edgarvela-soc/vsensor_v4_temp/images/pp1_vsensor_v4_back_NoSD.jpg

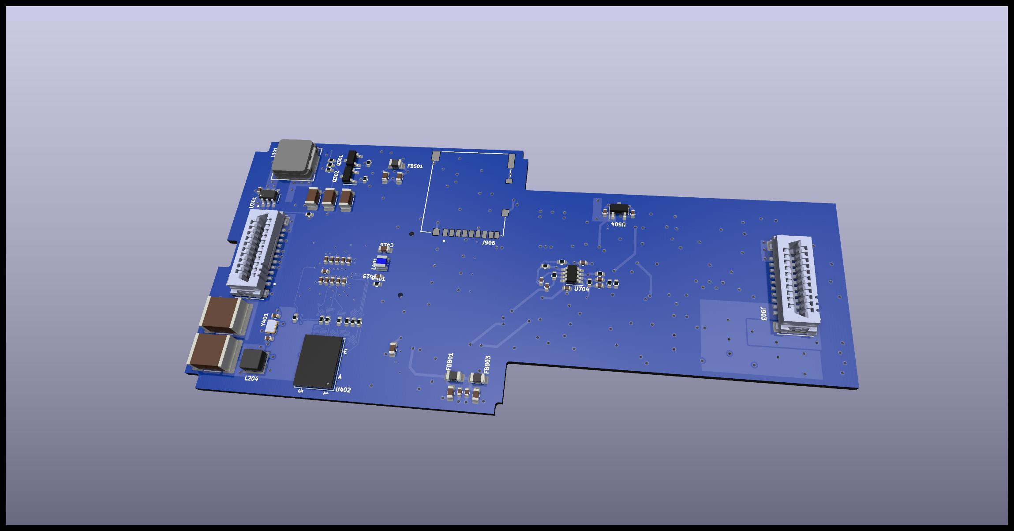
images/pp1_vsensor_v4_back_NoSD.jpg
