edgarvela-soc/vsensor_v4_temp/docs/issues.md

# Issue List

- Polarity inverted of OpAmp (U701, U702 & U704)
