edgarvela-soc/vsensor_v4_temp/docs/filter/link.txt

https://tools.analog.com/en/filterwizard/
