edgarvela-soc/vsensor_v4_temp/docs/Iftest_Report/SWOX1.0320 Erstmusterprüfbericht P1.pdf

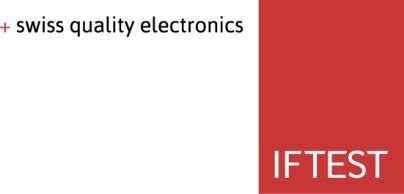
[picture p3: figure]

# QHB │ Erstmusterprüfbericht

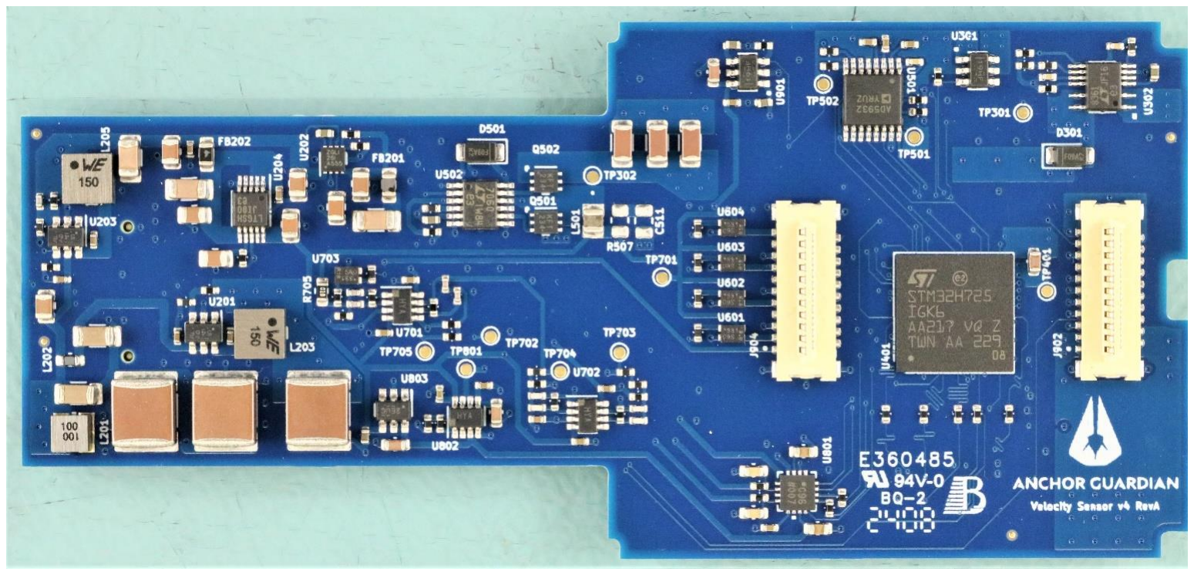
[picture p4: figure]

Hinweis bei Kopien: Gültig ist jeweils nur eine aktuelle
Kopie des im elektronischen QHB abgelegten Original! | K4│FORM 05.11│FBLAV│08.01.19│Ersatz für: NEU│1/2
Autor | Fernando Rauch
| Tel +41 56 437 32 42
| fernando.rauch@iftest.ch
Datum | 01.03.24
Kundendaten | | Iftest
Firma | Swiss Ocean Tech Ltd. | Artikel-Nr. | SP090526
Name | Stephan Nigg | Produktionsauftrag-Nr. | 1000031604
Bezeichnung | pp1 V Sensor v4
Art-Nr. | /
Bestell-Nr. | /

Foto Top-Seite

# QHB │ Erstmusterprüfbericht

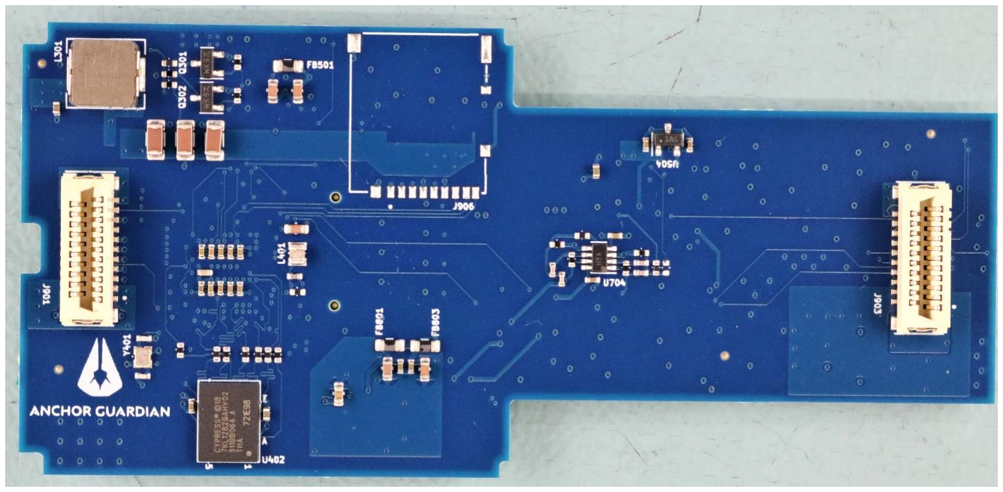
[picture p5: figure]

Hinweis bei Kopien: Gültig ist jeweils nur eine aktuelle
Kopie des im elektronischen QHB abgelegten Original! | K4│FORM 05.11│FBLAV│08.01.19│Ersatz für: NEU│2/2

Foto Bottom-Seite

Bericht

Im Produktionsprozess sind uns folgende Punkte aufgefallen. Mit der Umsetzung der empfohlenen Massnahmen helfen Sie uns die Produktionsqualität zu verbessern oder ggf. die Kosten zu senken.

Nr Befund | Empfohlene Massnahme/ Vorschlag
1) | U501 fehlt auf Bestückungszeichnung | Verbesserung der Bestückungszeichnung.
2) | diverse Bauteile Polarität unklar | Verbesserung der Bestückungszeichnung.
3) Positionen nicht immer gut erkennbar.
| Grösse der Zeichnung. | Verbesserung der Bestückungszeichnung. Vergrössern.

Wir behalten uns vor, Mehraufwände infolge nicht umgesetzter Massnahmen/ Vorschläge, bei einem Folgeauftrag zu verrechnen.
