edgarvela-soc/vsensor_v4_temp/docs/Timer_Overview.xlsx

 |  |  |  |  |  |  |  |  |  | TIMx internal trigger connection
Usage | Timer Type | Timer | Width | Counter Type | DMA Req Gen | Rep Cnt | Chan | Comp Out | Slave | ITR0 | ITR1 | ITR2 | ITR3 | ITR4 | ITR5 | ITR6 | ITR7 | ITR8 | ITR9 | ITR10 | ITR11 | ITR12 | ITR13
 | Adv. Control | TIM1 | 16 | Up, Down, Up/Down | yes | y (16b) | 4 | yes | y | TIM15 | TIM2 | TIM3 | TIM4 | - |  |  |  |  |  |  |  | TIM23 | TIM24
 | General Purp | TIM2 | 32 | Up, Down, Up/Down | yes | n | 4 | no | y | TIM1 | TIM8 | TIM3 | TIM4 | ETH PPS | USB1 OTG_ HS_ SOF | - | - | - | - | - | - | TIM23 | TIM24
 | General Purp | TIM3 | 16 | Up | yes | n | 4 | No | y | TIM1 | TIM2 | TIM15 | TIM4 | ETH PPS | - | - | - | - | - | - | - | TIM23 | TIM24
 | General Purp | TIM4 | 16 | Up | yes | n | 4 | No | y | TIM1 | TIM2 | TIM3 | TIM8 | - | - | - | - | - | - | - | - | TIM23 | TIM24
 | General Purp | TIM5 | 32 | Up, Down, Up/Down | yes | n | 4 | no | y | TIM1 | TIM8 | TIM3 | TIM4 | - | - | fdcan1 _soc | USB1 OTG_ HS_ SOF | - | - | - | - | TIM23 | TIM24
 | Basic | TIM6 | 16 | Up | yes | n | 0 | No | n
 | Basic | TIM7 | 16 | Up | yes | n | 0 | No | n
 | Adv. Control | TIM8 | 16 | Up, Down, Up/Down | yes | y (16b) | 4 | yes | y | TIM1 | TIM2 | TIM4 | TIM5 | - |  |  |  |  |  |  |  | TIM23 | TIM24
ADC SPI | General Purp | TIM12 | 16 | Up | No | n | 2 | No | y | TIM4 | TIM5 | TIM13 OC1 | TIM14 OC1
 | General Purp | TIM13 | 16 | Up | No | n | 1 | No | n
 | General Purp | TIM14 | 16 | Up | No | n | 1 | No | n
 | General Purp | TIM15 | 16 | Up | Yes | y (8b) | 2 | 1 | y | TIM1 | TIM3 | TIM16 OS1 | TIM17 OC1
 | General Purp | TIM16 | 16 | Up | Yes | y (8b) | 1 | 1 | n
 | General Purp | TIM17 | 16 | Up | Yes | y (8b) | 1 | 1 | n
 | General Purp | TIM23 | 32 | Up, Down, Up/Down | yes | n | 4 | no | y | TIM1 | TIM2 | TIM3 | TIM4 | TIM5 | TIM8 | TIM12 | TIM13 _OC1 | TIM14 _OC1 | TIM15 | TIM16 _OC1 | TIM17 _OC1 | - | TIM24
 | General Purp | TIM24 | 32 | Up, Down, Up/Down | yes | n | 4 | no | y | TIM1 | TIM2 | TIM3 | TIM4 | TIM5 | TIM8 | TIM12 | TIM13 _OC1 | TIM14 _OC1 | TIM15 | TIM16 _OC1 | TIM17 _OC1 | TIM23 | -
