edgarvela-soc/vsensor_v4_temp/pp1_vsensor_v4.png

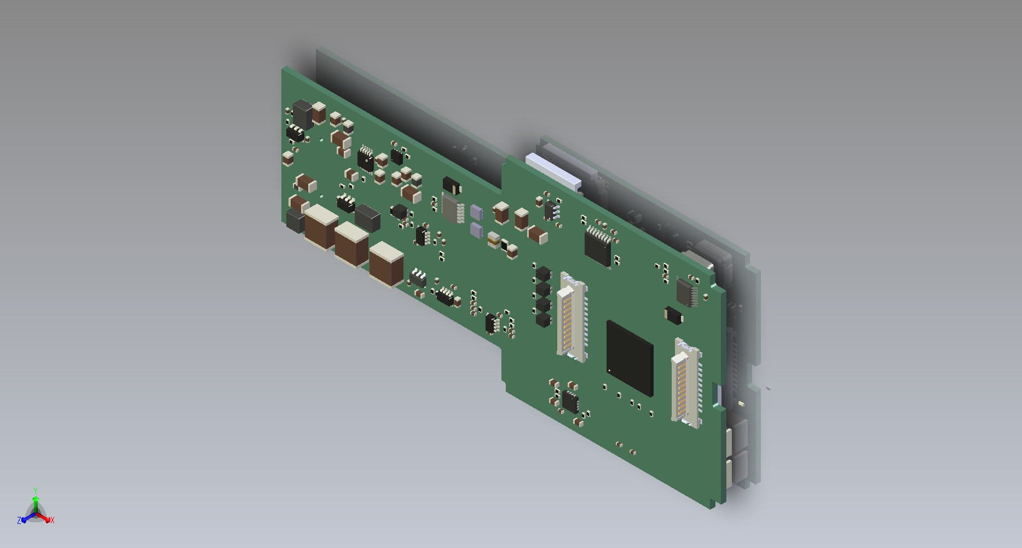
pp1_vsensor_v4.png
