edgarvela-soc/vsensor_v4_temp/BOM/pp1_vsensor_v4_RevA.xlsx

Source: | pp1_vsensor_v4
Date: | 2024-02-19
Tool: | Eeschema 7.0.10
Component Count: | 221
Component Groups: | 76
Ref | Qnty | Value | FP Lib | Footprint | MPN | Digikey_PN | Mouser_PN | Note | DNP | Description
C201, C206, C213, C214, C215, C218, C403, C404, C405, C406, C407, C408, C409, C410, C411, C412, C419, C501, C504, C506, C513, C515, C707, C714, C715, C716, C717, C718, C719, C801, C805, C812, C813, C814, C904 | 35 | 100n | Capacitor_SMD | C_0402_1005Metric | CC0402KRX7R9BB104 | 311-3566-1-ND |  |  |  | Unpolarized capacitor, small symbol
C202, C203, C207 | 3 | 22u | Capacitor_SMD | C_2220_5650Metric | C5750X7R1H226M250KB | 445-C5750X7R1H226M250KBCT-ND |  |  |  | 22u, 2220, 50V, 20%, X7R
C204, C205 | 2 | 4u7 | Capacitor_SMD | C_1206_3216Metric | GRM31CR71H475KA12K | 490-GRM31CR71H475KA12KCT-ND |  |  |  | Unpolarized capacitor, small symbol
C208, C209, C211, C220, C223, C225, C226 | 7 | 4u7 | Capacitor_SMD | C_0805_2012Metric | CGA4J3X5R1H475K125AB | 445-7882-1-ND | 810-CGA4J3X5R1H475K |  |  | Unpolarized capacitor, small symbol
C210, C304, C305, C420, C507, C512, C809, C901, C902 | 9 | 1u | Capacitor_SMD | C_0402_1005Metric | UMK105CBJ105MV-F | 587-6278-1-ND |  |  |  | Unpolarized capacitor, small symbol
C212, C219, C222 | 3 | 47u | Capacitor_SMD | C_1206_3216Metric | C3216X5R1C476M160AB | 445-6003-1-ND |  |  |  | 47uF, 1206, 16V, 20%, X5R
C216 | 1 | 39p | Capacitor_SMD | C_0402_1005Metric | CC0402FRNPO9BN390 | 311-3733-1-ND |  | NP0 |  | Unpolarized capacitor, small symbol
C217 | 1 | 2u2 | Capacitor_SMD | C_0805_2012Metric | CGA4J1X7R1V225K125AC | 445-6963-1-ND |  |  |  | Unpolarized capacitor, small symbol
C301, C302, C303, C508, C509, C510 | 6 | 1.5u | Capacitor_SMD | C_1206_3216Metric | C3216X7S2A155K160AB | 445-14816-1-ND | 810-C3216X7S2A155K1B |  |  | Unpolarized capacitor, small symbol
C306 | 1 | 2.2n | Capacitor_SMD | C_0402_1005Metric | C0402C222J5RAC7867 | 399-C0402C222J5RAC7867CT-ND |  |  |  | Unpolarized capacitor, small symbol
C307, C502 | 2 | 10n | Capacitor_SMD | C_0402_1005Metric | GCM155R71H103KA55D | 399-C0402C222J5RAC7867CT-ND |  |  |  | Unpolarized capacitor, small symbol
C401, C402 | 2 | 9p | Capacitor_SMD | C_0402_1005Metric | GRM1555C1H9R0BA01D | 490-6257-1-ND |  |  |  | Unpolarized capacitor, small symbol
C413 | 1 | 4u7 | Capacitor_SMD | C_0402_1005Metric | 04023D475MAT2A | 478-04023D475MAT2ACT-ND |  |  |  | Unpolarized capacitor, small symbol
C415 | 1 | 220p | Capacitor_SMD | C_0402_1005Metric | 0402N221J500CT | 1292-1286-1-ND |  |  |  | Unpolarized capacitor, small symbol
C416, C421, C503, C505, C802, C810, C811, C815, C903 | 9 | 10u | Capacitor_SMD | C_0603_1608Metric | GRM188R61E106MA73D | 490-7202-1-ND | 81-GRM188R61E106MA3D |  |  | Unpolarized capacitor, small symbol
C511 | 1 | tbd | Capacitor_SMD | C_0805_2012Metric |  |  |  |  | DNP | Unpolarized capacitor, small symbol
C701, C704, C708, C711 | 4 | 15p | Capacitor_SMD | C_0402_1005Metric | CC0402JRNPO9BN150 | 311-1017-1-ND |  |  |  | Unpolarized capacitor, small symbol
C702, C705, C709, C712 | 4 | 20p | Capacitor_SMD | C_0402_1005Metric | CC0402JRNPO9BN200 | 311-1417-1-ND |  |  |  | Unpolarized capacitor, small symbol
C703, C706, C710, C713 | 4 | 24p | Capacitor_SMD | C_0402_1005Metric | CC0402JRNPO9BN240 | 311-1348-1-ND |  |  |  | Unpolarized capacitor, small symbol
C803, C804, C806 | 3 | 1u | Capacitor_SMD | C_0603_1608Metric | 06035C105KAT2A | 478-10073-1-ND |  |  |  | Unpolarized capacitor, small symbol
C807, C808 | 2 | 2n7 | Capacitor_SMD | C_0603_1608Metric | CC0603KRX7R9BB272 | 311-1809-1-ND |  |  |  | Unpolarized capacitor, small symbol
D301, D501 | 2 | DFLS2100-7 | Diode_SMD | D_PowerDI-123 | DFLS2100-7 | DFLS2100-7DICT-ND |  |  |  | DIODE SCHOTTKY 100V 2A PWRDI123
FB201, FB202, FB501, FB801, FB803 | 5 | 2.2k/200mA | Inductor_SMD | L_0805_2012Metric | 742792093 | 732-1609-1-ND |  |  |  | 2.2 kOhms @ 100 MHz 0805 (2012 metrisch) 200mA 600mOhm WE-CBF
J901, J903 | 2 | 10162581-3134121LF | SOC_Connector_SMD | AMPHENOL_10162581-3134121LF | 10162581-3134121LF | 609-10162581-3134121LFCT-ND |  |  |  | Conan® Lite 1.00mm 21pin F
J902, J904 | 2 | 10162582-1134121LF | SOC_Connector_SMD | AMPHENOL_10162582-1134121LF | 10162582-1134121LF | 609-10162582-1134121LFCT-ND |  |  |  | Conan® Lite 1.00mm 21pin M
J906 | 1 | uSD_DM3AT | SOC_SMD | HRS_DM3AT-SF-PEJM5 | DM3AT-SF-PEJM5 | HR1964CT-ND |  |  | DNP
L201 | 1 | 10u | Inductor_SMD | L_Wuerth_MAPI-3020 | 74438336100 | 732-5700-1-ND |  |  |  | 10 µH shielded Inductor 1.2 A 322mOhm Max 1212 (3030 metric)
L202 | 1 | 470nH | Inductor_SMD | L_0603_1608Metric | LQM18PNR47NC0L | 490-LQM18PNR47NC0LCT-ND |  |  |  | 470 nH Geschirmt Mehrschichtig Induktor 850 mA 187,5mOhm Max 0603 (1608 metrisch)
L203, L205 | 2 | 15u 1.9A | Inductor_SMD | L_Wuerth_MAPI-4020 | 74438356150 | 732-11663-1-ND |  |  |  | FIXED IND 15UH 1.9A 230MOHM SMD
L301 | 1 | 8u2 | SOC_SMD | IND25X25CZ | IHLP2525CZER8R2M01 | 541-1012-1-ND |  |  |  | 8.2 µH Shielded Molded Inductor 4 A 68mOhm Max Nonstandard
L401 | 1 | 2.2u | SOC_SMD | Inductor_0806 | DFE201612PD-2R2M=P2 | 490-18072-1-ND | 81-DFE201612PD2R2P2 |  |  | FIXED IND 12UH 1.3A 135 MOHM SMD
L501 | 1 | 1u/4.2A | SOC_SMD | RES_CIGT201610 | CIGT201610EH1R0MNE | 1276-6900-1-ND |  |  |  | FIXED IND 12UH 1.3A 135 MOHM SMD
Q301, Q302 | 2 | PMV45EN2 | Package_TO_SOT_SMD | SOT-23 | PMV45EN2R | 1727-2307-1-ND | 771-PMV45EN2R |  |  | N-Channel 30 V 4.1A (Ta) 510mW (Ta), 5W (Tc) Surface Mount TO-236AB
Q501, Q502 | 2 | SSM6K361NU | SOC_SMD | UDFN6B_TOS | SSM6K361NU,LF | SSM6K361NULFCT-ND |  |  |  | MOSFET N-CH 100V 3.5A 6UDFNB
R201 | 1 | 69k8 | Resistor_SMD | R_0402_1005Metric | RC0402FR-0769K8L | YAG3216CT-ND |  |  |  | Resistor, small symbol
R202 | 1 | 91k | Resistor_SMD | R_0402_1005Metric | RC0402FR-0791KL | 311-91.0KLRCT-ND |  |  |  | Resistor, small symbol
R203, R209, R305 | 3 | 22k1 | Resistor_SMD | R_0402_1005Metric | RC0402FR-0722K1L | 311-22.1KLRCT-ND |  |  |  | Resistor, small symbol
R204, R210, R702, R713 | 4 | 40k2 | Resistor_SMD | R_0402_1005Metric | RC0402FR-0740K2L | 311-40.2KLRCT-ND |  |  |  | Resistor, small symbol
R207 | 1 | 102k | Resistor_SMD | R_0402_1005Metric | RC0402FR-07102KL | YAG2944CT-ND |  |  |  | Resistor, small symbol
R208, R309, R310, R311, R501, R502, R505, R703, R712, R720, R912 | 11 | 68k1 | Resistor_SMD | R_0402_1005Metric | RC0402FR-0768K1L | YAG3213CT-ND |  |  |  | Resistor, small symbol
R301 | 1 | 1M | Resistor_SMD | R_0402_1005Metric | CRGCQ0402F1M0 | A129663CT-ND |  |  |  | Resistor, small symbol
R302 | 1 | 34k8 | Resistor_SMD | R_0402_1005Metric | RMCF0402FT34K8 | RMCF0402FT34K8CT-ND |  |  |  | Resistor, small symbol
R303, R701 | 2 | 71k5 | Resistor_SMD | R_0402_1005Metric | RC0402FR-0771K5L | YAG3222CT-ND |  |  |  | Resistor, small symbol
R304 | 1 | 130k | Resistor_SMD | R_0402_1005Metric | RC0402FR-07130KL | YAG2969CT-ND |  |  |  | Resistor, small symbol
R306 | 1 | 0R | Resistor_SMD | R_0402_1005Metric | RC0402JR-070RL | 311-0.0JRCT-ND |  |  |  | Resistor, small symbol
R307, R308, R401, R714, R715, R721, R722, R806, R807 | 9 | 10k | Resistor_SMD | R_0402_1005Metric | RC1005F103CS | 1276-3431-1-ND |  |  |  | Resistor, small symbol
R402, R403, R404, R405, R406, R407, R408, R409, R410, R411, R412, R413, R503, R504 | 14 | 33R | Resistor_SMD | R_0402_1005Metric | RC0402JR-0733RL | 311-33JRCT-ND |  |  |  | Resistor, small symbol
R506 | 1 | 36k5 | Resistor_SMD | R_0402_1005Metric | ERJ-2RKF3652X | P36.5KLCT-ND |  |  |  | Resistor, small symbol
R507 | 1 | 2R | Resistor_SMD | R_0805_1608Metric | RMCF0603FT2R00 | RMCF0603FT2R00CT-ND |  |  | DNP | Resistor, small symbol
R601, R602, R603, R604, R710 | 5 | 270R | Resistor_SMD | R_0402_1005Metric | RMCF0402FT270R | RMCF0402FT270RCT-ND |  |  |  | Resistor, small symbol
R704 | 1 | 20k5 | Resistor_SMD | R_0402_1005Metric | RC0402FR-0720K5L | YAG3052CT-ND |  |  |  | Resistor, small symbol
R705 | 1 | 100k | Resistor_SMD | R_0603_1608Metric | RC0402FR-07100KL | 311-100KLRCT-ND |  |  |  | Resistor, small symbol
R706 | 1 | 19k6 | Resistor_SMD | R_0402_1005Metric | RC0402FR-0719K6L | YAG3026CT-ND |  |  |  | Resistor, small symbol
R707, R709, R717, R718 | 4 | 2k55 | Resistor_SMD | R_0402_1005Metric | RC0402FR-072K55L | YAG3102CT-ND |  |  |  | Resistor, small symbol
R708 | 1 | 1k58 | Resistor_SMD | R_0402_1005Metric | RC0402FR-071K58L | YAG3041CT-ND |  |  |  | Resistor, small symbol
R711, R719 | 2 | 1k47 | Resistor_SMD | R_0402_1005Metric | RC0402FR-071K47L | YAG3038CT-ND |  |  |  | Resistor, small symbol
R716 | 1 | 0R | Resistor_SMD | R_0402_1005Metric | RC0402JR-070RL | 311-0.0JRCT-ND |  |  | DNP | Resistor, small symbol
R801, R802 | 2 | 20R | Resistor_SMD | R_0402_1005Metric | RC0402FR-0720RL | 311-20LRCT-ND |  |  |  | Resistor, small symbol
R803, R804 | 2 | 100R | Resistor_SMD | R_0402_1005Metric | RC0402FR-07100RL | 311-100LRCT-ND |  |  |  | Resistor, small symbol
U201, U203 | 2 | LMR54406 | Package_TO_SOT_SMD | SOT-23-6 | LMR54406FDBVR | 296-LMR54406FDBVRCT-ND | 595-LMR54406FDBVR |  |  | Schaltspannungsregler SIMPLE SWITCHER power converter 4.5-V to 36-V, 0.6-A, synchronous buck with 80-uA IQ
U202 | 1 | LM27761 | Package_SON | WSON-8-1EP_2x2mm_P0.5mm_EP0.9x1.6mm | LM27761DSGR | 296-44379-1-ND |  |  |  | low-noise regulated switched-capacitor voltage inverter with 2.7V-5.5V input to -1.5 to -5V Output Voltage, WSON-8
U204 | 1 | LT3042EMSE | Package_SO | MSOP-10-1EP_3x3mm_P0.5mm_EP1.68x1.88mm | LT3042EMSE#TRPBF | LT3042EMSE#TRPBFCT-ND | 584-LT3042EMSE#TRPBF |  |  | 200mA, Adjustable, Ultralow Noise, Ultrahigh PSRR RF Linear Regulator, MSOP-10
U301, U901 | 2 | TPS22810DBV | SOC_SMD | SOT95P280X145-6N | TPS22810TDBVRQ1 | 296-50496-1-ND |  |  |  | 2.7-18V, 79mohms On-Resistance Load Switch With Thermal Protection, SOT23-6
U302 | 1 | LT8361 | SOC_SMD | SOP50P490X110-17N | LT8361HMSE#PBF | 505-LT8361HMSE#PBF-ND |  |  |  | IC REG Boost SEPIC 2A 16MSOP
U401 | 1 | STM32H725IGK6 | Package_BGA | UFBGA-201_10x10mm_Layout15x15_P0.65mm | STM32H725IGK6 | 497-STM32H725IGK6-ND |  |  |  | STMicroelectronics Arm Cortex-M7 MCU, 1024KB flash, 564KB RAM, 550 MHz, 1.62-3.6V, 132 GPIO, UFBGA176
U402 | 1 | S70KL1282 | SOC_BGA | S27KS0642GABHV020_1 | S70KL1282GABHV020 | 448-S70KL1282GABHV020-ND |  |  |  | PSRAM (Pseudo-SRAM) Speicher IC 64Mbit HyperBus 200 MHz 35 ns 24-FBGA (6x8)
U501 | 1 | AD5932YRUZ | SOC_SMD | AD5932YRUZ | AD5932YRUZ | 505-AD5932YRUZ-ND | 584-AD5932YRUZ
U502 | 1 | LTC7060IMSE-PBF | SOC_SMD | LTC7060 | LTC7060IMSE#WTRPBF | 505-LTC7060EMSE#WPBF-ND | 584-7060IMSE#WTRPBF
U504 | 1 | TLV760_12 | Package_TO_SOT_SMD | SOT-23 | TLV76012DBZR | 296-48331-1-ND
U601, U602, U603, U604, U703 | 5 | TLP3409STP_E | SOC_SMD | TLP3409STP_E | TLP3409S(TP,E | TLP3409S(TPECT-ND | 757-TLP3409STPE |  |  | SSR RELAY SPST-NO 650MA 0-100V
U701, U702, U704, U802 | 4 | AD8039 | Package_TO_SOT_SMD | SOT-23-8 | AD8039ARTZ-REEL7 | 505-AD8039ARTZ-REEL7CT-ND |  |  |  | IC OPAMP VFB 2 CIRCUIT SOT23-8
U801 | 1 | AD7383 | SOC_SMD | AD7383 | AD7383BCPZ-RL7 | 505-AD7383BCPZ-RL7CT-ND |  |  |  | 16 Bit Analog to Digital Converter 2 Input 2 SAR 16-LFCSP (3x3)
U803 | 1 | REF3430 | SOC_SMD | REF3430 | REF3430TIDBVR | 296-REF3430TIDBVRCT-ND
Y401 | 1 | ECX-1637_25MHz | SOC_SMD | XTAL_ECS-160-9-37-CKM-TR | ECS-250-8-37-RWN-TR | XC2484CT-ND |  |  |  | 25 MHz ±10ppm Crystal 8pF 80 Ohms 4-SMD, No Lead
