edgarvela-soc/vsensor_v4_temp/docs/Inital_operation_measurement.docx

Setting: VSEL0_Pin = 0, VSEL1_Pin = 1

36.4V on Driver

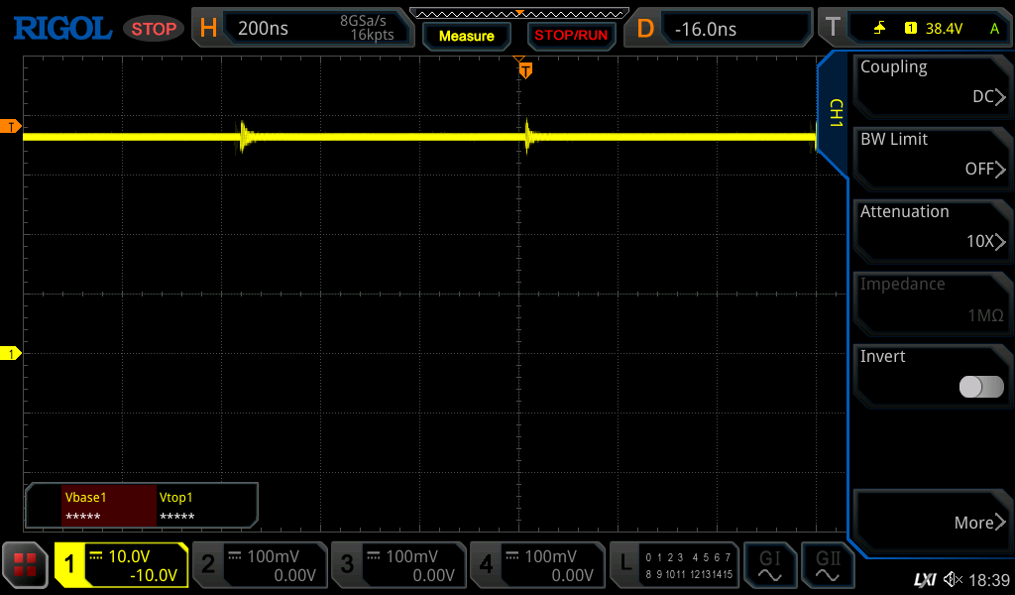
[picture p7: figure]

TP701

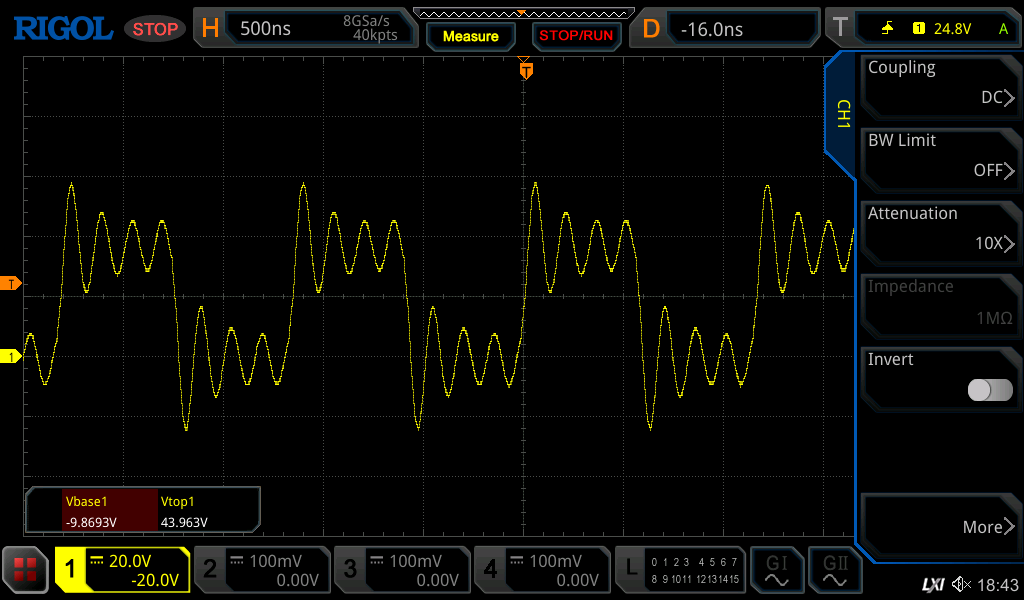
[picture p8: figure]

TP705

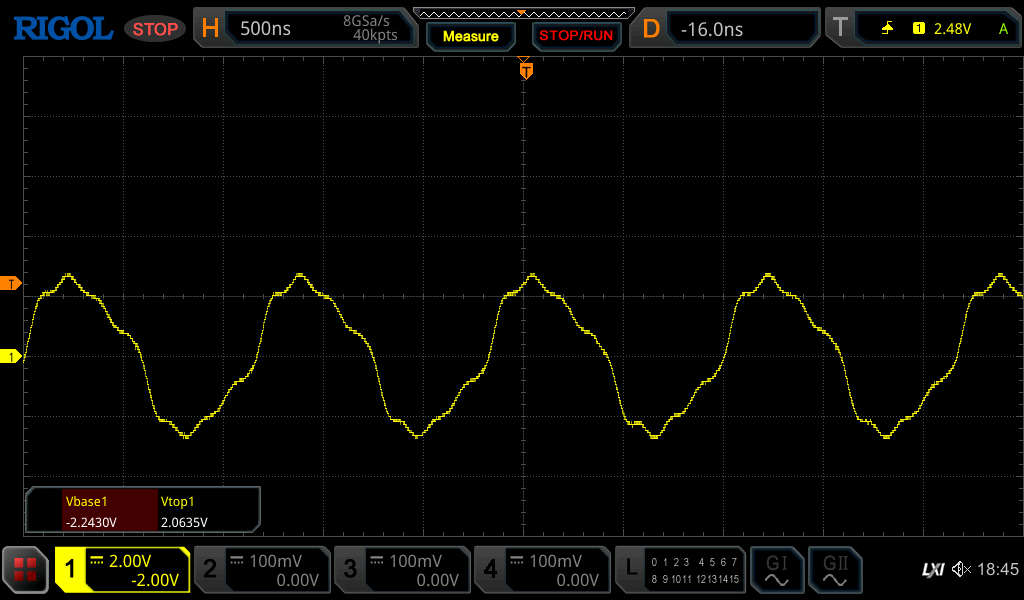
[picture p9: figure]

TP704

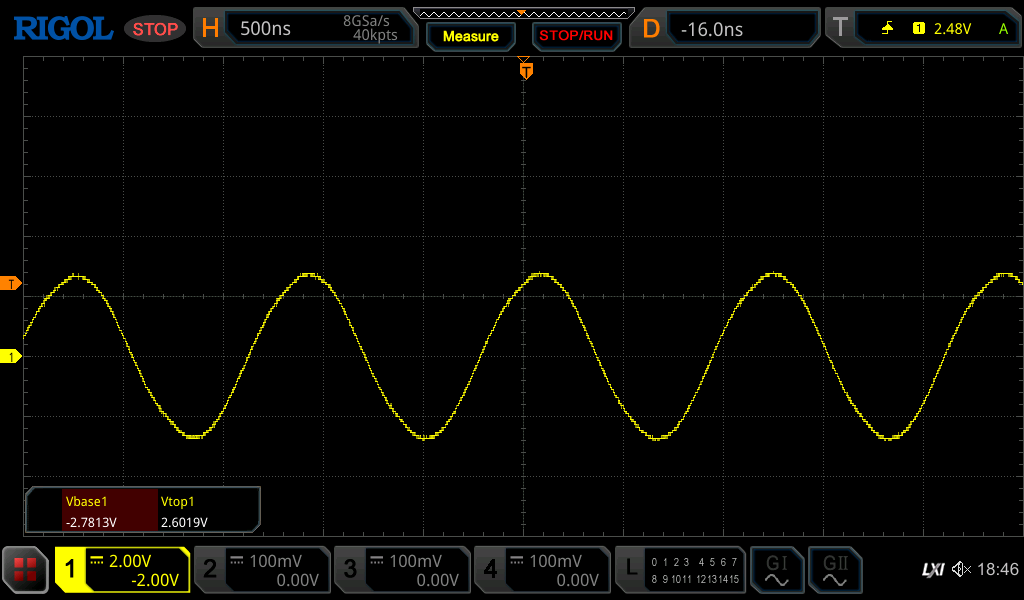
[picture p10: figure]

ADC1_IN

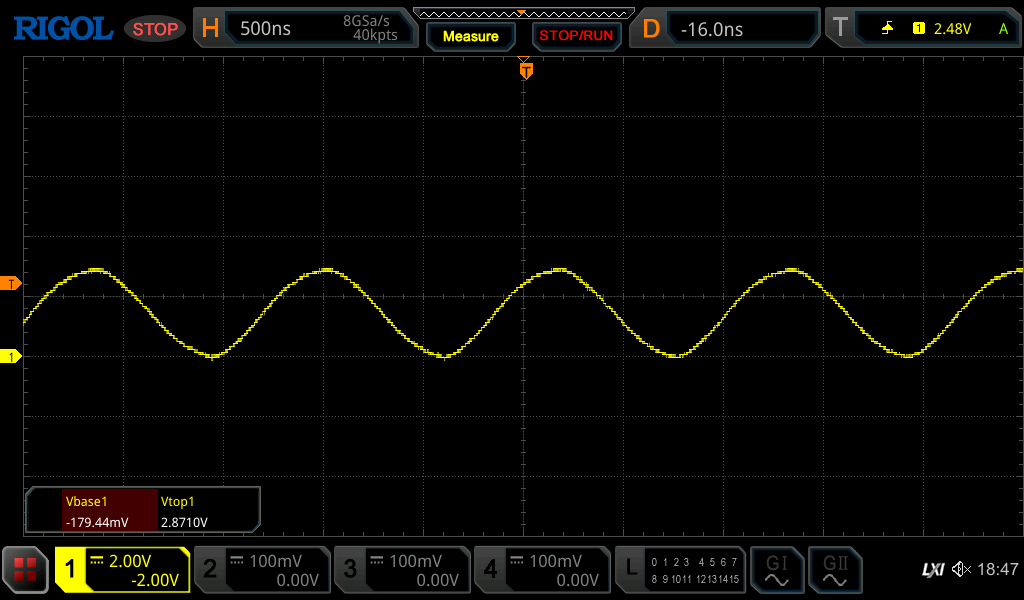
[picture p11: figure]

Input attenuation enabled (AFE_GAIN2_Pin = 1)

TP705

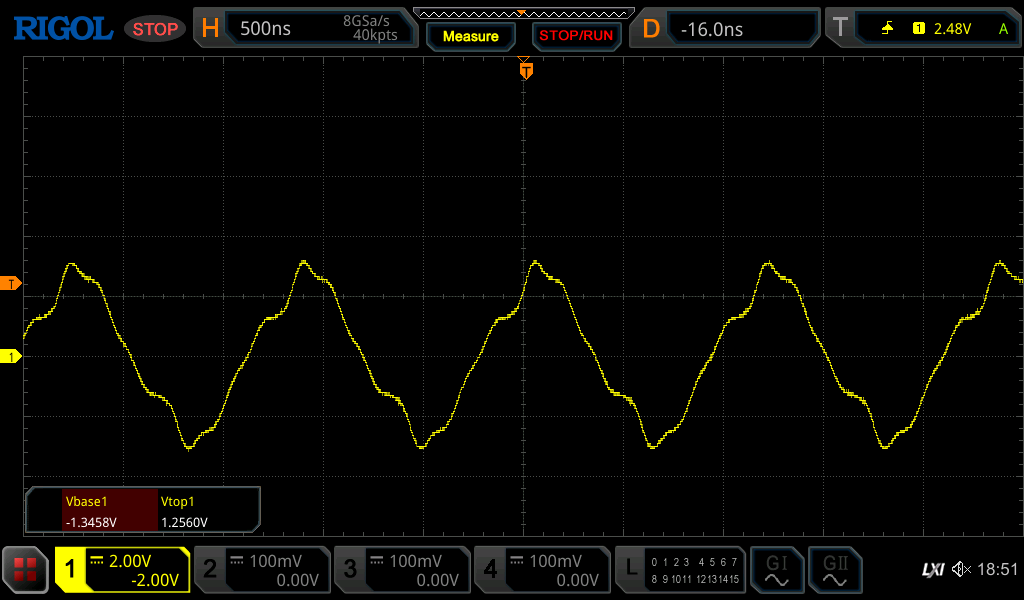
[picture p12: figure]

TP704

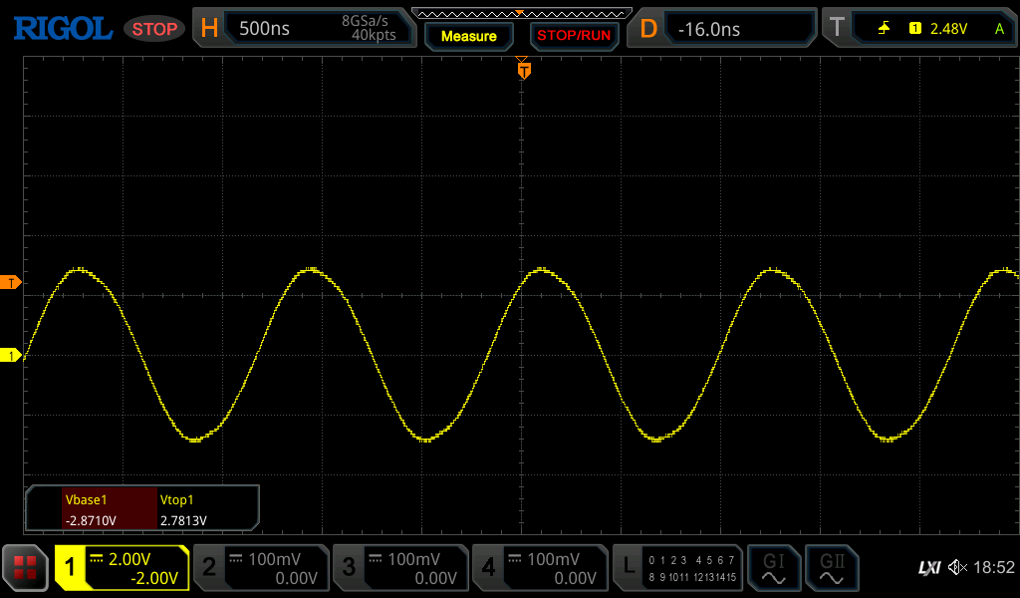
[picture p13: figure]

ADC1_IN

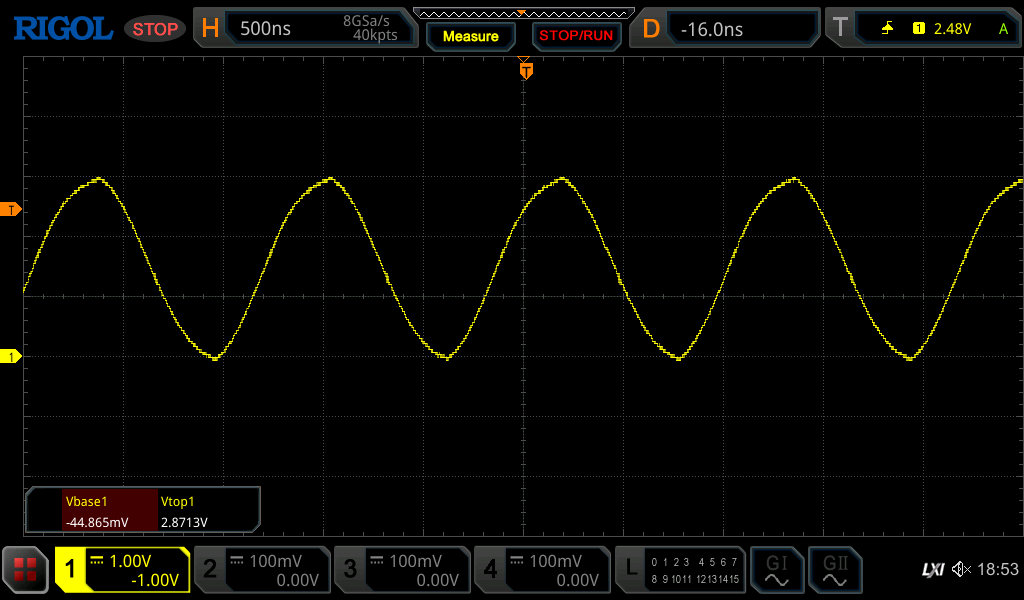
[picture p14: figure]

60V (59.8V)

Transducer (questioable probe attenuation 20x or 10x ???)

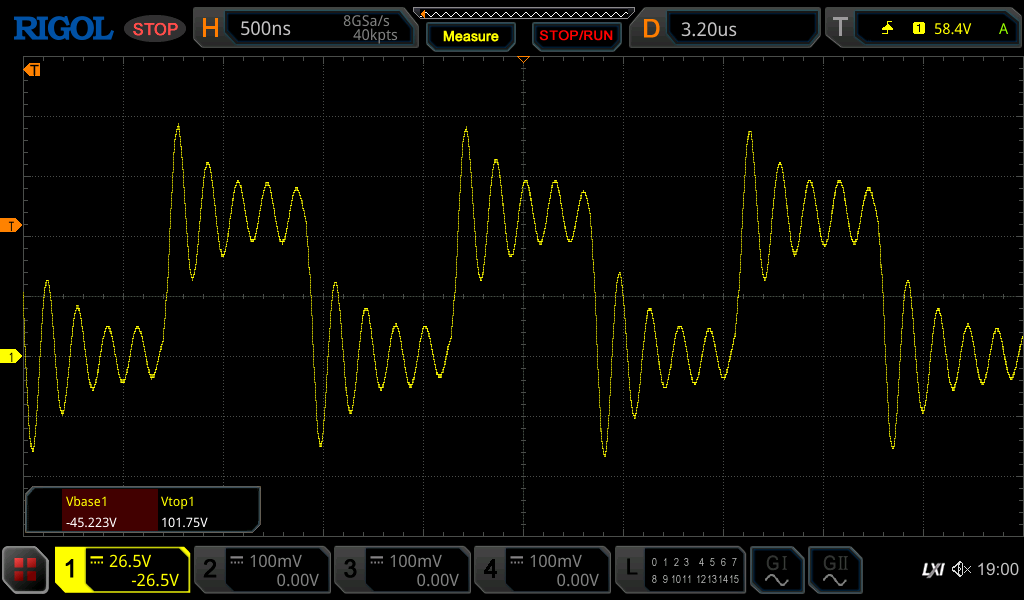
[picture p15: figure]

TP701

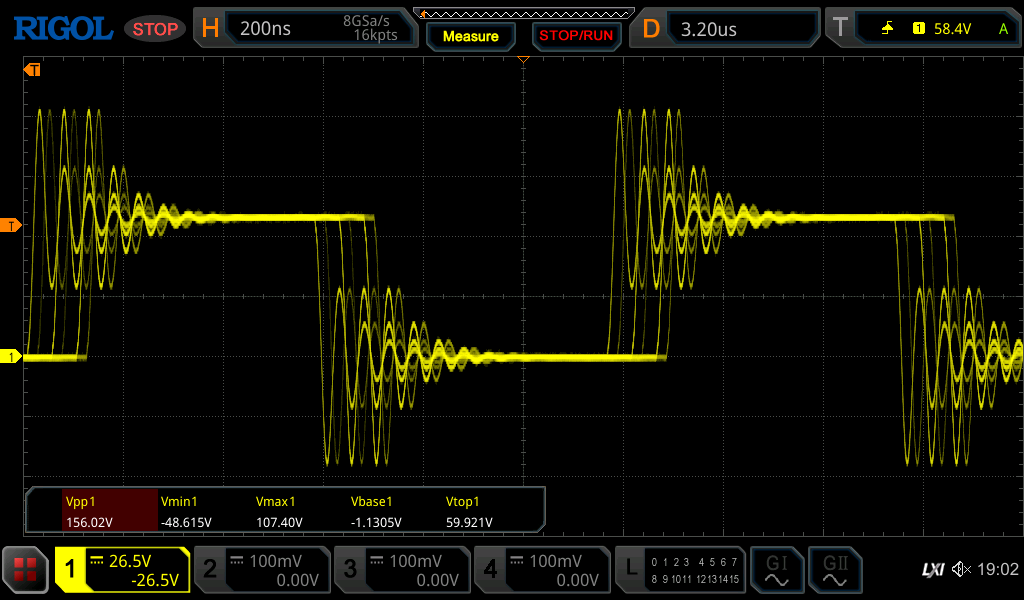
[picture p16: figure]

TP705

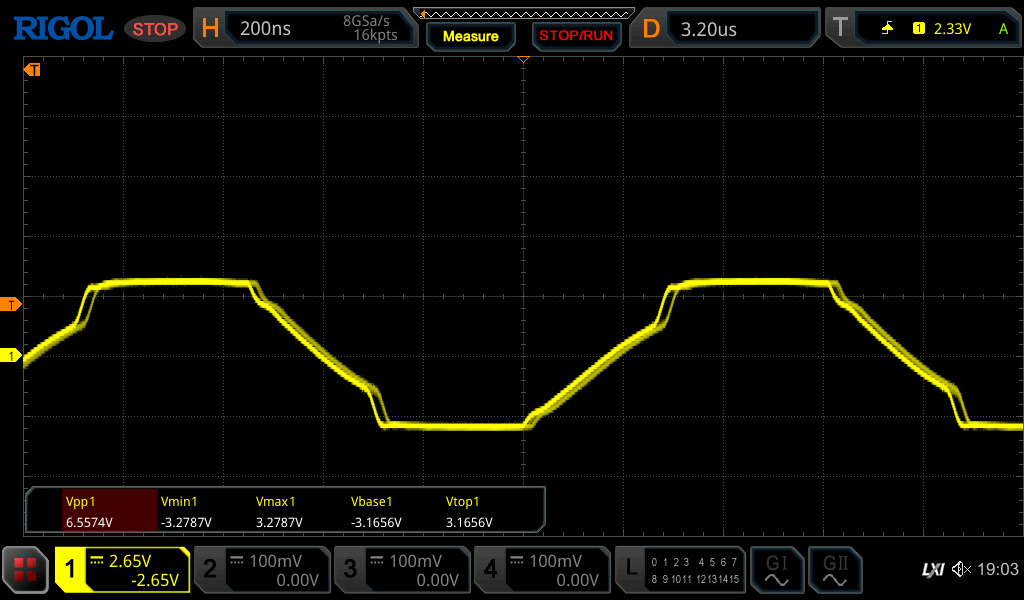
[picture p17: figure]

TP704

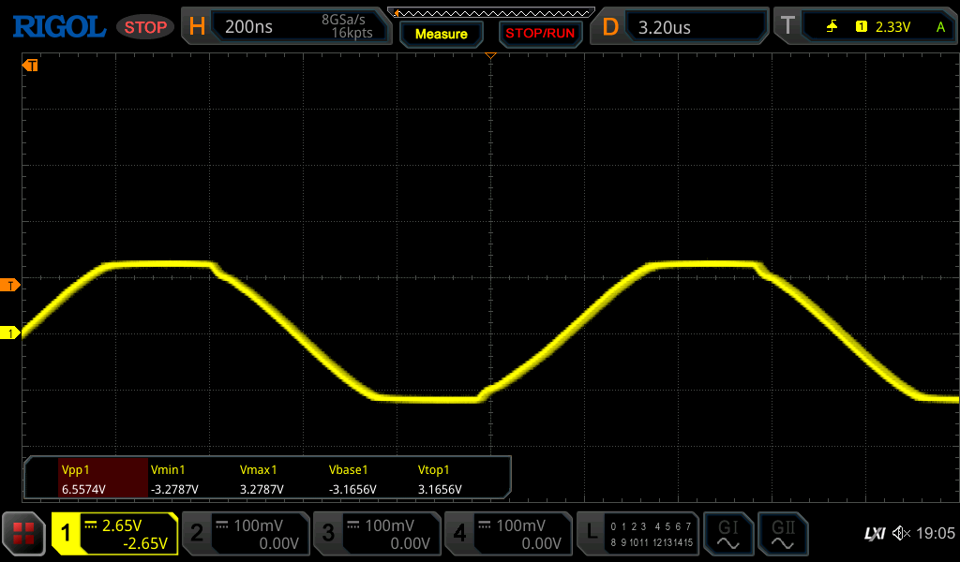
[picture p18: figure]

ADC1_IN

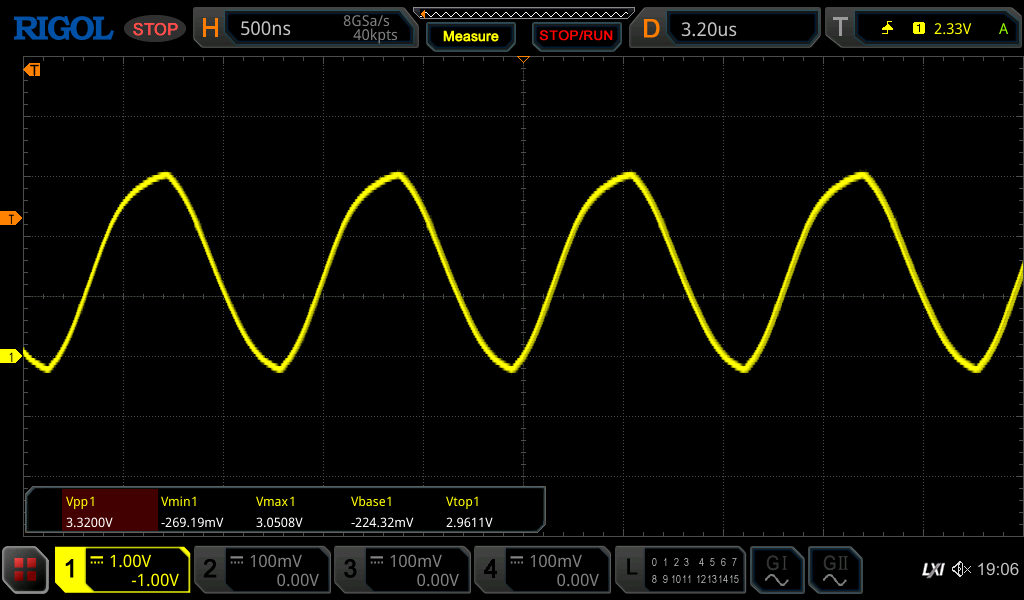
[picture p19: figure]

DC Supply: 15V, Ipeak (visible) ~176mA
