edgarvela-soc/vsensor_v4_temp/docs/HyperRAM_TrackTune.xlsx

 | uC | RAM | uC | RAM
DQ0 | 12.23 | 13.6 | 12.2 | 10
DQ1 | 10.67 | 13.23 | 12.2 | 10
DQ2 | 12.23 | 13.6 | 12.2 | 10
DQ3 | 12.23 | 13.6 | 12.2 | 10
DQ4 | 12.6 | 13.2 | 12.2 | 10
DQ5 | 12.19 | 13.7 | 12.19 | 9.98
DQ6 | 11.44 | 13.2 | 12.2 | 10
DQ7 | 12.6 | 13.23 | 12.2 | 10
RWDS | 12.6 | 13.3 | 12.2 | 10
Ck | 12.6 | 13.6 | 12.2 | 9.995
CS | 12.66 | 13.2 | 12.3 | 13.04
