edgarvela-soc/vsensor_v4_temp/schematics/pp1_vsensor_v4.pdf

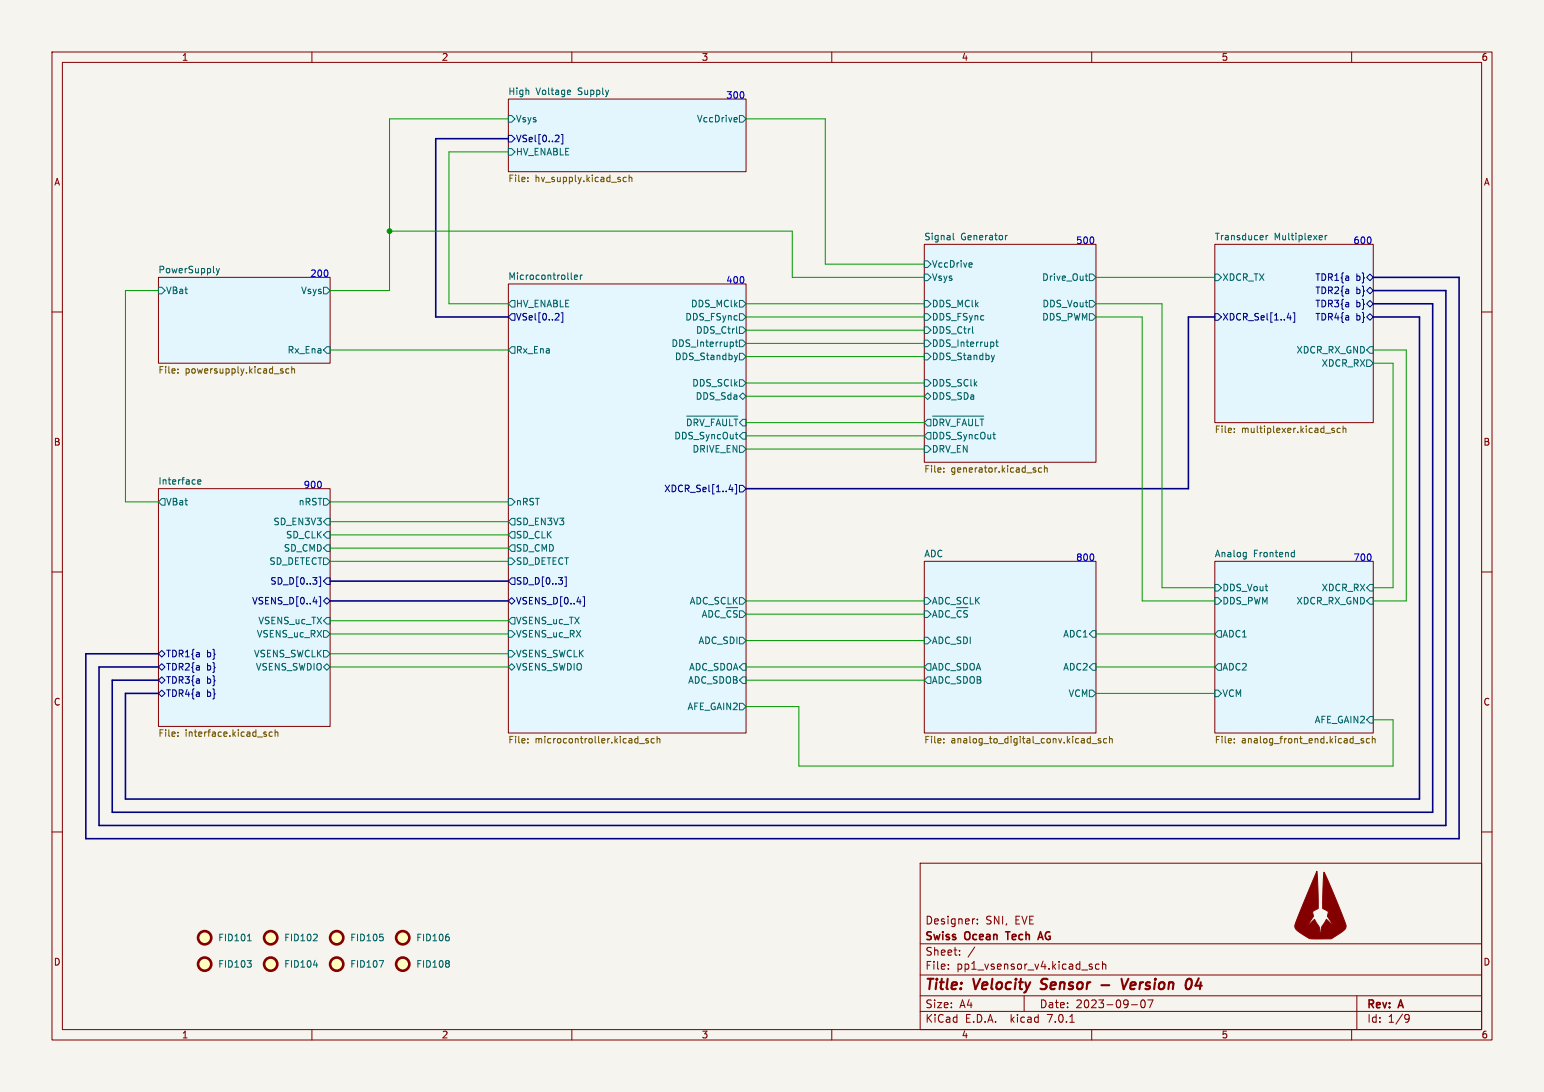
[picture p24: page 1]

Id: 1/9 Title: Velocity Sensor - Version 04

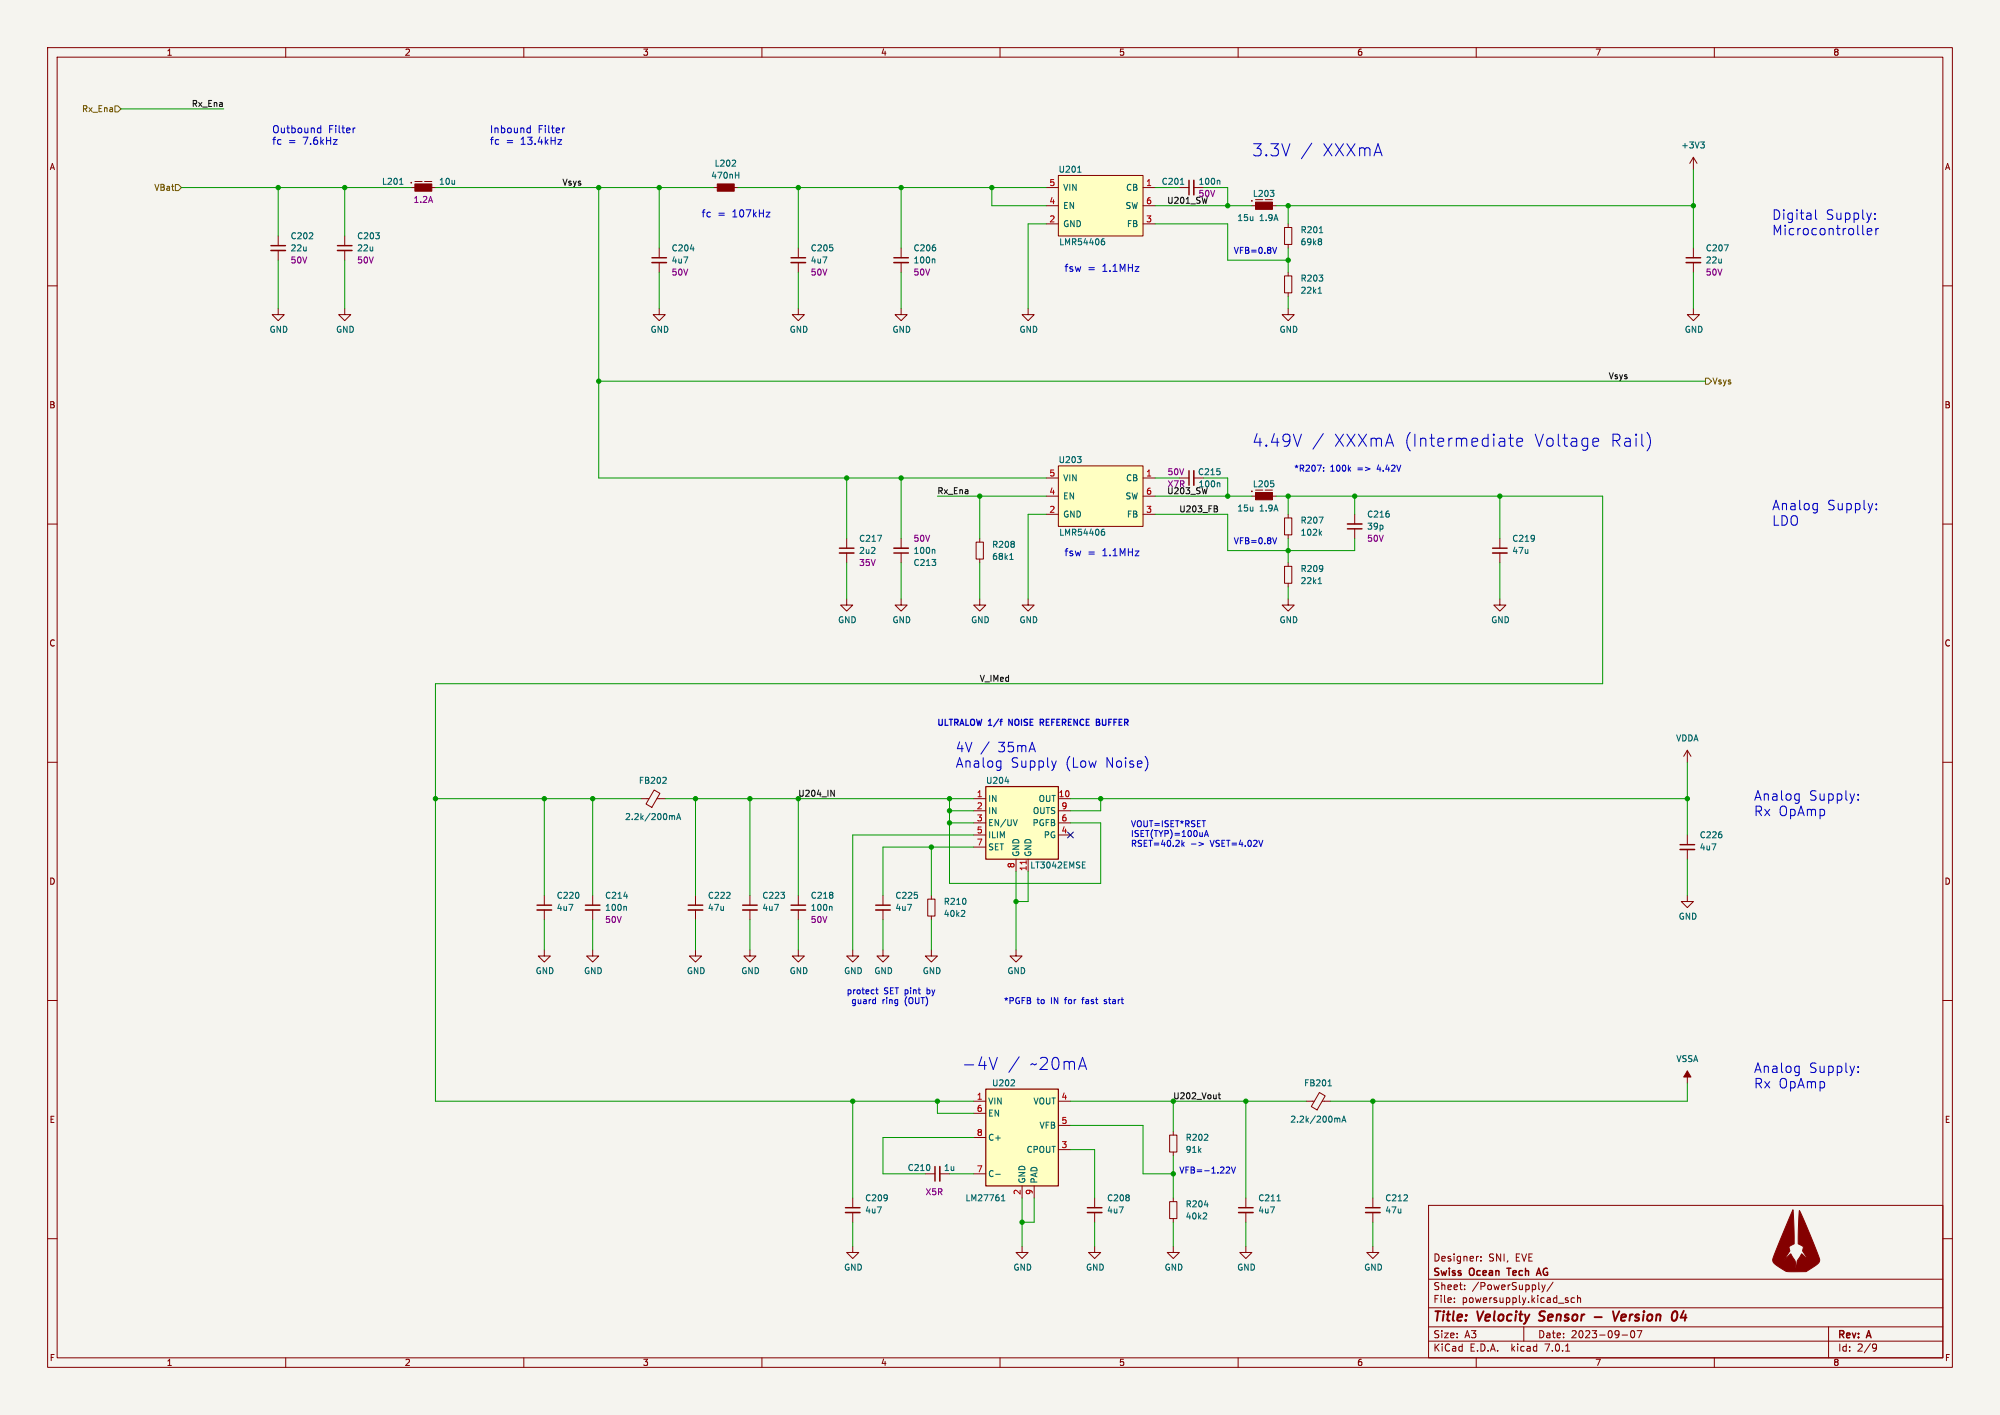
[picture p25: page 2]

Analog Supply (Low Noise)

protect SET pint by
guard ring (OUT)

2 CPOUT 3 VOUT 4 VFB 5 EN 6 C- 7 C+ 8 PAD

Id: 2/9 Title: Velocity Sensor - Version 04

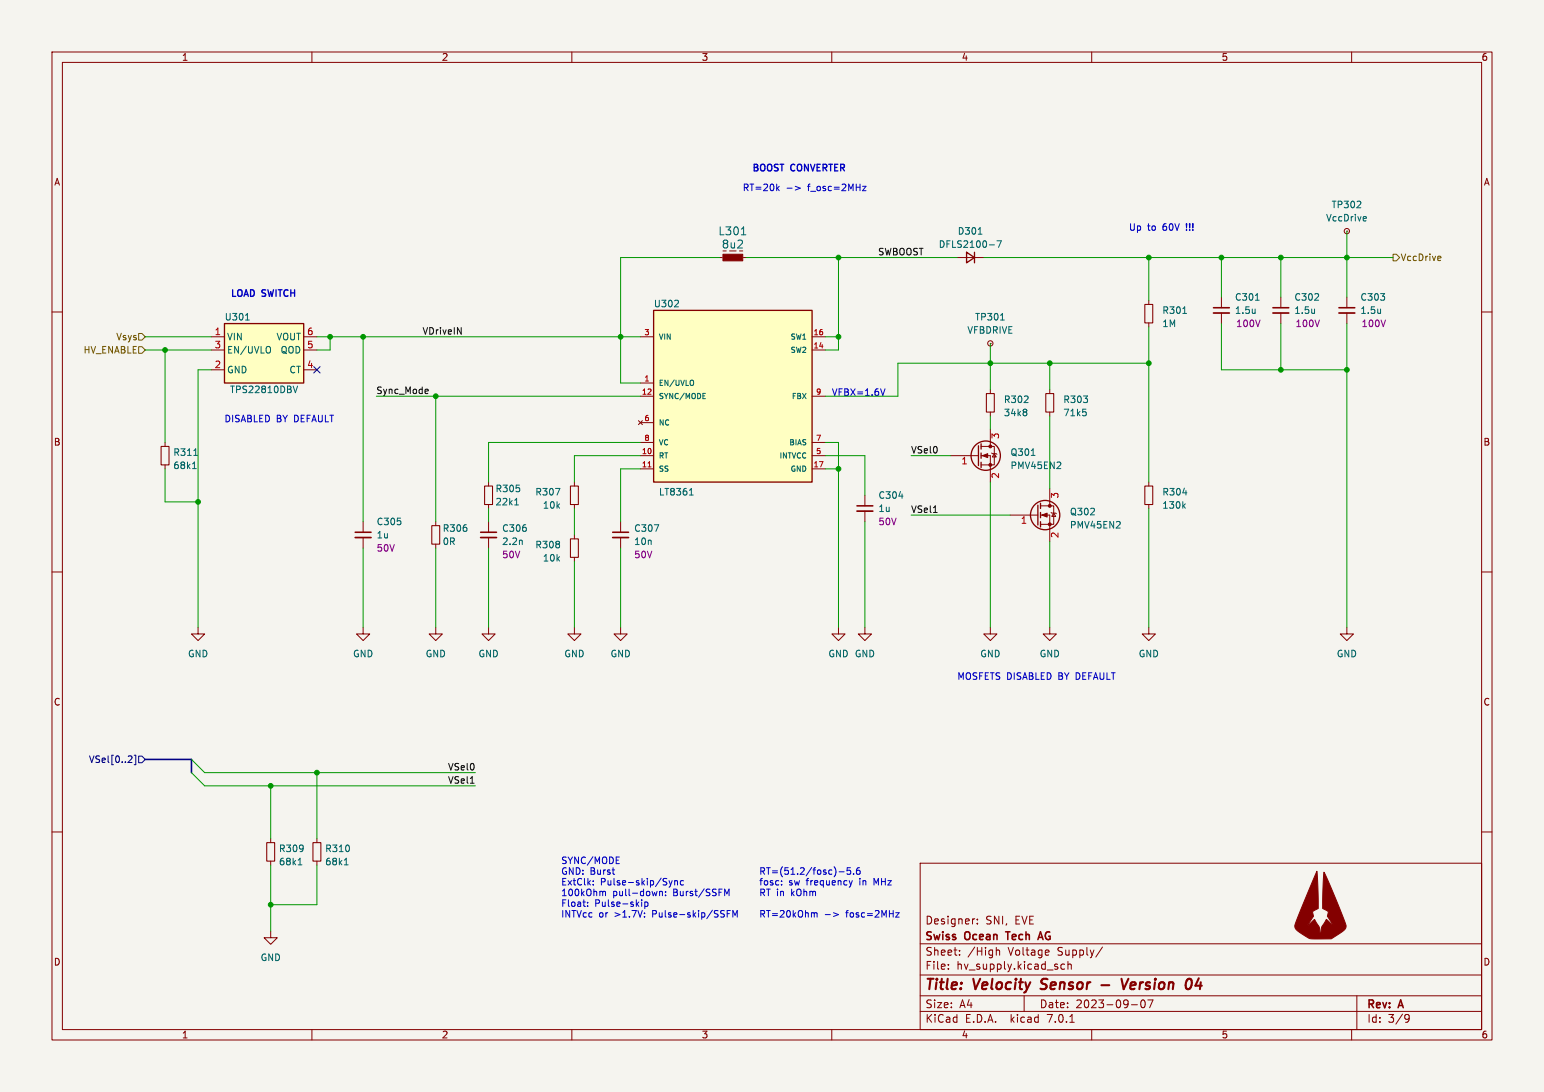
[picture p26: page 3]

MOSFETS DISABLED BY DEFAULT

Float: Pulse-skip
INTVcc or >1.7V: Pulse-skip/SSFM

Id: 3/9 Title: Velocity Sensor - Version 04

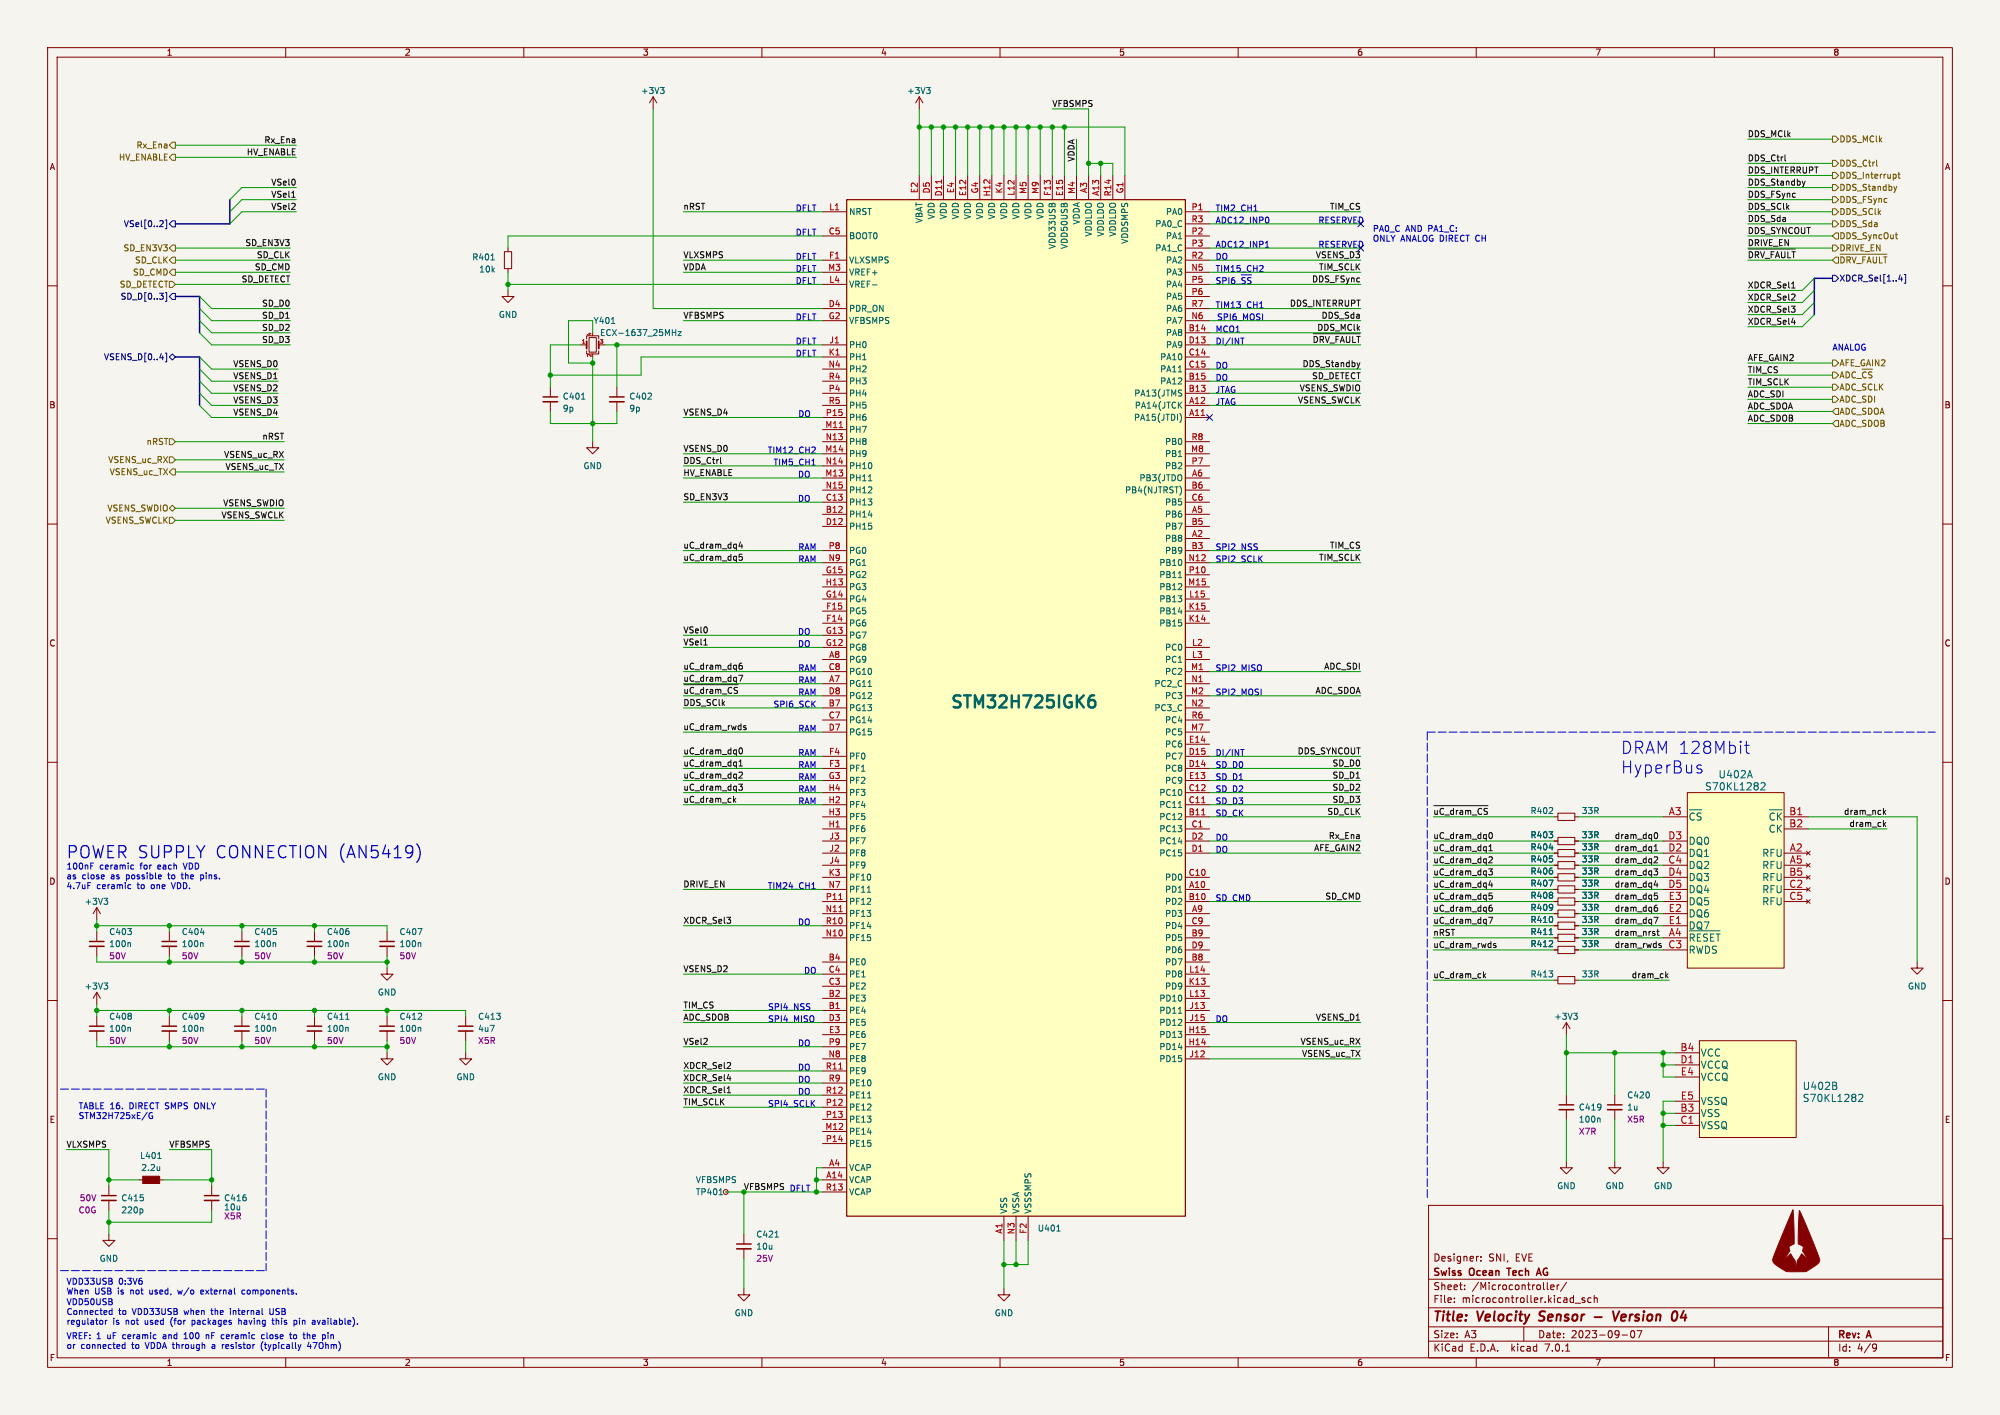
[picture p27: page 4]

DFLT DFLT POWER SUPPLY CONNECTION (AN5419)

PA0_C AND PA1_C: ONLY ANALOG DIRECT CH

100nF ceramic for each VDD
as close as possible to the pins. 4.7uF ceramic to one VDD.

Id: 4/9 Title: Velocity Sensor - Version 04

VREF: 1 uF ceramic and 100 nF ceramic close to the pin

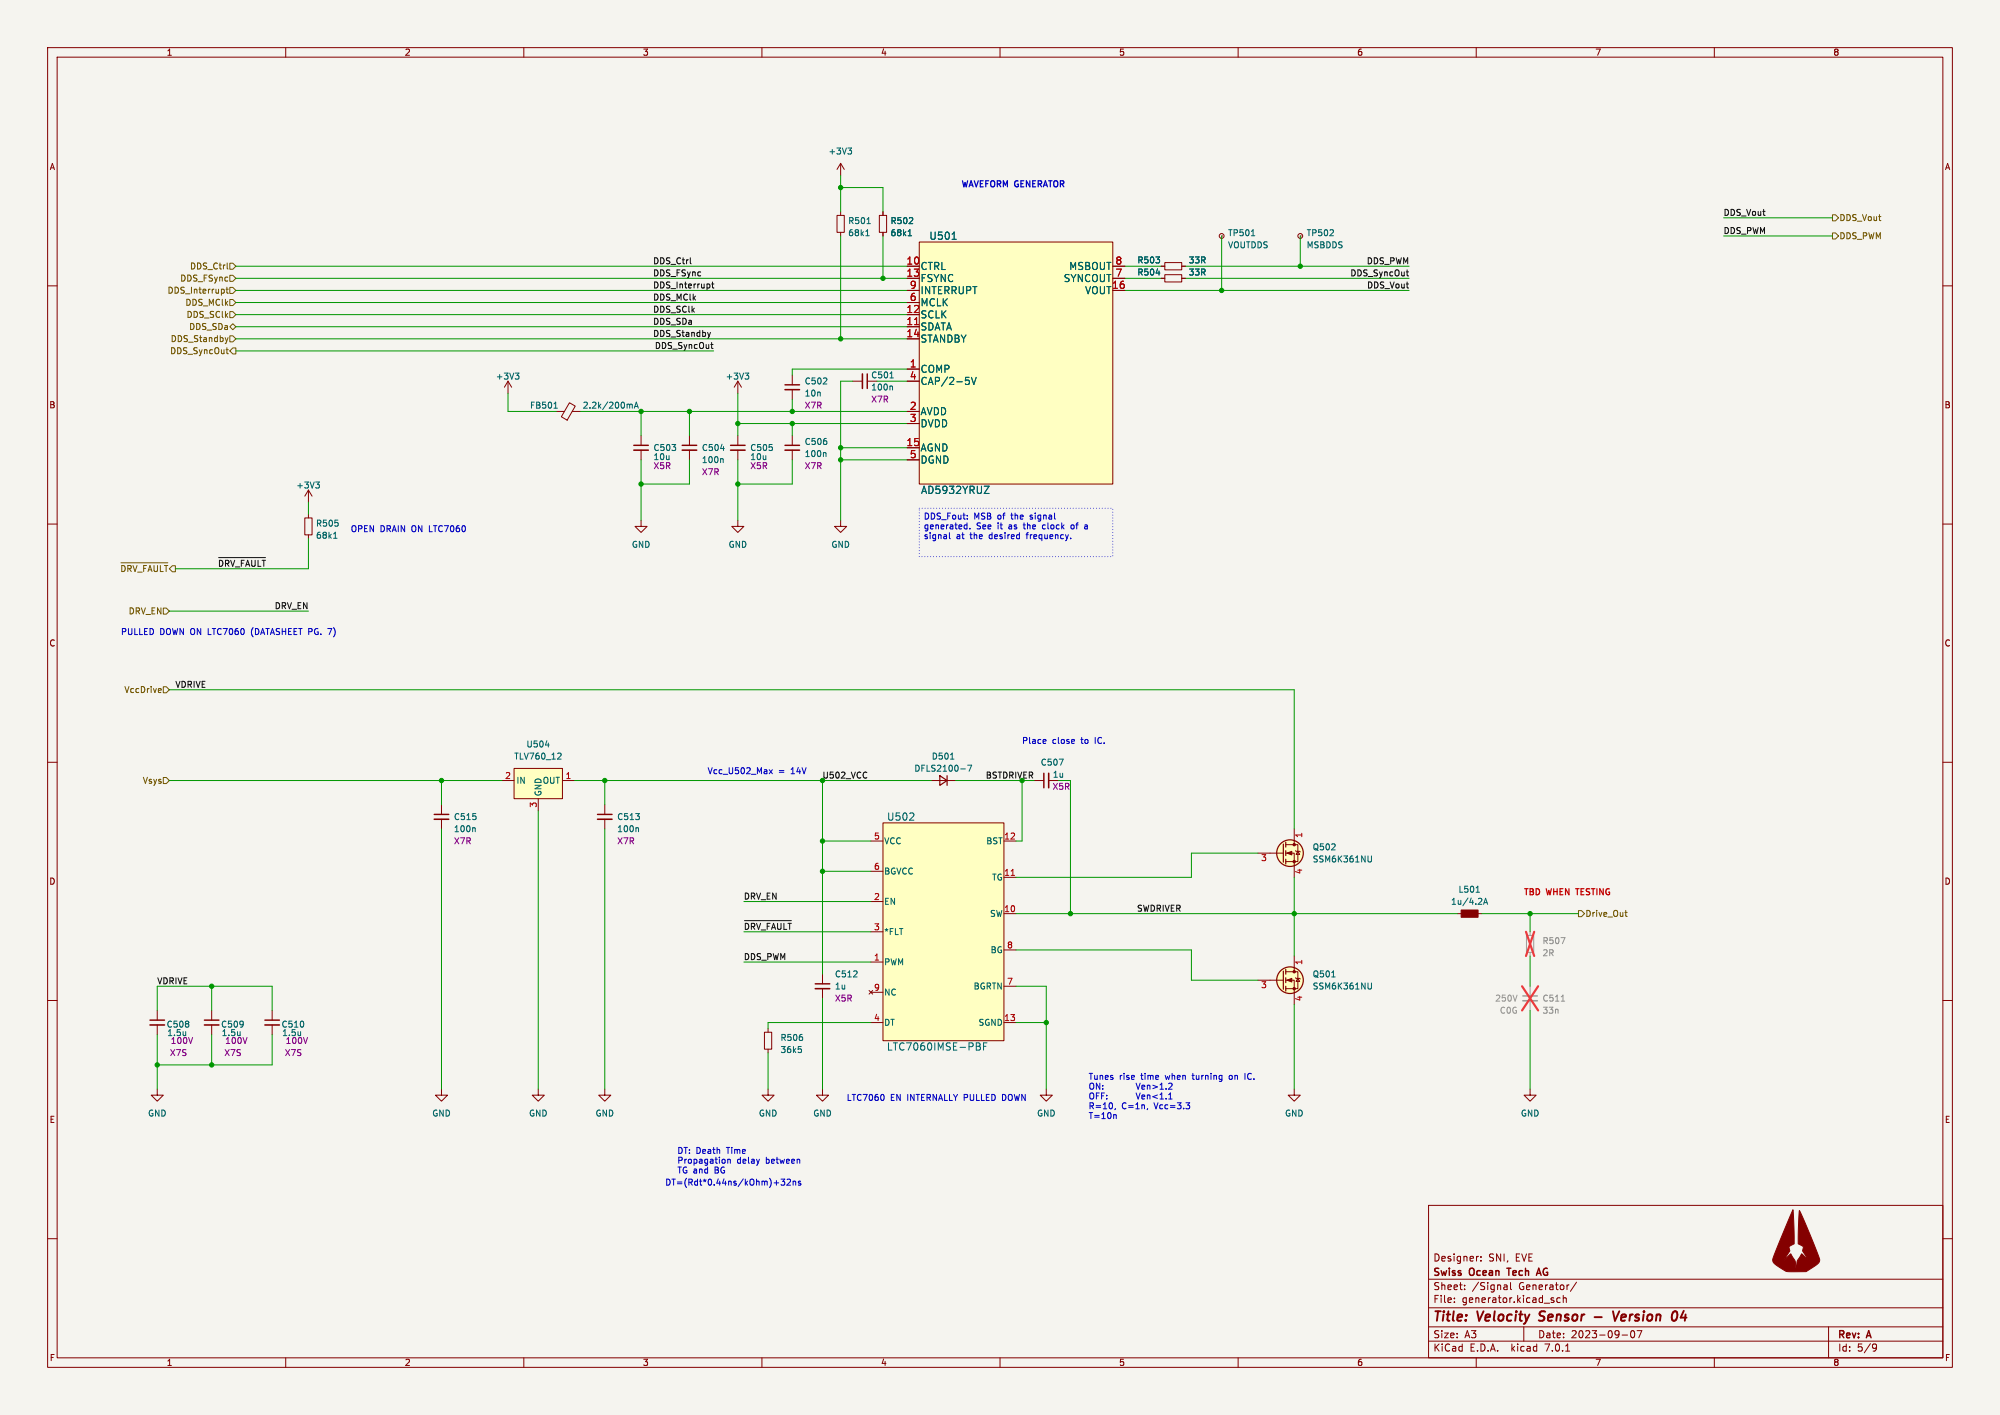
[picture p28: page 5]

signal at the desired frequency. R502

DDS_Fout: MSB of the signal

Place close to IC. Tunes rise time when turning on IC. ON: Ven>1.2 OFF: Ven<1.1 R=10, C=1n, Vcc=3.3 T=10n

LTC7060 EN INTERNALLY PULLED DOWN

Id: 5/9 Title: Velocity Sensor - Version 04

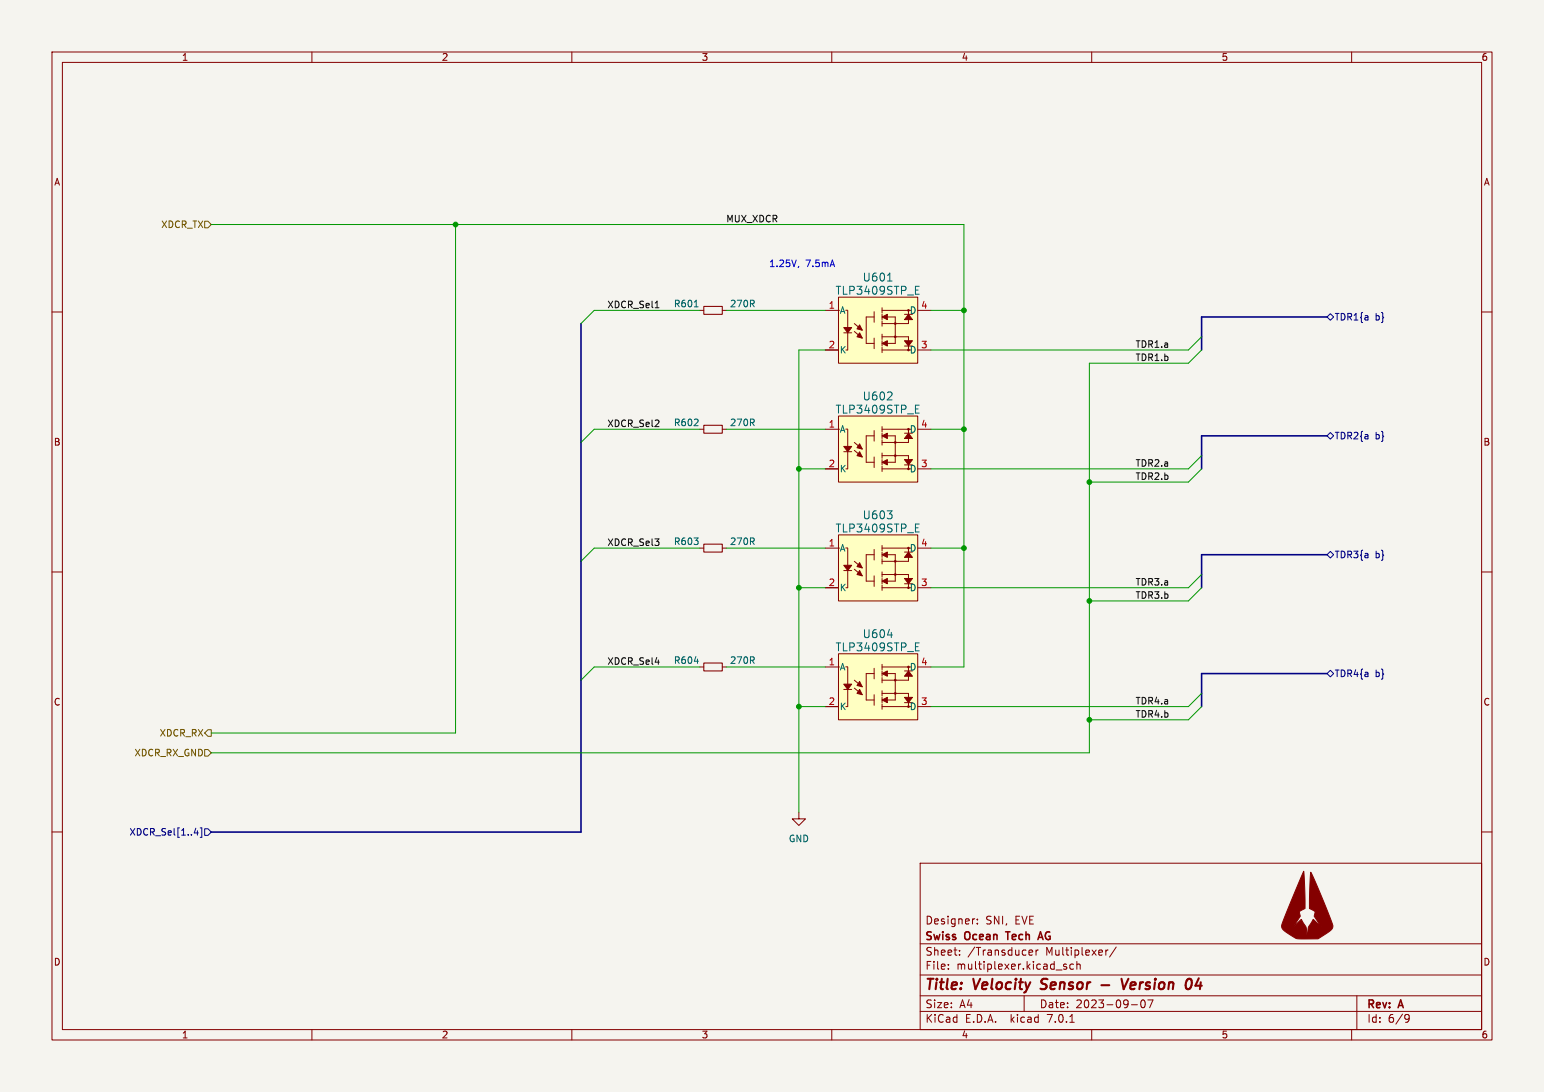
[picture p29: page 6]

Id: 6/9 Title: Velocity Sensor - Version 04

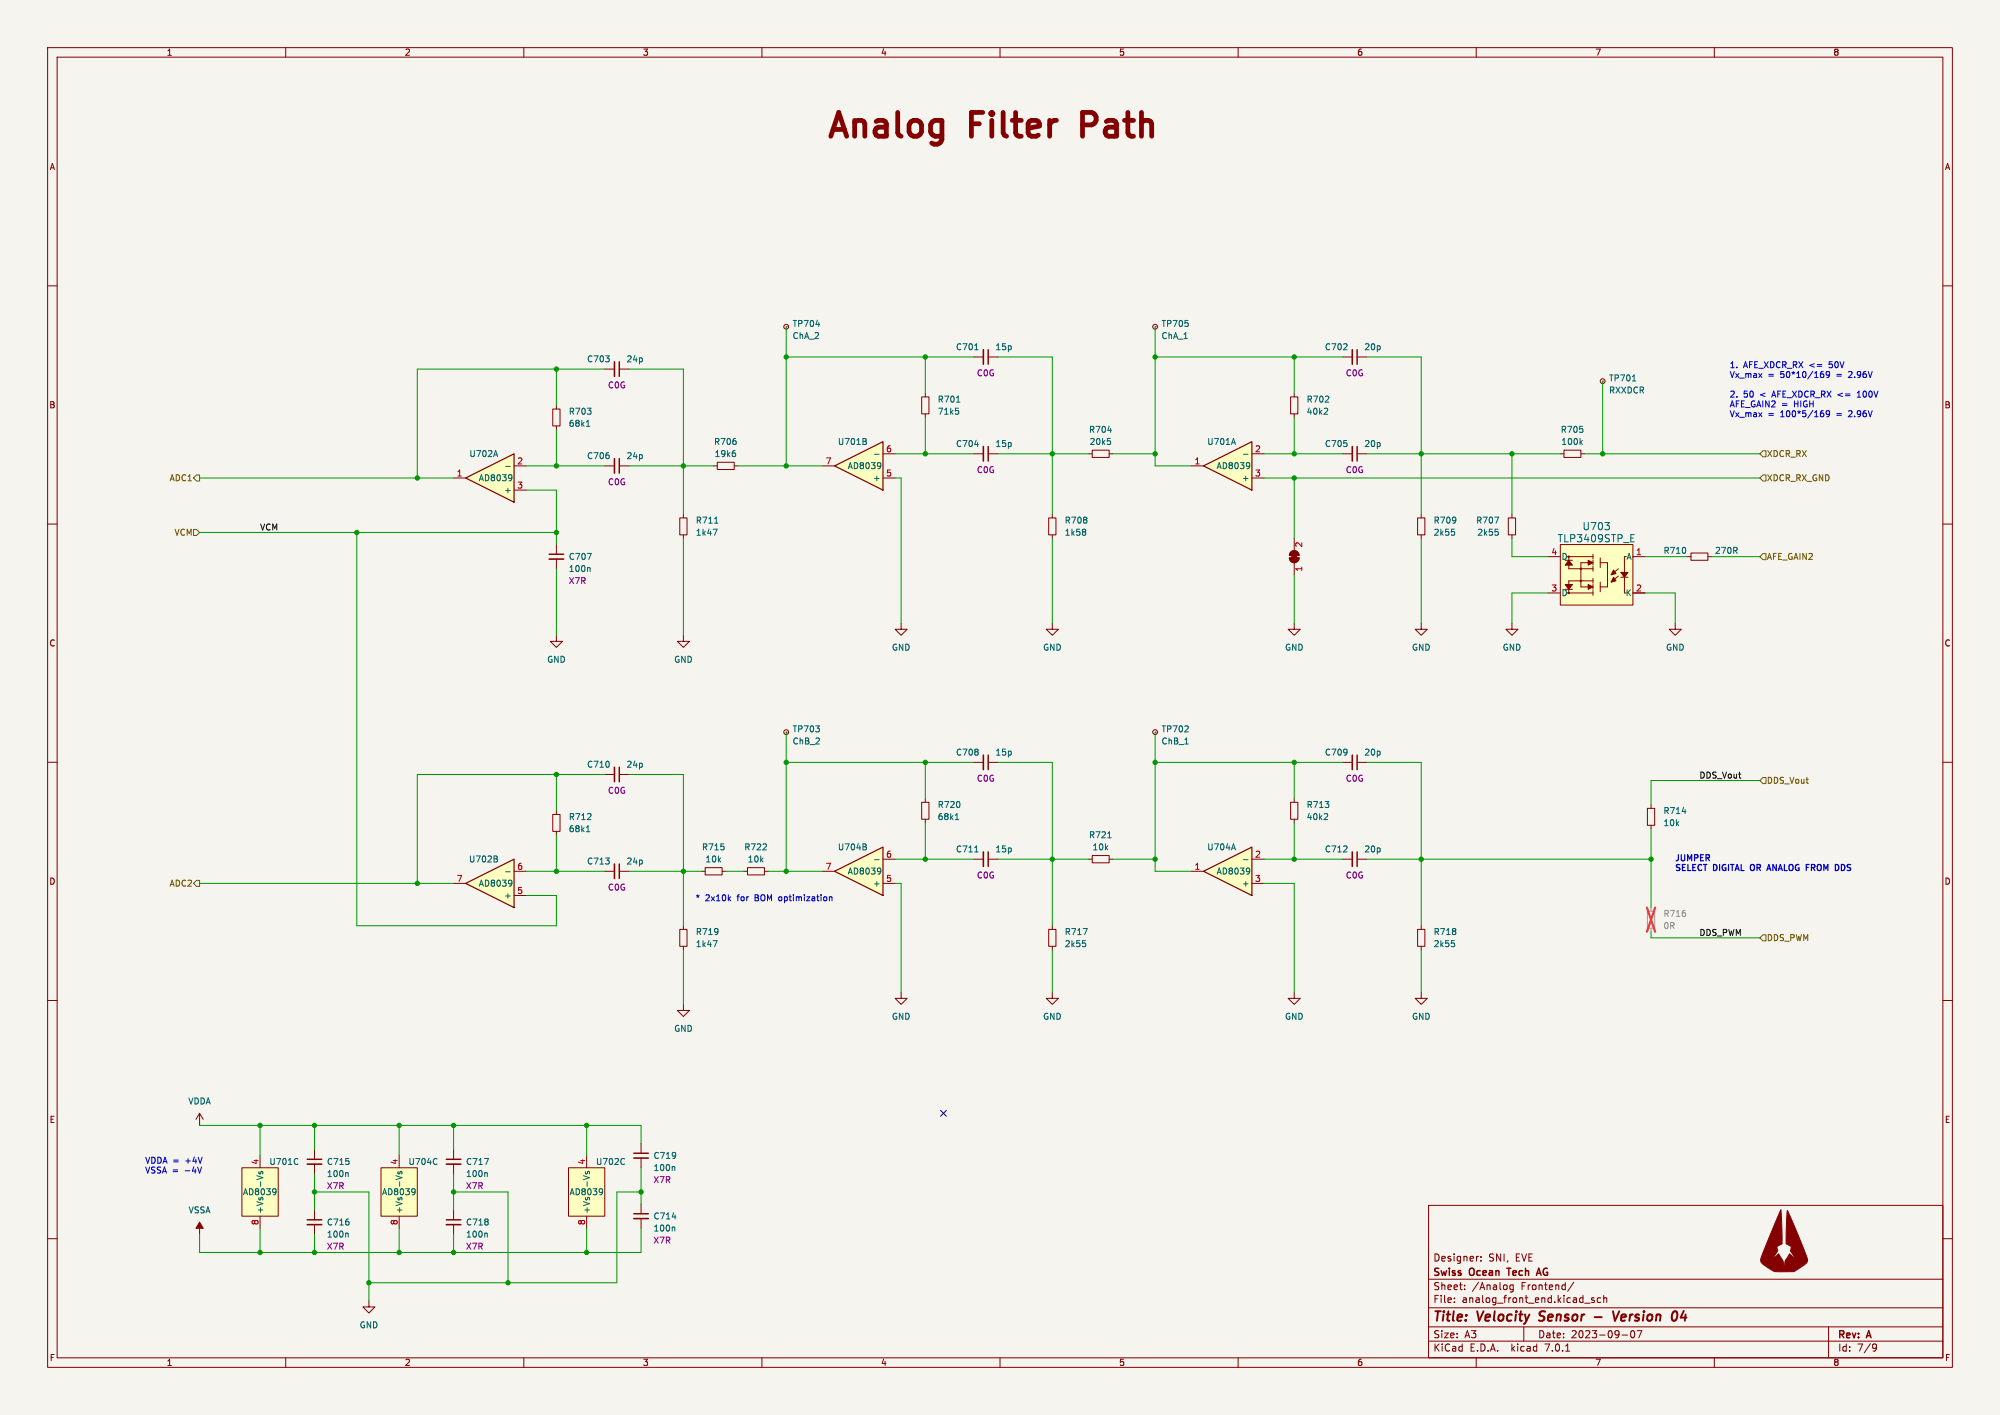
[picture p30: page 7]

JUMPER
SELECT DIGITAL OR ANALOG FROM DDS

Id: 7/9 Title: Velocity Sensor - Version 04

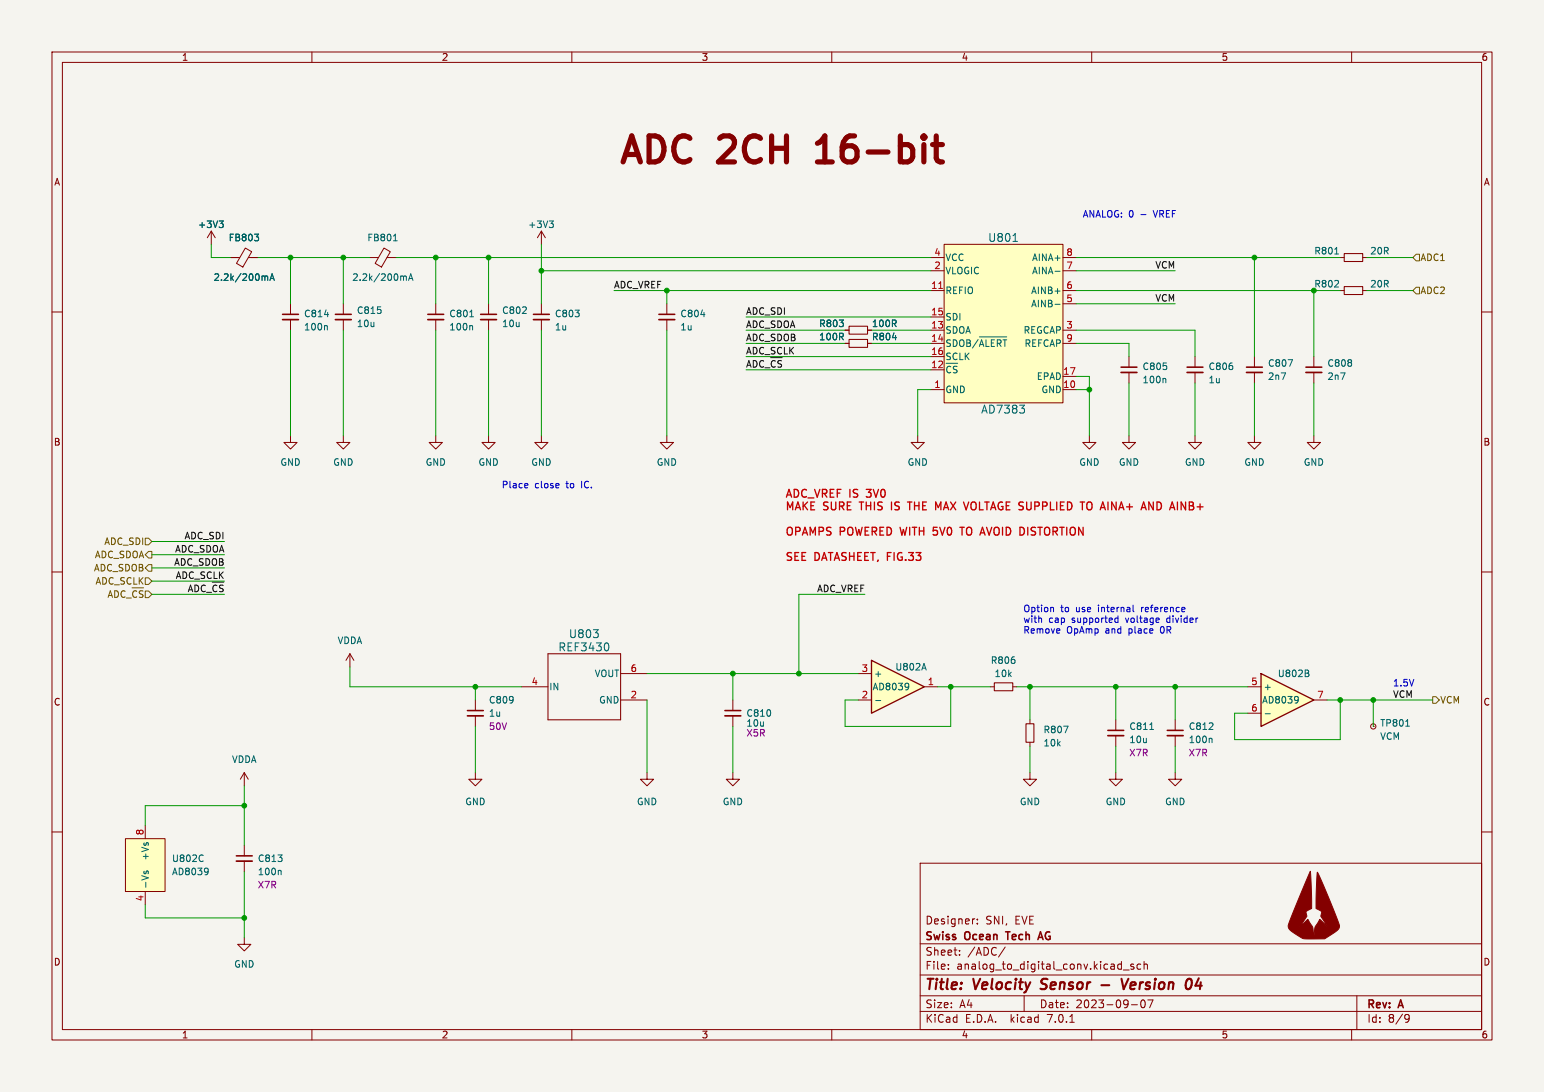
[picture p31: page 8]

Id: 8/9 Title: Velocity Sensor - Version 04

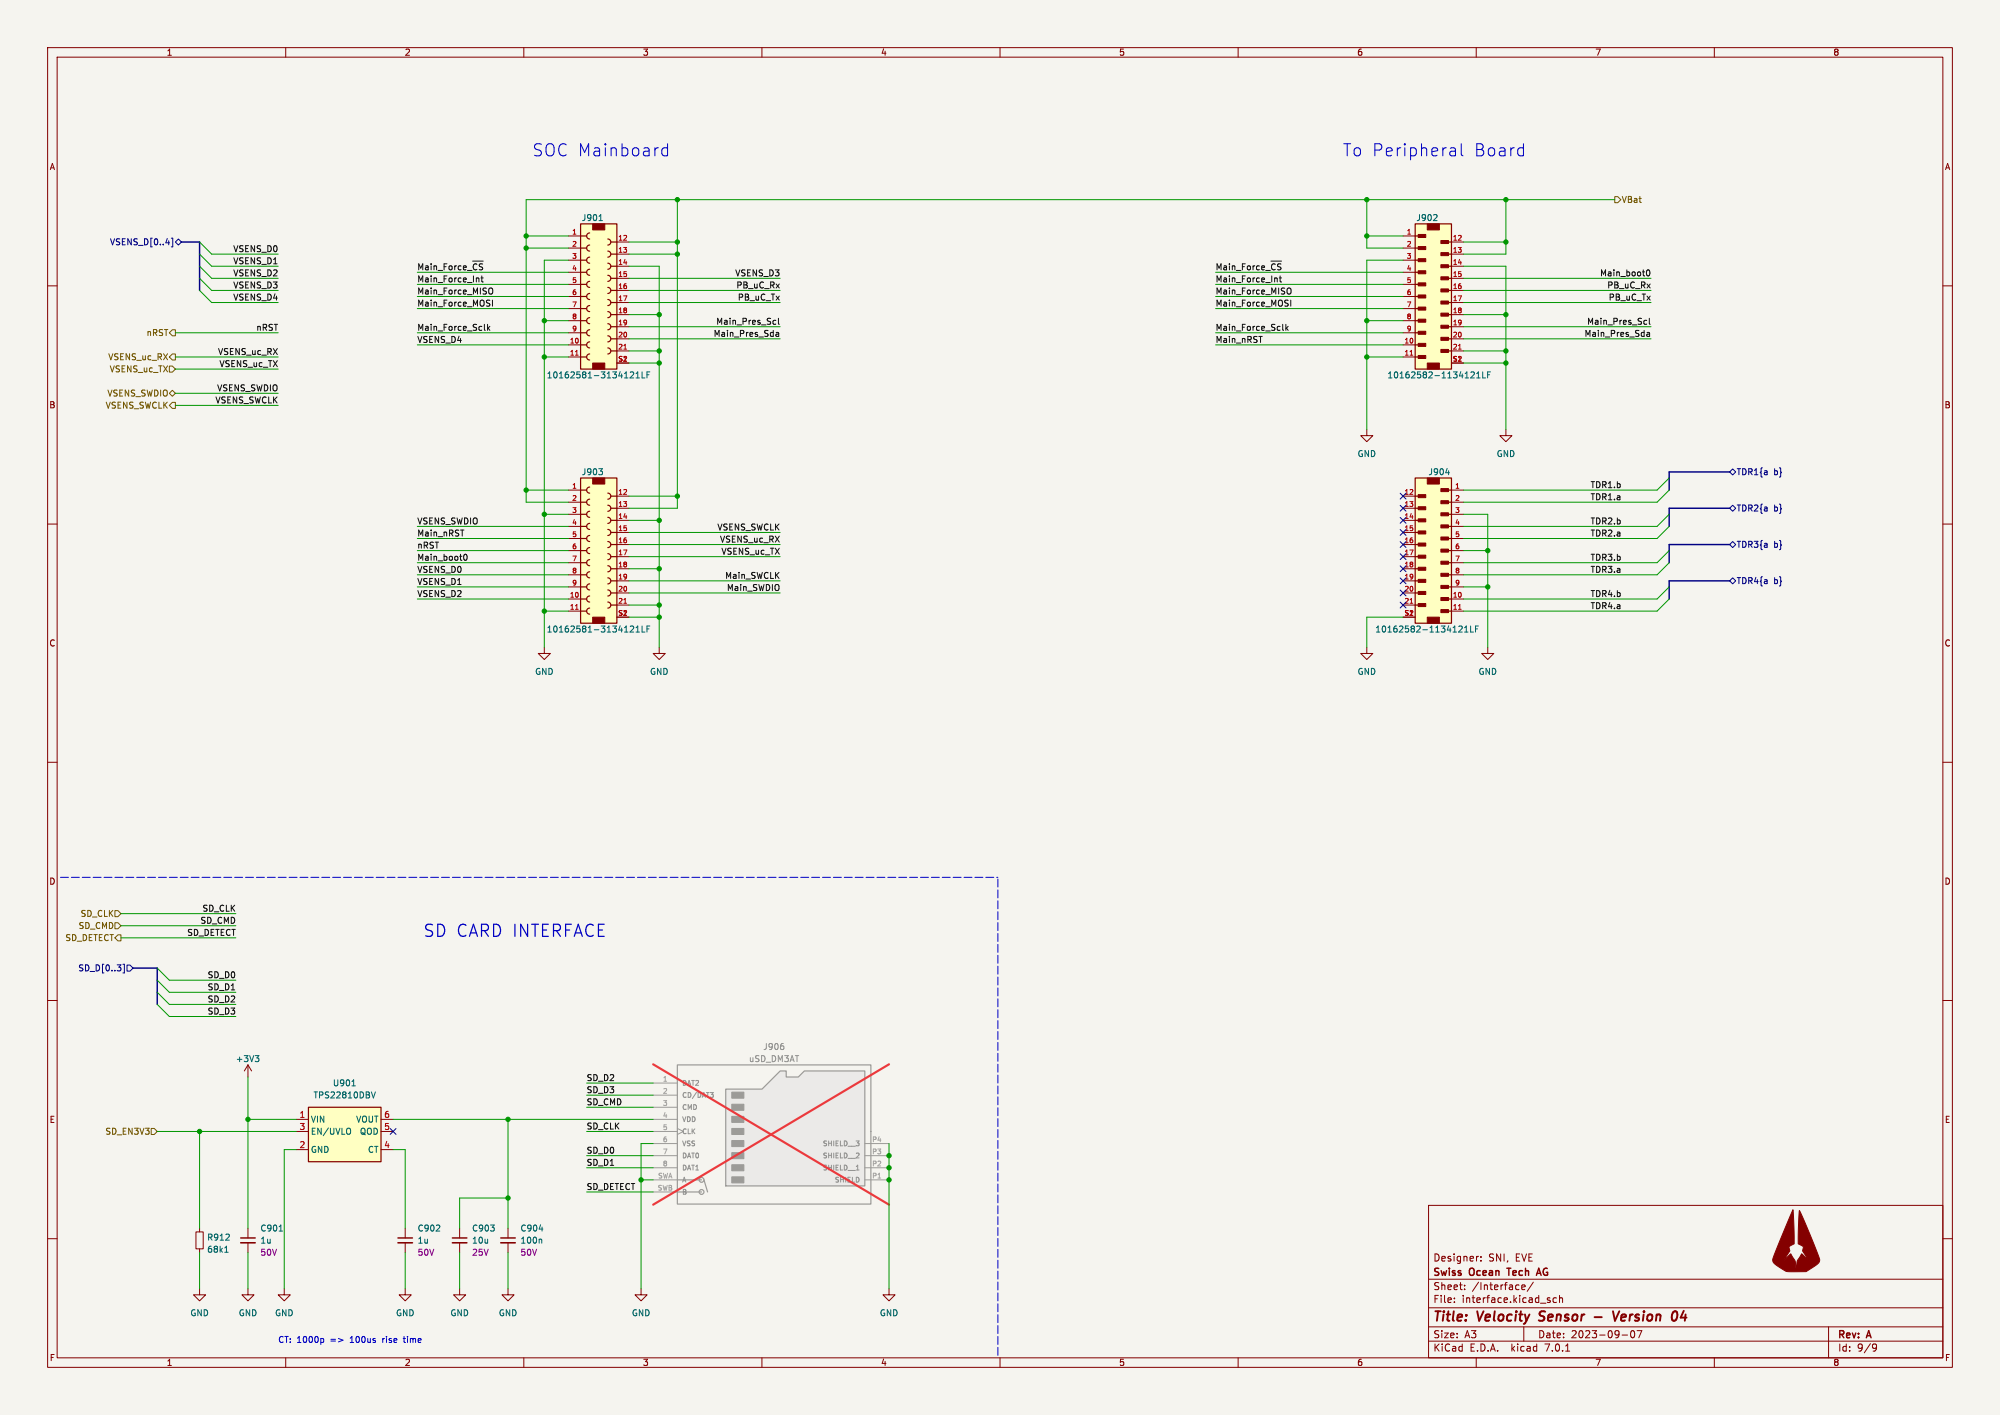
[picture p32: page 9]

Id: 9/9 Title: Velocity Sensor - Version 04
