edgarvela-soc/vsensor_v4_temp/docs/pp1_vsensor_v4_layers.pdf

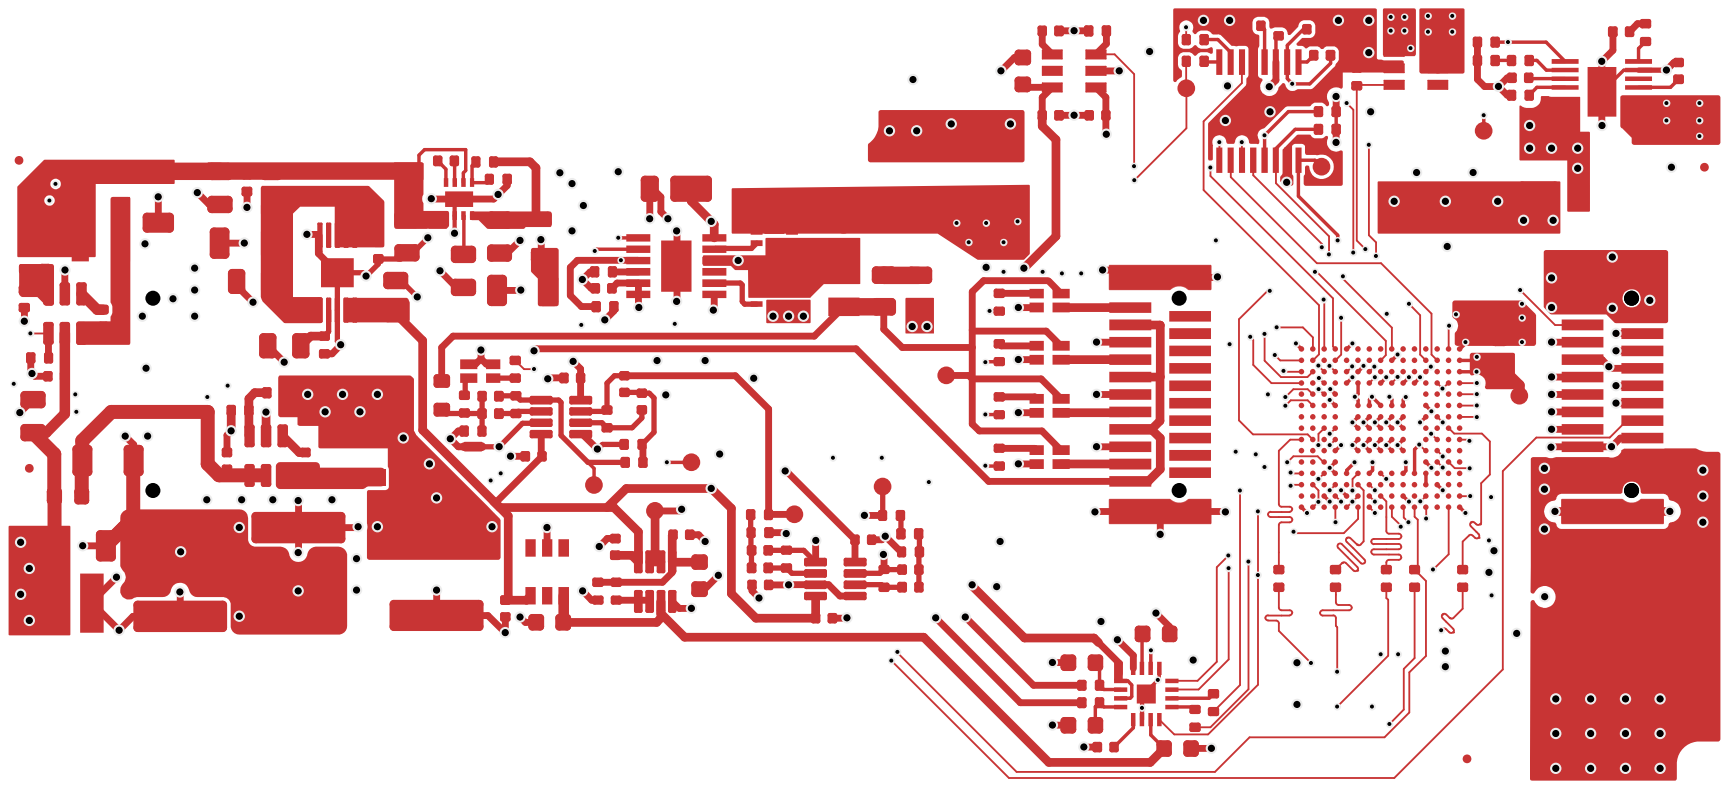
[picture p33: page 1]

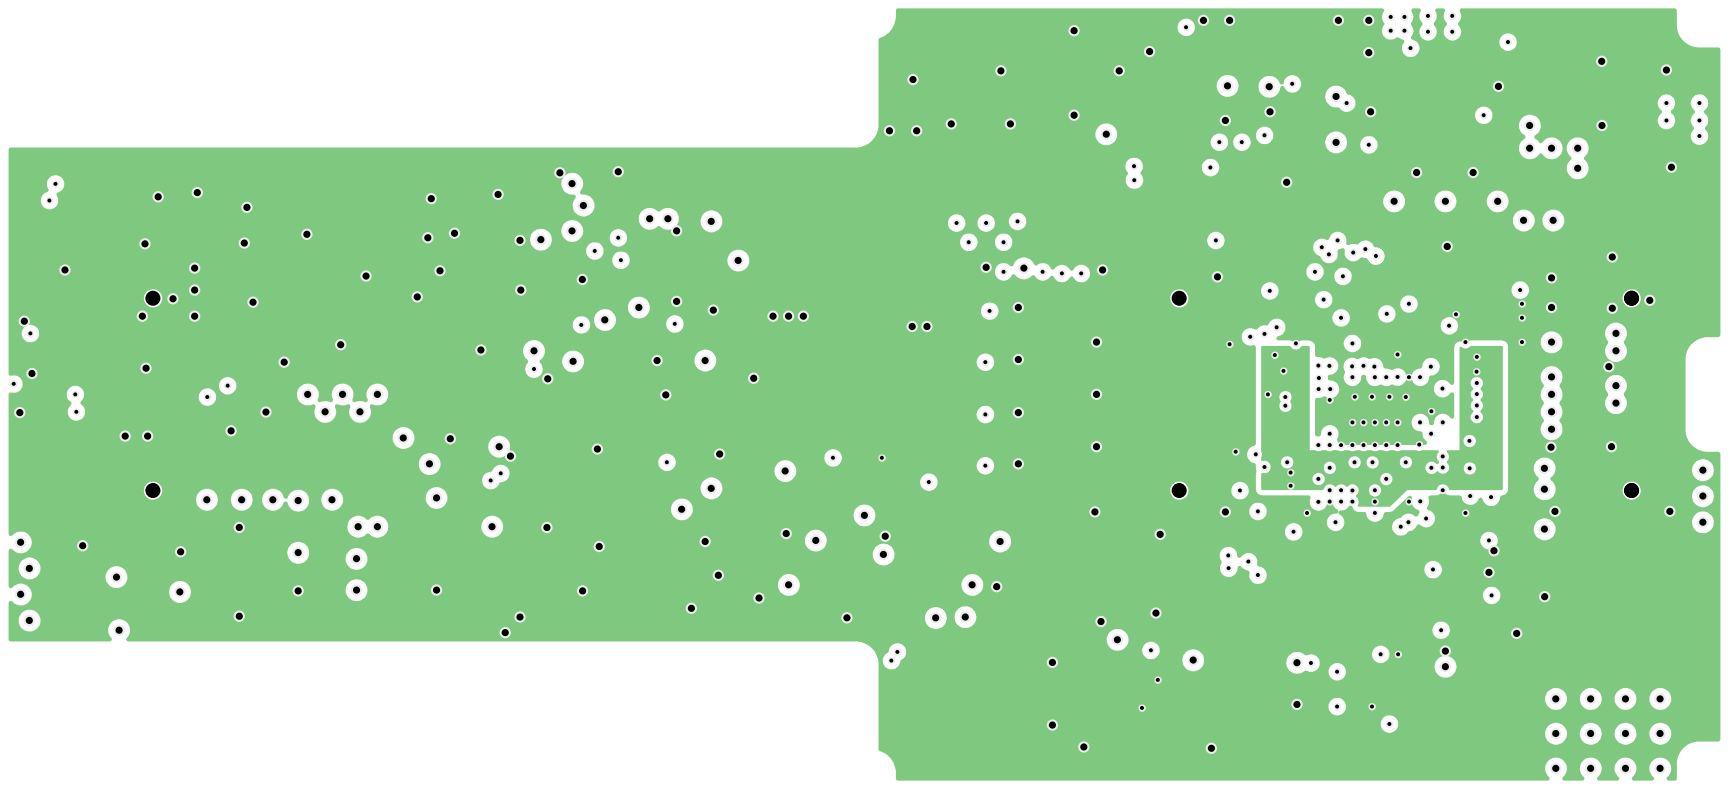
[picture p34: page 2]

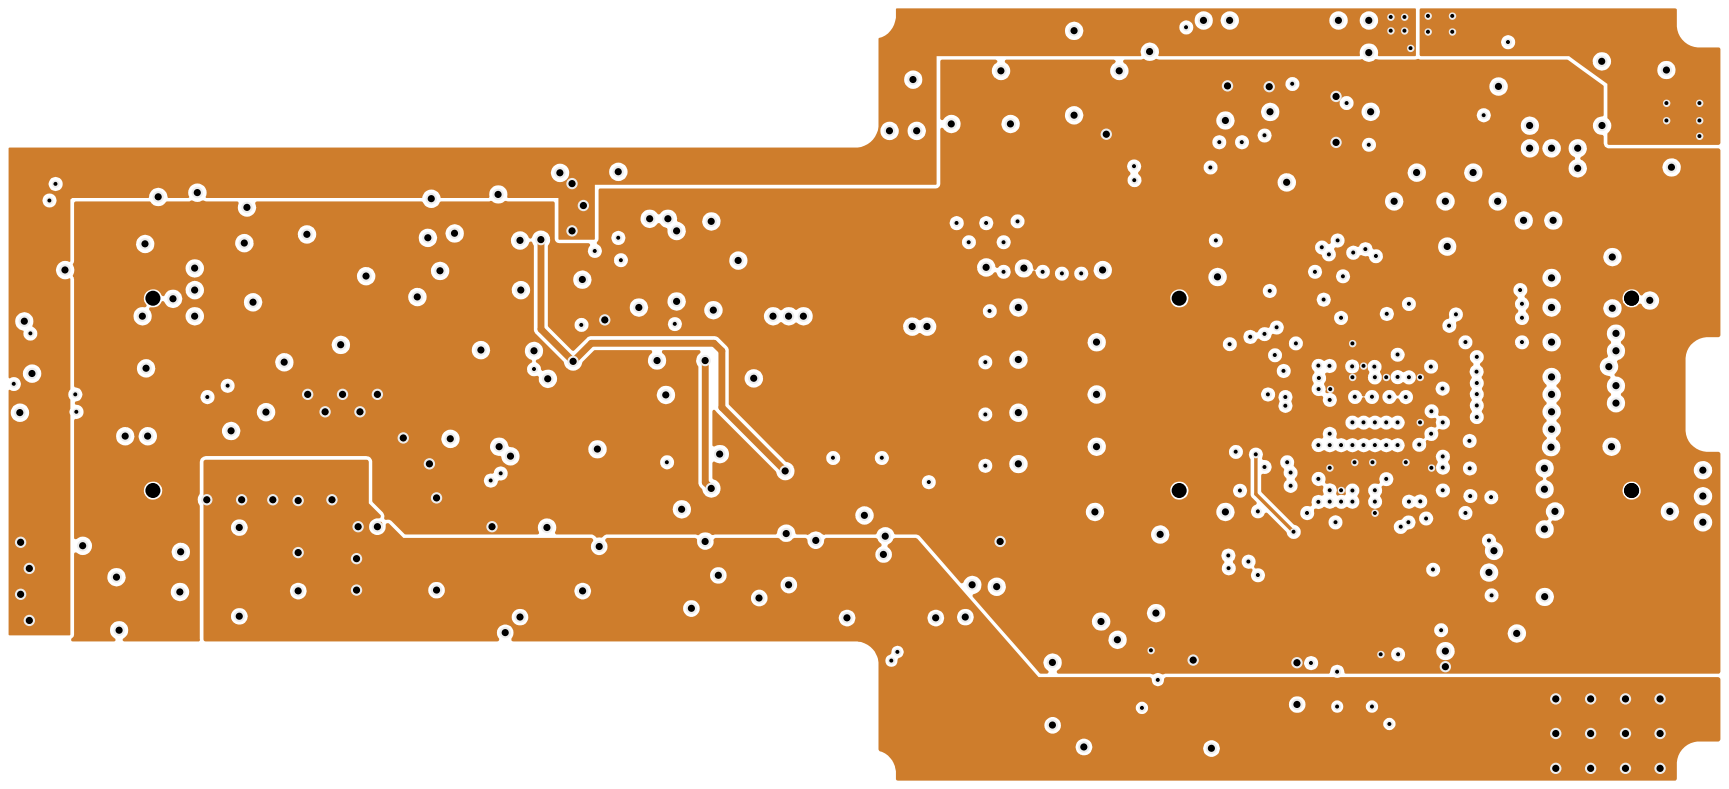
[picture p35: page 3]

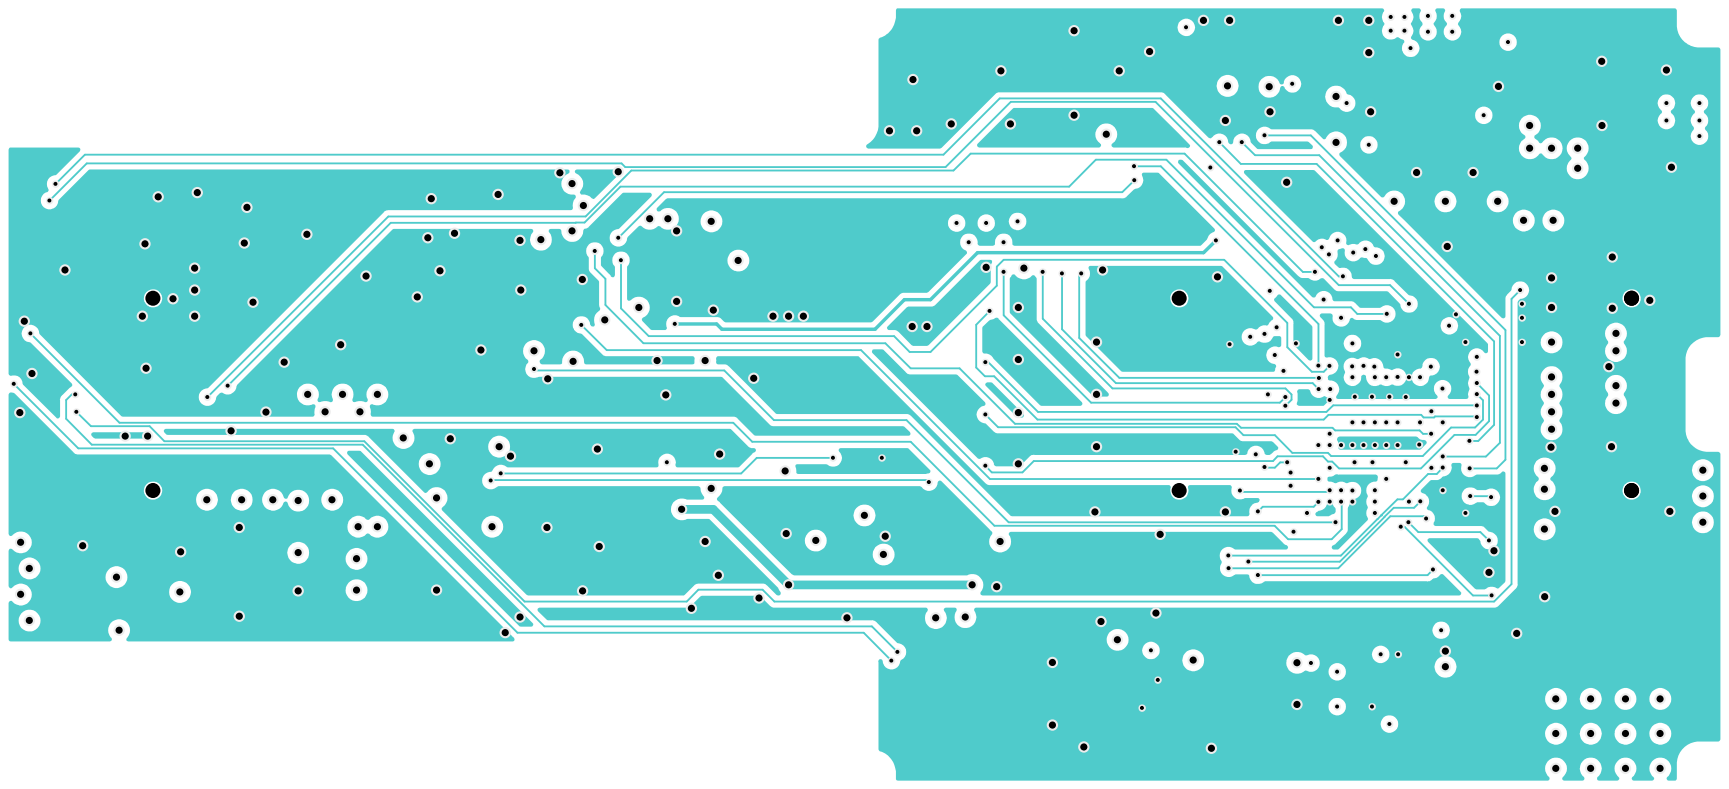
[picture p36: page 4]

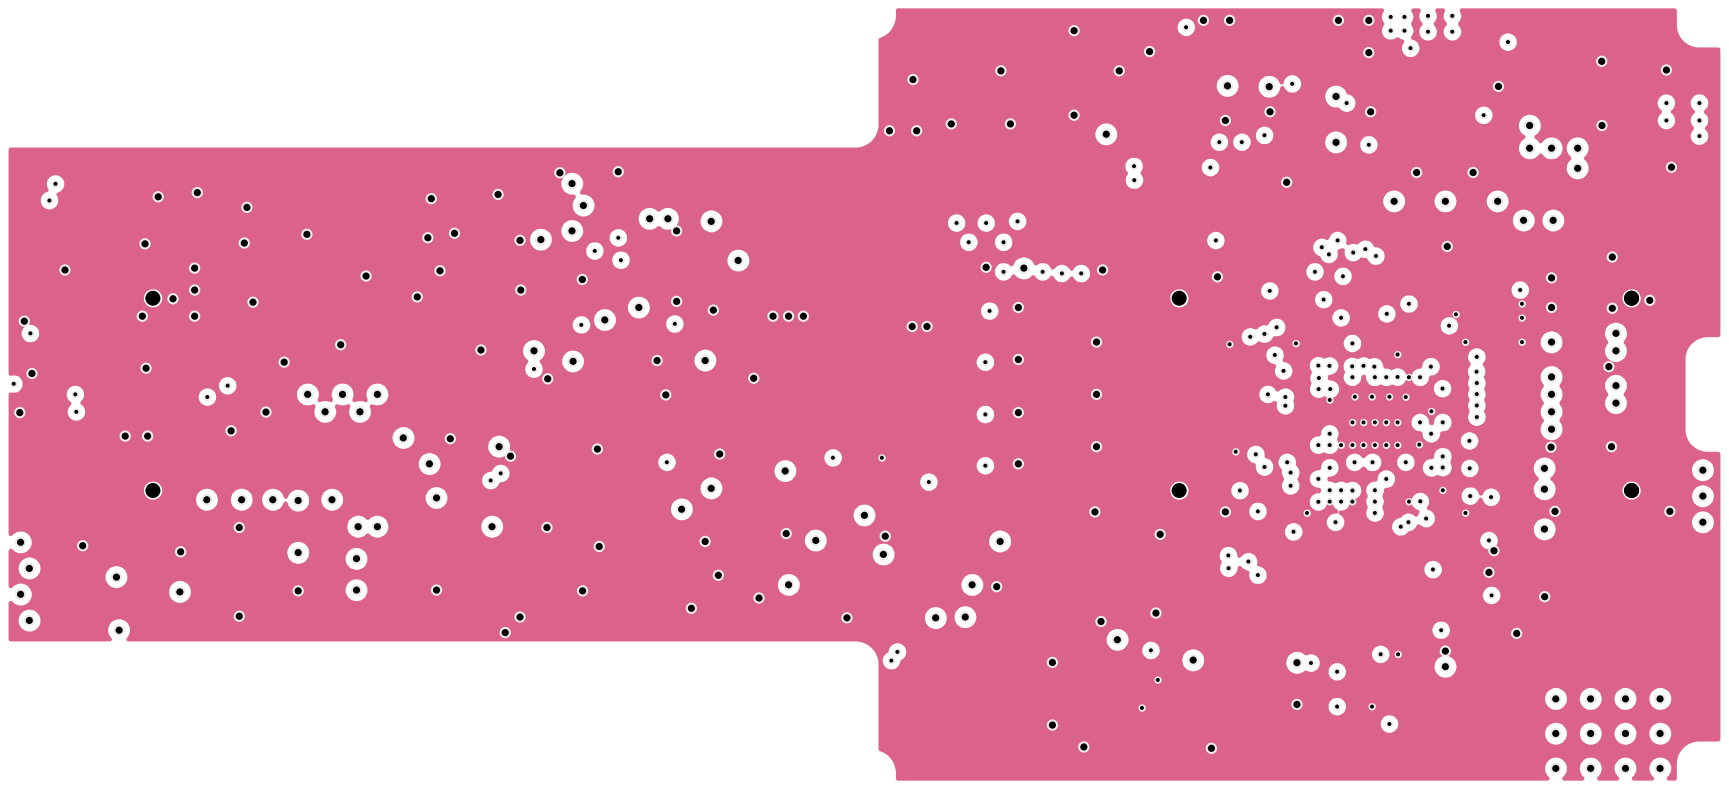
[picture p37: page 5]

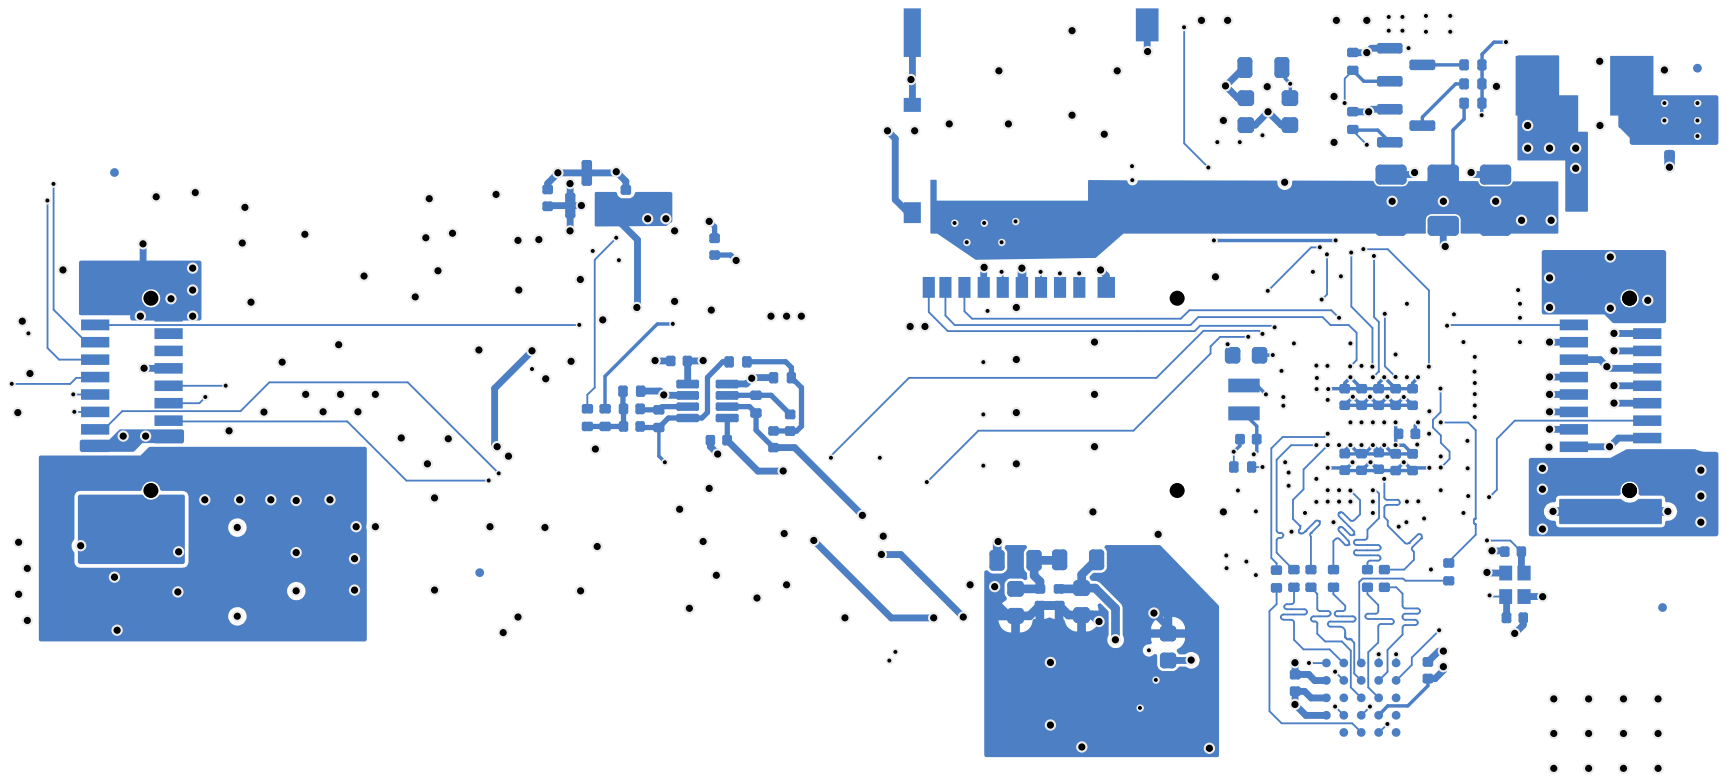
[picture p38: page 6]
