edgarvela-soc/vsensor_v4_temp/production/pp1_vsensor_v4-B_Fab.pdf

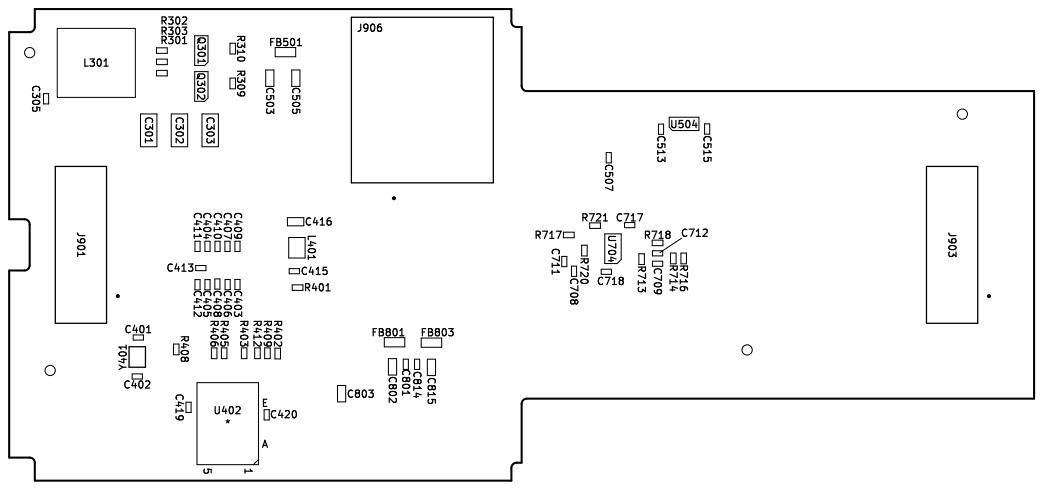
[picture p39: page 1]
