edgarvela-soc/vsensor_v4_temp/production/pp1_vsensor_v4-F_Fab.pdf

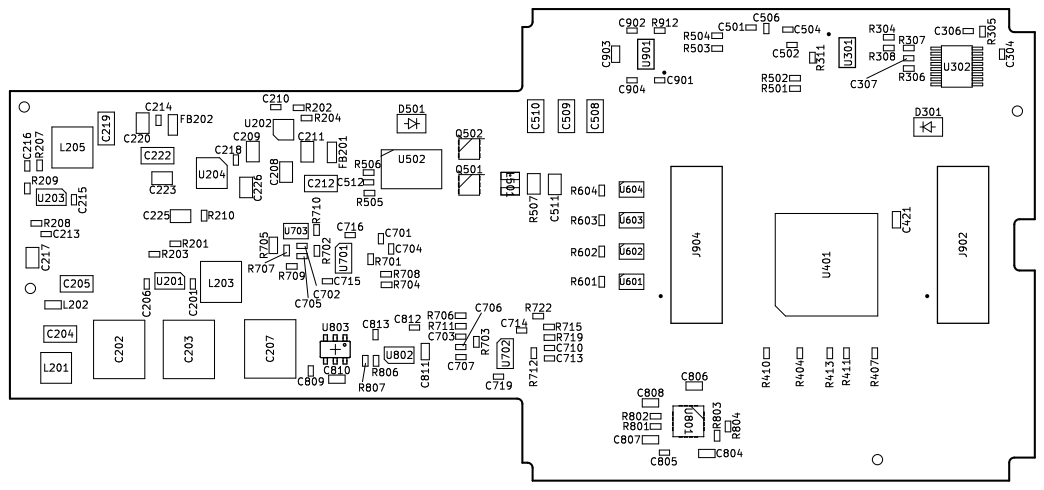
[picture p40: page 1]
