edgarvela-soc/vsensor_v4_temp/docs/filter/DesignFiles_AD8038_mod/ACAnalysis.asc

STAGE1: StageA_BandPassDeliyannisFriendNoPosFB_AD8038
STAGE2: StageB_BandPassDeliyannisFriendNoPosFB_AD8038
STAGE3: StageC_BandPassDeliyannisFriendNoPosFB_AD8038
V1: voltage; 0
V2: voltage; 4.5
V3: voltage; -4.5
VIN: voltage; SINE(0.376 0.29 700k); AC 1
Named nets: 0, Vp, Vn, OUT1, Vref, IN, OUT2, OUT
.AC DEC 1001 10 100Meg
If you're having trouble with simulation try the following:
 
- Ensure that LTspice circuit folder is unzipped.  LTspice won't 
be able to locate subcircuits if the folders are still zipped.
 
- Update LTspice - devices that have been recently added to LTspice
won't be available unless you update by clicking Tools -> Sync Release.
.tran 0 1m 900u 1n
