edgarvela-soc/vsensor_v4_temp/docs/filter/DesignFiles_AD8038_mod/StageA_BandPassDeliyannisFriendNoPosFB_AD8038.asc

C1: cap; 20p
C2: cap; 20p
R1: res; 10k
R2: res; 2.55k
R5: res; 40.2k
U1: AD8038
Named nets: V+, V-, OUT, IN, REF
This subcircuit is not simulatable.  
Please open one of the 
"Filter Design*.asc" schematics to 
simulate your Filter Wizard design.
