edgarvela-soc/vsensor_v4_temp/docs/filter/DesignFiles_AD8038_mod/StageC_BandPassDeliyannisFriendNoPosFB_AD8038.asc

C1: cap; 24p
C2: cap; 24p
R1: res; 20k
R2: res; 1.47k
R5: res; 68.1k
U1: AD8038
V1: voltage; 1.5
Named nets: V+, V-, OUT, IN, REF, 0
This subcircuit is not simulatable.  
Please open one of the 
"Filter Design*.asc" schematics to 
simulate your Filter Wizard design.
