edgarvela-soc/vsensor_v4_temp/docs/filter/DesignFiles_AD8038_mod/TransientAnalysis.asc

STAGE1: StageA_BandPassDeliyannisFriendNoPosFB_AD8038
STAGE2: StageB_BandPassDeliyannisFriendNoPosFB_AD8038
STAGE3: StageC_BandPassDeliyannisFriendNoPosFB_AD8038
V1: voltage; 0
V2: voltage; 3.3
V3: voltage; -2.5
VIN: voltage; PULSE(0 1.07 0 1n 1n 1 2); AC 1
Named nets: 0, Vp, Vn, OUT1, Vref, IN, OUT2, OUT
.TRAN 34.9u 
.save V(*?*) I(*?*)
If you're having trouble with simulation try the following:
 
- Ensure that LTspice circuit folder is unzipped.  LTspice won't 
be able to locate subcircuits if the folders are still zipped.
 
- Update LTspice - devices that have been recently added to LTspice
won't be available unless you update by clicking Tools -> Sync Release.
