edgarvela-soc/vsensor_v4_temp/docs/filter/DesignFiles_AD8038_simple/ACAnalysis.asc

C1: cap; 220n
D1: schottky; MBRS1100
R1: res; 51k
R2: res; 25
STAGE1: StageA_BandPassDeliyannisFriendNoPosFB_AD8038
STAGE2: StageB_BandPassDeliyannisFriendNoPosFB_AD8038
STAGE3: StageC_BandPassDeliyannisFriendNoPosFB_AD8038
U1: NMOS_SSM6K361NU
U2: NMOS_SSM6K361NU
U3: LTC7060
V1: voltage; 0
V2: voltage; 4
V3: voltage; -4
V4: voltage; PULSE(0 3.3 0 1n 1n 714n 1429n 1000)
V5: voltage; 10
V6: voltage; 40
VIN: voltage; SINE(0 2.5 304k); AC 1
Named nets: 0, Vp, Vn, OUT1, Vref, IN, OUT2, OUT
.AC DEC 1001 10 20Meg
If you're having trouble with simulation try the following:
 
- Ensure that LTspice circuit folder is unzipped.  LTspice won't 
be able to locate subcircuits if the folders are still zipped.
 
- Update LTspice - devices that have been recently added to LTspice
won't be available unless you update by clicking Tools -> Sync Release.
.lib NMOS_SSM6K361NU.lib
