edgarvela-soc/vsensor_v4_temp/docs/filter/DesignFiles_AD8038_simple/OutputGen.asc

C1: cap; 47n; Rser=76.6m Lser=0 mfg="   ---" pn="   ---" type="   ---"
E1: e; 1
L1: ind; 1µ; Ipk=1.8 Rser=80m Rpar=1.62K Cpar=886f mfg="Bourns, Inc." pn="SRN2010TA-1R0Y"
R2: res; 50
R3: res; 1k
R4: res; 1
U1: LT1720
V1: voltage; SINE(2.5 2.4 750k 0 0 0 50)
V2: voltage; 2.4
V3: voltage; 5
V4: voltage; 0; AC 1 0
Named nets: 0
.AC DEC 1001 300k 3Meg
.lib NMOS_SSM6K361NU.lib
.tran 0 2m 0 1n
.inc opamp.sub
