edgarvela-soc/vsensor_v4_temp/docs/filter/DesignFiles_AD8038_simple/pwm_filter.asc

C1: cap; 33n
C3: cap; 2.16n
L1: ind; 1µ
R1: res; 3
R3: res; 159
V1: voltage; 1; AC 1 0
Named nets: 0
.ac dec 1001 500k 3Meg
