edgarvela-soc/vsensor_v4_temp/docs/filter/DesignFiles_AD8038_simple/StageA_BandPassDeliyannisFriendNoPosFB_AD8038.asc

C1: cap; 20p
C2: cap; 20p
R1: res; 20k
R2: res; 2.7k
R5: res; 39k
U1: AD8038
Named nets: V+, V-, OUT, IN, REF
This subcircuit is not simulatable.  
Please open one of the 
"Filter Design*.asc" schematics to 
simulate your Filter Wizard design.
