edgarvela-soc/vsensor_v4_temp/docs/filter/DesignFiles_AD8038_simple/StageB_BandPassDeliyannisFriendNoPosFB_AD8038.asc

C1: cap; 16p
C2: cap; 16p
R1: res; 20k
R2: res; 1.5k
R5: res; 68k
U1: AD8038
Named nets: V+, V-, OUT, IN, REF
This subcircuit is not simulatable.  
Please open one of the 
"Filter Design*.asc" schematics to 
simulate your Filter Wizard design.
