edgarvela-soc/vsensor_v4_temp/docs/filter/DesignFiles_AD8038_simple/TransientAnalysis.asc

C1: cap; 1n
R1: res; 100
STAGE1: StageA_BandPassDeliyannisFriendNoPosFB_AD8038
STAGE2: StageB_BandPassDeliyannisFriendNoPosFB_AD8038
STAGE3: StageC_BandPassDeliyannisFriendNoPosFB_AD8038
V1: voltage; 0
V2: voltage; 4
V3: voltage; -4
V4: voltage; 1.5
V5: voltage; -4
VIN: voltage; PULSE(0 2.5 0 1n 1n 714n 1429n 100); AC 1
Named nets: 0, Vp, Vn, OUT1, Vref, IN, OUT2, OUT, ADC_IN
.TRAN 34.9u
If you're having trouble with simulation try the following:
 
- Ensure that LTspice circuit folder is unzipped.  LTspice won't 
be able to locate subcircuits if the folders are still zipped.
 
- Update LTspice - devices that have been recently added to LTspice
won't be available unless you update by clicking Tools -> Sync Release.
.ac dec 1001 500k 2Meg
