edgarvela-soc/vsensor_v4_temp/pp1_vsensor_v4.kicad_pcb

## KiCad design pp1_vsensor_v4.kicad_pcb (2024-06-10)

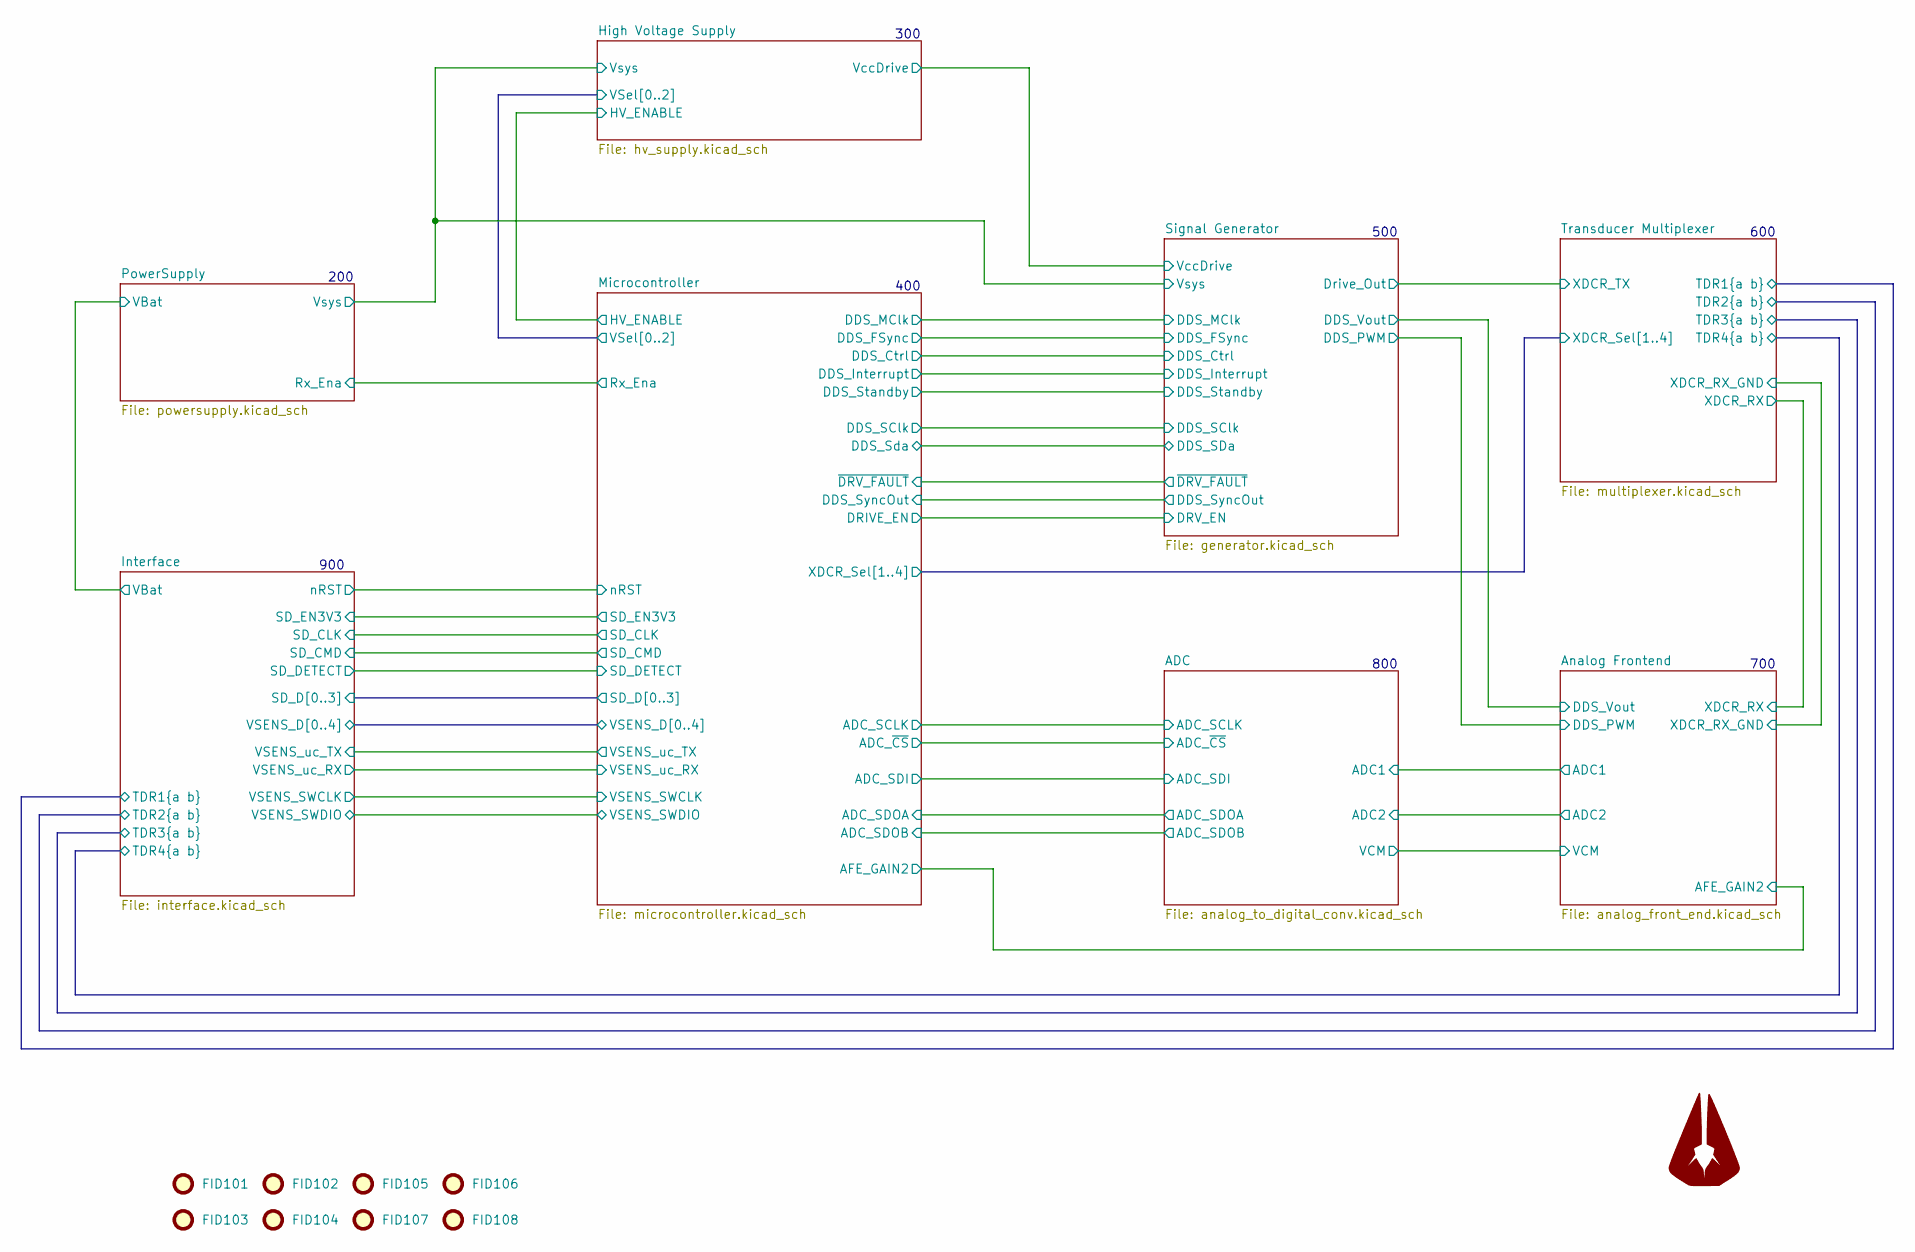
[picture p41: schematic pp1_vsensor_v4.kicad_sch, Velocity Sensor - Version 04]

Parts:
FID101, FID102, FID103, FID104, FID105, FID106, FID107, FID108: Fiducial; Fiducial_0.5mm_Mask1mm
Logo101: LOGO_AGU; AGU_15mm

Notes on the sheet:
700
400
800
500
300
600
900
200

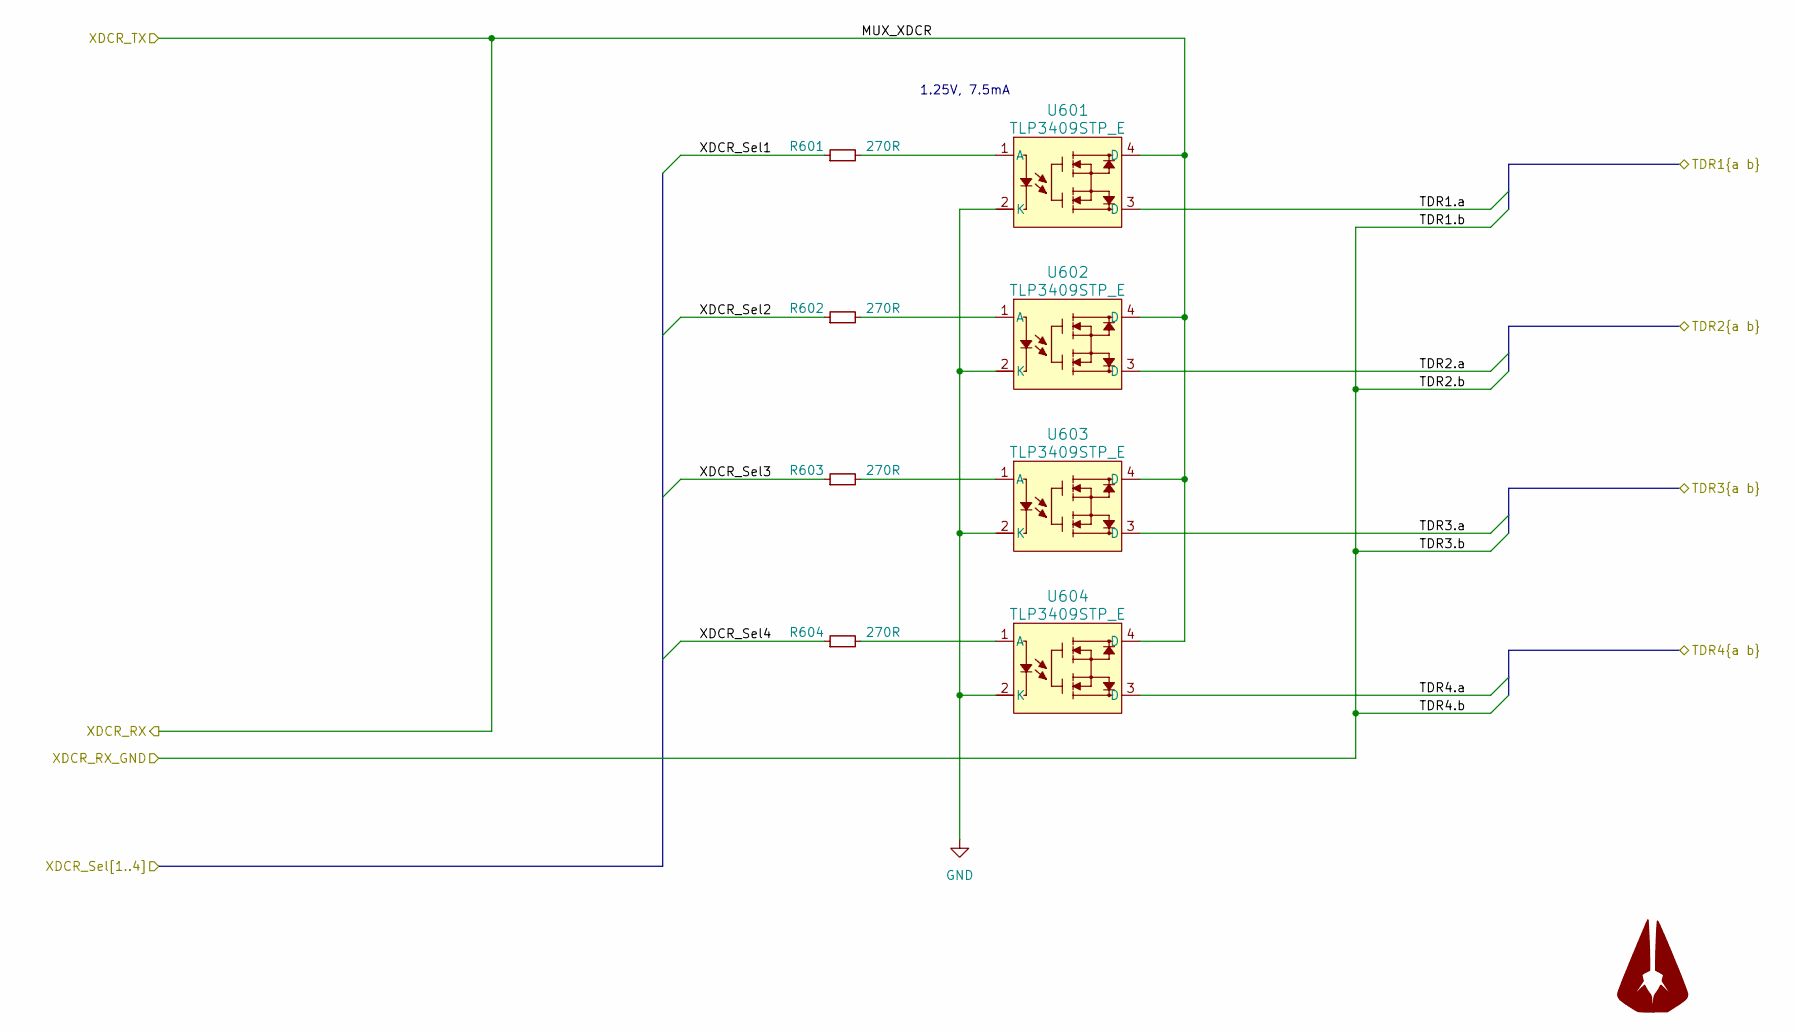
[picture p42: schematic multiplexer.kicad_sch, Velocity Sensor - Version 04]

Parts:
Logo601: LOGO_AGU; AGU_15mm
R601, R602, R603, R604: 270R; R_0402_1005Metric; MPN RMCF0402FT270R; Digikey_PN RMCF0402FT270RCT-ND
U601, U602, U603, U604: TLP3409STP_E; MPN TLP3409S(TP,E; Mouser_PN 757-TLP3409STPE

Connections:
/Interface/TDR1.a: U601.3 (D); also elsewhere on the board
/Interface/TDR2.a: U602.3 (D); also elsewhere on the board
/Interface/TDR3.a: U603.3 (D); also elsewhere on the board
/Interface/TDR4.a: U604.3 (D); also elsewhere on the board
/Microcontroller/XDCR_Sel1: R601.1; also elsewhere on the board
/Microcontroller/XDCR_Sel2: R602.1; also elsewhere on the board
/Microcontroller/XDCR_Sel3: R603.1; also elsewhere on the board
/Microcontroller/XDCR_Sel4: R604.1; also elsewhere on the board
/Transducer Multiplexer/MUX_XDCR: U601.4 (D), U602.4 (D), U603.4 (D), U604.4 (D); also elsewhere on the board
unnamed: R601.2, U601.1 (A)
unnamed: R602.2, U602.1 (A)
unnamed: R603.2, U603.1 (A)
unnamed: R604.2, U604.1 (A)

Notes on the sheet:
1.25V, 7.5mA

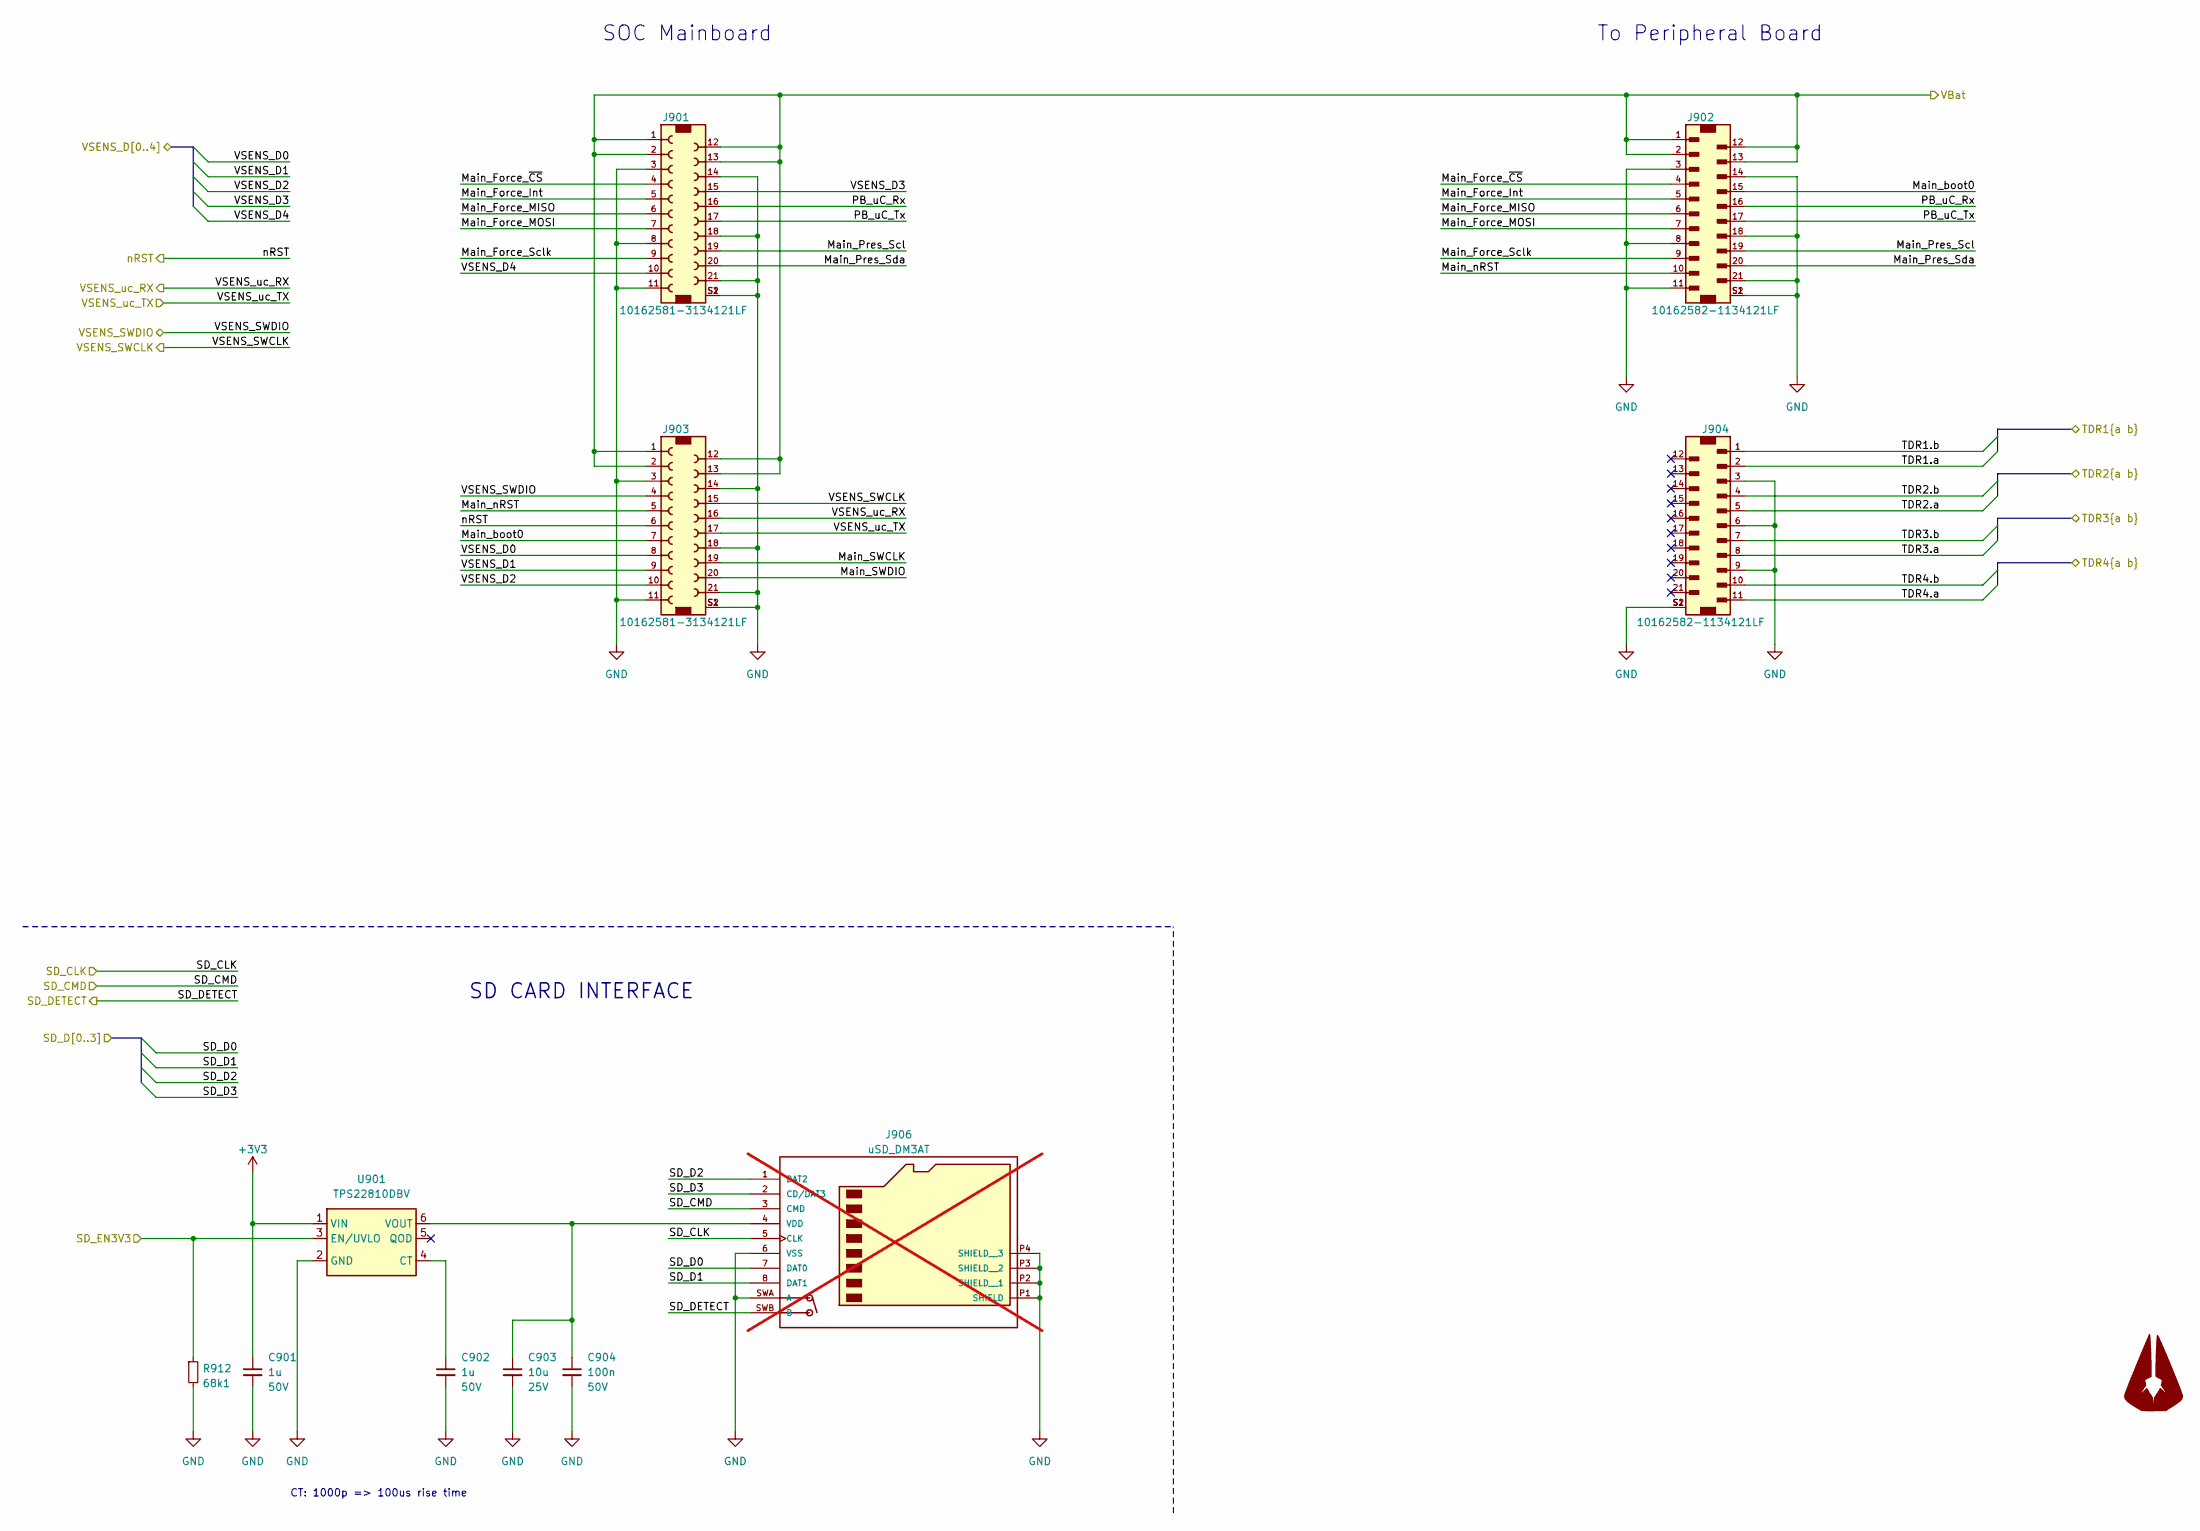
[picture p43: schematic interface.kicad_sch, Velocity Sensor - Version 04]

Parts:
C901, C902: 1u; C_0402_1005Metric; Voltage 50V; MPN UMK105CBJ105MV-F; Digikey_PN 587-6278-1-ND
C903: 10u; C_0603_1608Metric; Voltage 25V; MPN GRM188R61E106MA73D; Mouser_PN 81-GRM188R61E106MA3D
C904: 100n; C_0402_1005Metric; Voltage 50V; MPN CC0402KRX7R9BB104; Digikey_PN 311-3566-1-ND
J901, J903: 10162581-3134121LF; AMPHENOL_10162581-3134121LF; MPN 10162581-3134121LF; Digikey_PN 609-10162581-3134121LFCT-ND
J902, J904: 10162582-1134121LF; AMPHENOL_10162582-1134121LF; MPN 10162582-1134121LF; Digikey_PN 609-10162582-1134121LFCT-ND
J906: uSD_DM3AT; HRS_DM3AT-SF-PEJM5; PARTREV 20200913; Digikey_PN HR1964CT-ND; not fitted
Logo901: LOGO_AGU; AGU_15mm
R912: 68k1; R_0402_1005Metric; MPN RC0402FR-0768K1L; Digikey_PN YAG3213CT-ND
U901: TPS22810DBV; SOT95P280X145-6N; MPN TPS22810TDBVRQ1; Digikey_PN 296-50496-1-ND

Connections:
+3V3: C901.1, U901.1 (VIN); also elsewhere on the board
/Interface/Main_Force_Int: J901.5, J902.5
/Interface/Main_Force_MISO: J901.6, J902.6
/Interface/Main_Force_MOSI: J901.7, J902.7
/Interface/Main_Force_Sclk: J901.9, J902.9
/Interface/Main_Force_~CS: J901.4, J902.4
/Interface/Main_Pres_Scl: J901.19, J902.19
/Interface/Main_Pres_Sda: J901.20, J902.20
/Interface/Main_SWCLK: J903.19
/Interface/Main_SWDIO: J903.20
/Interface/Main_boot0: J902.15, J903.7
/Interface/Main_nRST: J902.10, J903.5
/Interface/PB_uC_Rx: J901.16, J902.16
/Interface/PB_uC_Tx: J901.17, J902.17
/Interface/SD_CLK: J906.5 (CLK); also elsewhere on the board
/Interface/SD_CMD: J906.3 (CMD); also elsewhere on the board
/Interface/SD_D0: J906.7 (DAT0); also elsewhere on the board
/Interface/SD_D1: J906.8 (DAT1); also elsewhere on the board
/Interface/SD_D2: J906.1 (DAT2); also elsewhere on the board
/Interface/SD_D3: J906.2 (CD/DAT3); also elsewhere on the board
/Interface/SD_DETECT: J906.SWB (B); also elsewhere on the board
/Interface/TDR1.a: J904.2; also elsewhere on the board
/Interface/TDR2.a: J904.5; also elsewhere on the board
/Interface/TDR3.a: J904.8; also elsewhere on the board
/Interface/TDR4.a: J904.11; also elsewhere on the board
/Interface/VBat: J901.1, J901.2, J901.12, J901.13, J902.1, J902.2, J902.12, J902.13, J903.1, J903.2, J903.12, J903.13; also elsewhere on the board
/Interface/VSENS_D0: J903.8; also elsewhere on the board
/Interface/VSENS_D1: J903.9; also elsewhere on the board
/Interface/VSENS_D2: J903.10; also elsewhere on the board
/Interface/VSENS_D3: J901.15; also elsewhere on the board
/Interface/VSENS_D4: J901.10; also elsewhere on the board
/Interface/VSENS_SWCLK: J903.15; also elsewhere on the board
/Interface/VSENS_SWDIO: J903.4; also elsewhere on the board
/Interface/VSENS_uc_RX: J903.16; also elsewhere on the board
/Interface/VSENS_uc_TX: J903.17; also elsewhere on the board
/Interface/nRST: J903.6; also elsewhere on the board
/Microcontroller/SD_EN3V3: R912.1, U901.3 (EN/UVLO); also elsewhere on the board
unnamed: C903.1, C904.1, J906.4 (VDD), U901.6 (VOUT)
unnamed: C902.1, U901.4 (CT)

Notes on the sheet:
To Peripheral Board
SOC Mainboard
CT: 1000p => 100us rise time
SD CARD INTERFACE

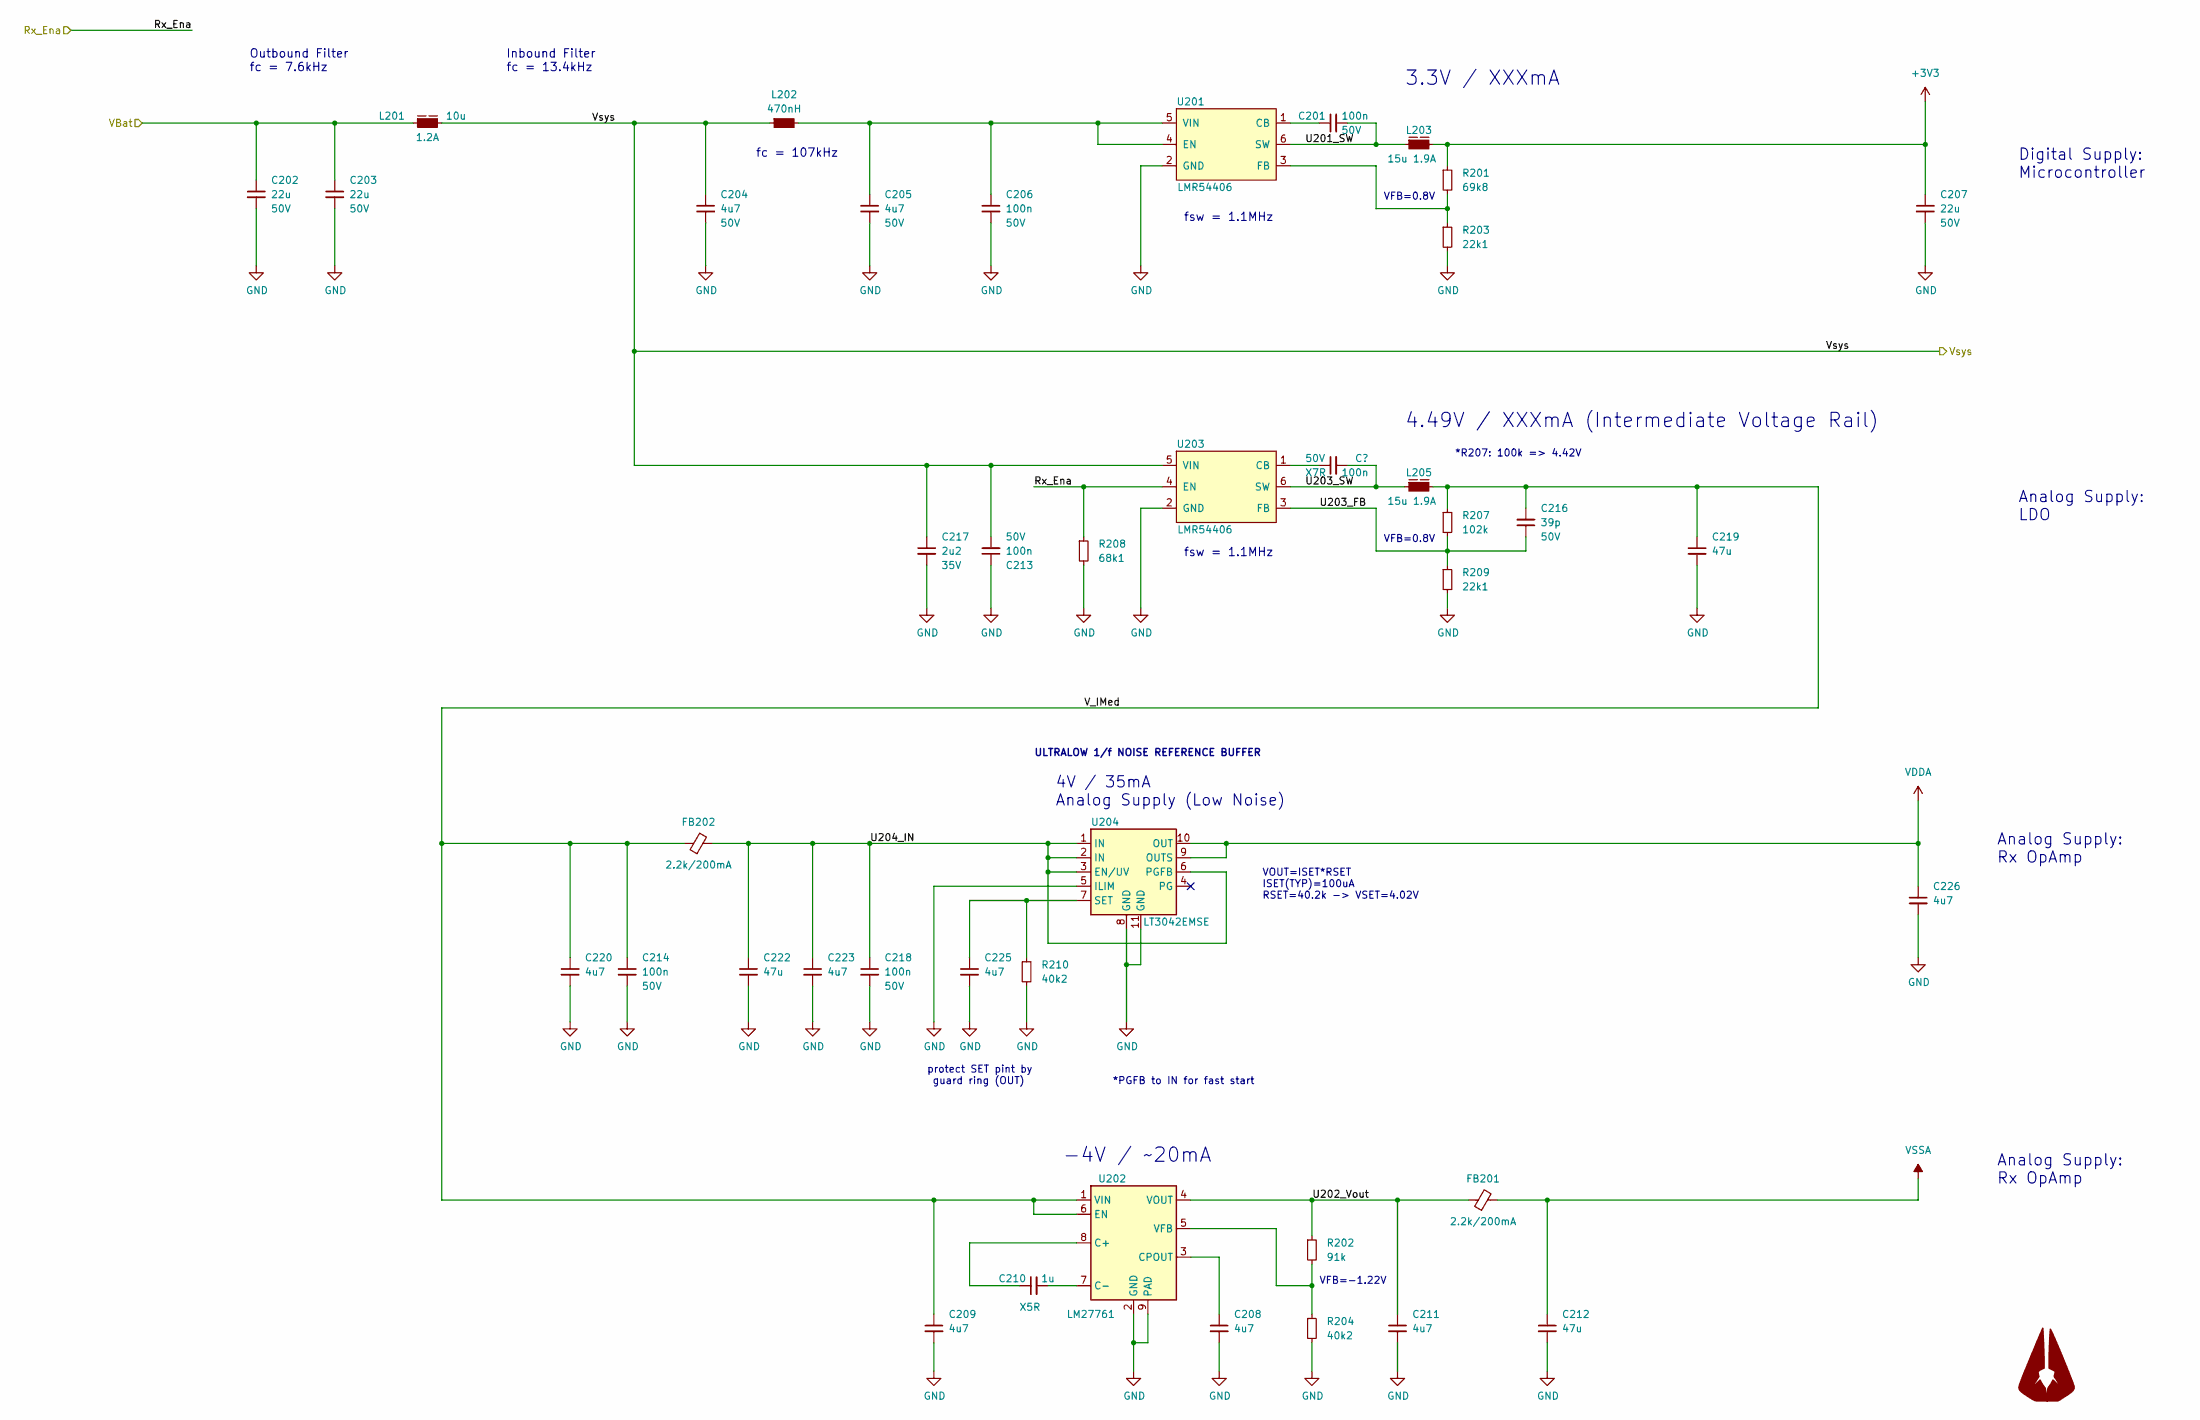
[picture p44: schematic powersupply.kicad_sch, Velocity Sensor - Version 04]

Parts:
C201, C206, C213, C214, C218: 100n; C_0402_1005Metric; Voltage 50V; MPN CC0402KRX7R9BB104; Digikey_PN 311-3566-1-ND
C202, C203, C207: 22u; C_2220_5650Metric; Voltage 50V; MPN C5750X7R1H226M250KB; Digikey_PN 445-C5750X7R1H226M250KBCT-ND
C204, C205: 4u7; C_1206_3216Metric; Voltage 50V; MPN GRM31CR71H475KA12K; Digikey_PN 490-GRM31CR71H475KA12KCT-ND
C208, C209, C211, C220, C223, C225, C226: 4u7; C_0805_2012Metric; Voltage 50V; MPN CGA4J3X5R1H475K125AB; Mouser_PN 810-CGA4J3X5R1H475K
C210: 1u; C_0402_1005Metric; Voltage 50V; MPN UMK105CBJ105MV-F; Digikey_PN 587-6278-1-ND
C212, C219, C222: 47u; C_1206_3216Metric; Voltage 16V; MPN C3216X5R1C476M160AB; Digikey_PN 445-6003-1-ND
C216: 39p; C_0402_1005Metric; VOLTAGE 50V; Voltage 50V; MPN CC0402FRNPO9BN390; Digikey_PN 311-3733-1-ND
C217: 2u2; C_0805_2012Metric; Voltage 35V; MPN CGA4J1X7R1V225K125AC; Digikey_PN 445-6963-1-ND
FB201, FB202: 2.2k/200mA; L_0805_2012Metric; MPN 742792093; Digikey_PN 732-1609-1-ND
L201: 10u; L_Wuerth_MAPI-3020; MPN 74438336100; Digikey_PN 732-5700-1-ND
L202: 470nH; L_0603_1608Metric; MPN LQM18PNR47NC0L; Digikey_PN 490-LQM18PNR47NC0LCT-ND
L203, L205: 15u 1.9A; L_Wuerth_MAPI-4020; MPN 74438356150; Digikey_PN 732-11663-1-ND
Logo201: LOGO_AGU; AGU_15mm
R201: 69k8; R_0402_1005Metric; MPN RC0402FR-0769K8L; Digikey_PN YAG3216CT-ND
R202: 91k; R_0402_1005Metric; MPN RC0402FR-0791KL; Digikey_PN 311-91.0KLRCT-ND
R203, R209: 22k1; R_0402_1005Metric; MPN RC0402FR-0722K1L; Digikey_PN 311-22.1KLRCT-ND
R204, R210: 40k2; R_0402_1005Metric; MPN RC0402FR-0740K2L; Digikey_PN 311-40.2KLRCT-ND
R207: 102k; R_0402_1005Metric; MPN RC0402FR-07102KL; Digikey_PN YAG2944CT-ND
R208: 68k1; R_0402_1005Metric; MPN RC0402FR-0768K1L; Digikey_PN YAG3213CT-ND
U201, U203: LMR54406; SOT-23-6; MPN LMR54406FDBVR; Digikey_PN 296-LMR54406FDBVRCT-ND
U202: LM27761; WSON-8-1EP_2x2mm_P0.5mm_EP0.9x1.6mm; MPN LM27761DSGR; Digikey_PN 296-44379-1-ND
U204: LT3042EMSE; MSOP-10-1EP_3x3mm_P0.5mm_EP1.68x1.88mm; MPN LT3042EMSE#TRPBF; Digikey_PN LT3042EMSE#TRPBFCT-ND

Connections:
+3V3: C207.1, L203.2, R201.1; also elsewhere on the board
/Interface/VBat: C202.1, C203.1, L201.1; also elsewhere on the board
/Microcontroller/Rx_Ena: R208.1, U203.4 (EN); also elsewhere on the board
/PowerSupply/U201_SW: C201.2, L203.1, U201.6 (SW)
/PowerSupply/U202_Vout: C211.1, FB201.1, R202.1, U202.4 (VOUT)
unnamed: C201.1, U201.1 (CB)
unnamed: C205.1, C206.1, L202.2, U201.4 (EN), U201.5 (VIN)
unnamed: R201.2, R203.1, U201.3 (FB)
unnamed: C210.1, U202.8 (C+)
unnamed: C210.2, U202.7 (C-)
unnamed: C208.1, U202.3 (CPOUT)
unnamed: R202.2, R204.1, U202.5 (VFB)
unnamed: C225.1, R210.1, U204.7 (SET)
VDDA: C226.1, U204.9 (OUTS), U204.10 (OUT); also elsewhere on the board
VSSA: C212.1, FB201.2; also elsewhere on the board

Notes on the sheet:
Outbound Filter fc = 7.6kHz
Inbound Filter fc = 13.4kHz
*R207: 100k => 4.42V
fsw = 1.1MHz
fc = 107kHz
Analog Supply: Rx OpAmp
VFB=0.8V
Analog Supply: LDO
3.3V / XXXmA
4.49V / XXXmA (Intermediate Voltage Rail)
Digital Supply: Microcontroller
ULTRALOW 1/f NOISE REFERENCE BUFFER
VOUT=ISET*RSET ISET(TYP)=100uA RSET=40.2k -> VSET=4.02V
4V / 35mA Analog Supply (Low Noise)
protect SET pint by guard ring (OUT)
VFB=-1.22V
*PGFB to IN for fast start
-4V / ~20mA

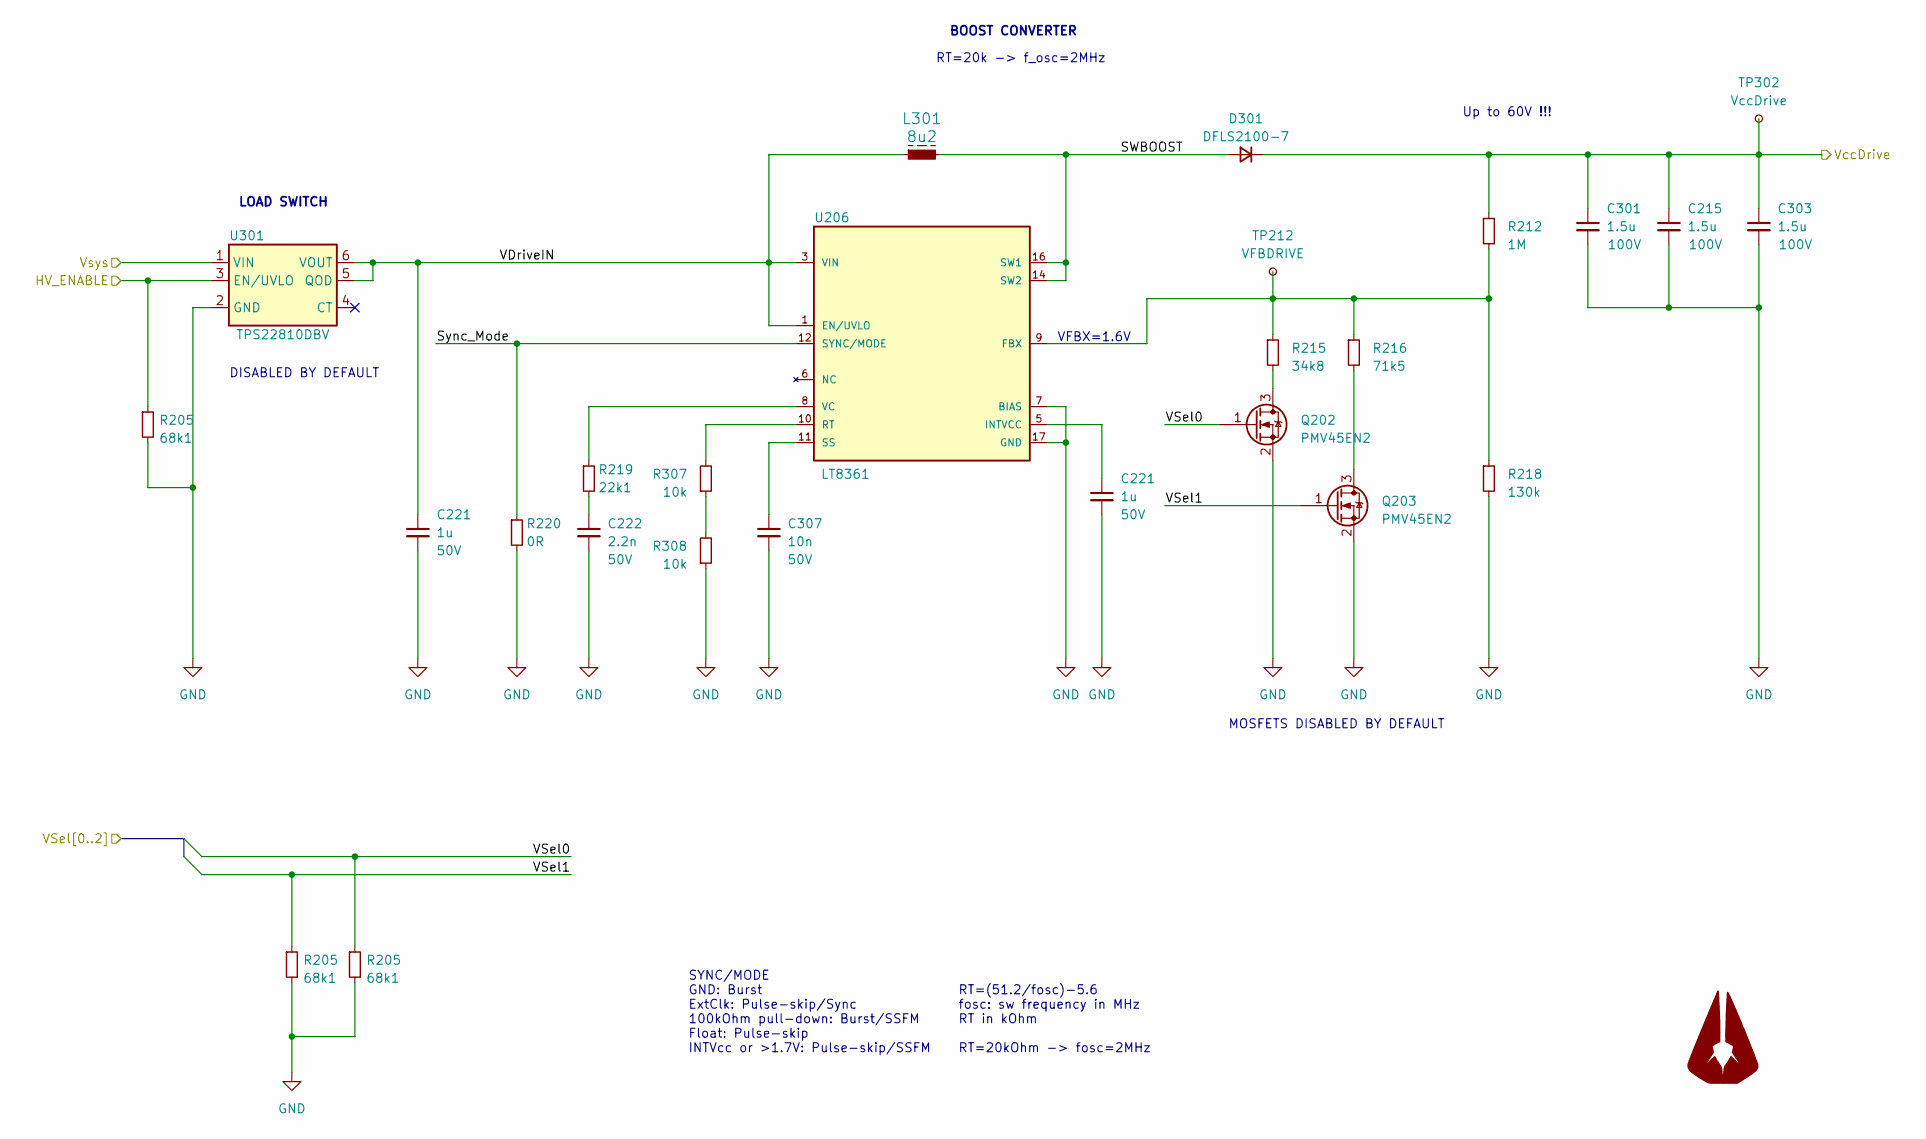
[picture p45: schematic hv_supply.kicad_sch, Velocity Sensor - Version 04]

Parts:
C215, C301, C303: 1.5u; C_1206_3216Metric; Voltage 100V; MPN C3216X7S2A155K160AB; Mouser_PN 810-C3216X7S2A155K1B
C221: 1u; C_0402_1005Metric; Voltage 50V; MPN UMK105CBJ105MV-F; Digikey_PN 587-6278-1-ND
C222: 2.2n; C_0402_1005Metric; Voltage 50V; MPN C0402C222J5RAC7867; Digikey_PN 399-C0402C222J5RAC7867CT-ND
C307: 10n; C_0402_1005Metric; Voltage 50V; MPN GCM155R71H103KA55D; Digikey_PN 399-C0402C222J5RAC7867CT-ND
D301: DFLS2100-7; D_PowerDI-123; MPN DFLS2100-7; Mouser_PN 621-DFLS2100-7
L301: 8u2; IND25X25CZ; MPN IHLP2525CZER8R2M01; Digikey_PN 541-1012-1-ND
Logo301: LOGO_AGU; AGU_15mm
Q202, Q203: PMV45EN2; SOT-23; MPN PMV45EN2R; Mouser_PN 771-PMV45EN2R
R205: 68k1; R_0402_1005Metric; MPN RC0402FR-0768K1L; Digikey_PN YAG3213CT-ND
R212: 1M; R_0402_1005Metric; MPN CRGCQ0402F1M0; Digikey_PN A129663CT-ND
R215: 34k8; R_0402_1005Metric; MPN RMCF0402FT34K8; Digikey_PN RMCF0402FT34K8CT-ND
R216: 71k5; R_0402_1005Metric; MPN RC0402FR-0771K5L; Digikey_PN YAG3222CT-ND
R218: 130k; R_0402_1005Metric; MPN RC0402FR-07130KL; Digikey_PN YAG2969CT-ND
R219: 22k1; R_0402_1005Metric; MPN RC0402FR-0722K1L; Digikey_PN 311-22.1KLRCT-ND
R220: 0R; R_0402_1005Metric; MPN RC0402JR-070RL; Digikey_PN 311-0.0JRCT-ND
R307, R308: 10k; R_0402_1005Metric; MPN RC1005F103CS; Digikey_PN 1276-3431-1-ND
TP212: VFBDRIVE; TestPoint_Pad_D1.0mm
TP302: VccDrive; TestPoint_Pad_D1.0mm
U206: LT8361; SOP50P490X110-17N; MPN LT8361HMSE#PBF; Digikey_PN 505-LT8361HMSE#PBF-ND
U301: TPS22810DBV; SOT95P280X145-6N; MPN TPS22810TDBVRQ1; Digikey_PN 296-50496-1-ND

Connections:
/High Voltage Supply/SWBOOST: D301.2 (A), L301.2; also elsewhere on the board
/High Voltage Supply/VDriveIN: L301.1, U301.5 (QOD), U301.6 (VOUT); also elsewhere on the board
/Microcontroller/HV_ENABLE: U301.3 (EN/UVLO); also elsewhere on the board
unnamed: R307.1, R308.2
unnamed 132: R307.2; also elsewhere on the board
unnamed 133: C307.1; also elsewhere on the board

Notes on the sheet:
RT=(51.2/fosc)-5.6 fosc: sw frequency in MHz RT in kOhm RT=20kOhm -> fosc=2MHz
LOAD SWITCH
DISABLED BY DEFAULT
Up to 60V !!!
SYNC/MODE GND: Burst ExtClk: Pulse-skip/Sync 100kOhm pull-down: Burst/SSFM Float: Pulse-skip INTVcc or >1.7V: Pulse-skip/SSFM
MOSFETS DISABLED BY DEFAULT
RT=20k -> f_osc=2MHz
BOOST CONVERTER
VFBX=1.6V
