edgarvela-soc/vsensor_v4_temp/pp1_vsensor_v4.kicad_pcb

## KiCad design pp1_vsensor_v4.kicad_pcb (continued)

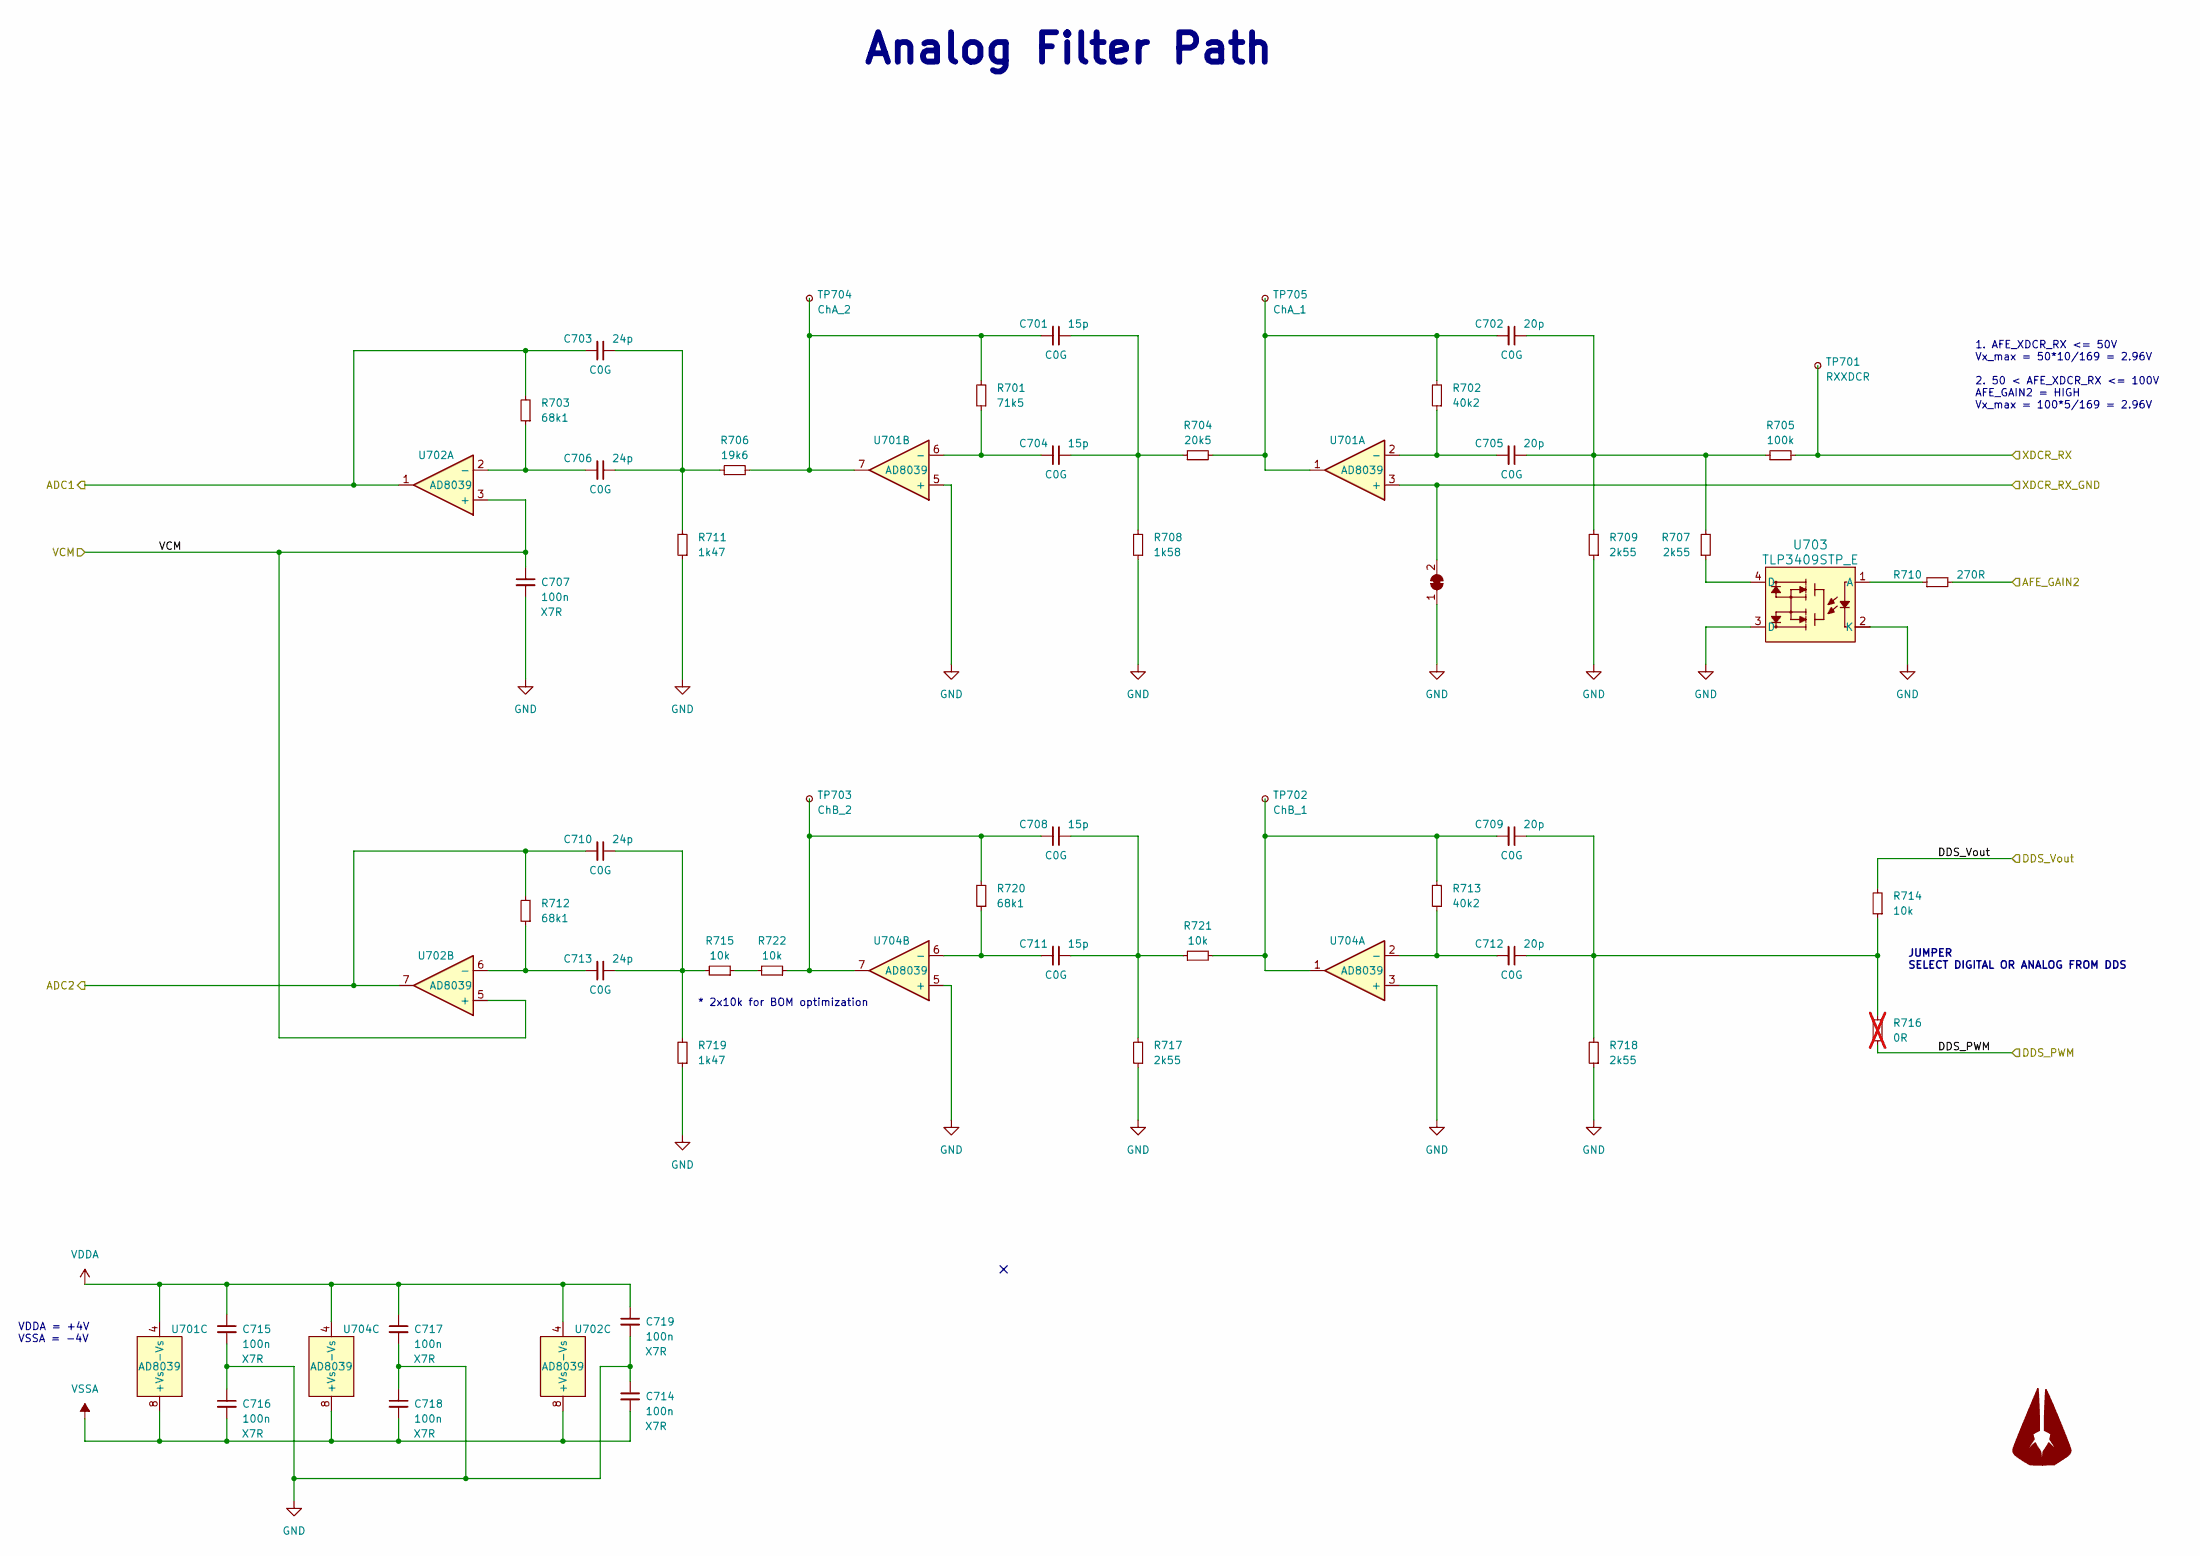
[picture p46: schematic analog_front_end.kicad_sch, Velocity Sensor - Version 04]

Parts:
C701, C704, C708, C711: 15p; C_0402_1005Metric; MPN CC0402JRNPO9BN150; Digikey_PN 311-1017-1-ND
C702, C705, C709, C712: 20p; C_0402_1005Metric; MPN CC0402JRNPO9BN200; Digikey_PN 311-1417-1-ND
C703, C706, C710, C713: 24p; C_0402_1005Metric; MPN CC0402JRNPO9BN240; Digikey_PN 311-1348-1-ND
C707, C714, C715, C716, C717, C718, C719: 100n; C_0402_1005Metric; Voltage 50V; MPN CC0402KRX7R9BB104; Digikey_PN 311-3566-1-ND
JP701: Bridged; NetTie-2_SMD_Pad0.5mm
Logo701: LOGO_AGU; AGU_15mm
R701: 71k5; R_0402_1005Metric; MPN RC0402FR-0771K5L; Digikey_PN YAG3222CT-ND
R702, R713: 40k2; R_0402_1005Metric; MPN RC0402FR-0740K2L; Digikey_PN 311-40.2KLRCT-ND
R703, R712, R720: 68k1; R_0402_1005Metric; MPN RC0402FR-0768K1L; Digikey_PN YAG3213CT-ND
R704: 20k5; R_0402_1005Metric; MPN RC0402FR-0720K5L; Digikey_PN YAG3052CT-ND
R705: 100k; R_0603_1608Metric; MPN RC0402FR-07100KL; Digikey_PN 311-100KLRCT-ND
R706: 19k6; R_0402_1005Metric; MPN RC0402FR-0719K6L; Digikey_PN YAG3026CT-ND
R707, R709, R717, R718: 2k55; R_0402_1005Metric; MPN RC0402FR-072K55L; Digikey_PN YAG3102CT-ND
R708: 1k58; R_0402_1005Metric; MPN RC0402FR-071K58L; Digikey_PN YAG3041CT-ND
R710: 270R; R_0402_1005Metric; MPN RMCF0402FT270R; Digikey_PN RMCF0402FT270RCT-ND
R711, R719: 1k47; R_0402_1005Metric; MPN RC0402FR-071K47L; Digikey_PN YAG3038CT-ND
R714, R715, R721, R722: 10k; R_0402_1005Metric; MPN RC1005F103CS; Digikey_PN 1276-3431-1-ND
R716: 0R; R_0402_1005Metric; MPN RC0402JR-070RL; Digikey_PN 311-0.0JRCT-ND; not fitted
TP701: RXXDCR; TestPoint_Pad_D1.0mm
TP702: ChB_1; TestPoint_Pad_D1.0mm
TP703: ChB_2; TestPoint_Pad_D1.0mm
TP704: ChA_2; TestPoint_Pad_D1.0mm
TP705: ChA_1; TestPoint_Pad_D1.0mm
U701, U702, U704: AD8039; SOT-23-8; MPN AD8039ARTZ-REEL7; Digikey_PN 505-AD8039ARTZ-REEL7CT-ND
U703: TLP3409STP_E; MPN TLP3409S(TP,E; Mouser_PN 757-TLP3409STPE

Connections:
/ADC/ADC1: C703.2, R703.2, U702.1; also elsewhere on the board
/ADC/ADC2: C710.2, R712.2, U702.7; also elsewhere on the board
/ADC/VCM: C707.1, U702.3 (+), U702.5 (+); also elsewhere on the board
/Analog Frontend/DDS_PWM: R716.1; also elsewhere on the board
/Analog Frontend/DDS_Vout: R714.2; also elsewhere on the board
/Microcontroller/AFE_GAIN2: R710.2; also elsewhere on the board
/Transducer Multiplexer/MUX_XDCR: R705.2, TP701.1; also elsewhere on the board
unnamed: C701.1, C704.1, R704.1, R708.2
unnamed: C701.2, R701.2, R706.2, TP704.1, U701.7
unnamed: C702.1, C705.1, R705.1, R707.2, R709.2
unnamed: C702.2, R702.2, R704.2, TP705.1, U701.1
unnamed: C703.1, C706.1, R706.1, R711.2
unnamed: C708.1, C711.1, R717.2, R721.1
unnamed: C708.2, R720.2, R722.1, TP703.1, U704.7
unnamed: C709.1, C712.1, R714.1, R716.2, R718.2
unnamed: C709.2, R713.2, R721.2, TP702.1, U704.1
unnamed: C710.1, C713.1, R715.2, R719.2
unnamed: R707.1, U703.4 (D)
unnamed: R715.1, R722.2
unnamed: C705.2, R702.1, U701.2 (-)
unnamed: C704.2, R701.1, U701.6 (-)
unnamed: C706.2, R703.1, U702.2 (-)
unnamed: C713.2, R712.1, U702.6 (-)
unnamed: R710.1, U703.1 (A)
unnamed: C712.2, R713.1, U704.2 (-)
unnamed: C711.2, R720.1, U704.6 (-)
VDDA: C715.1, C717.1, C719.1, U701.4 (-Vs), U702.4 (-Vs), U704.4 (-Vs); also elsewhere on the board
VSSA: C714.2, C716.2, C718.2, U701.8 (+Vs), U702.8 (+Vs), U704.8 (+Vs); also elsewhere on the board

Notes on the sheet:
1. AFE_XDCR_RX <= 50V Vx_max = 50*10/169 = 2.96V 2. 50 < AFE_XDCR_RX <= 100V AFE_GAIN2 = HIGH Vx_max = 100*5/169 = 2.96V
JUMPER SELECT DIGITAL OR ANALOG FROM DDS
* 2x10k for BOM optimization
VDDA = +4V VSSA = -4V
Analog Filter Path

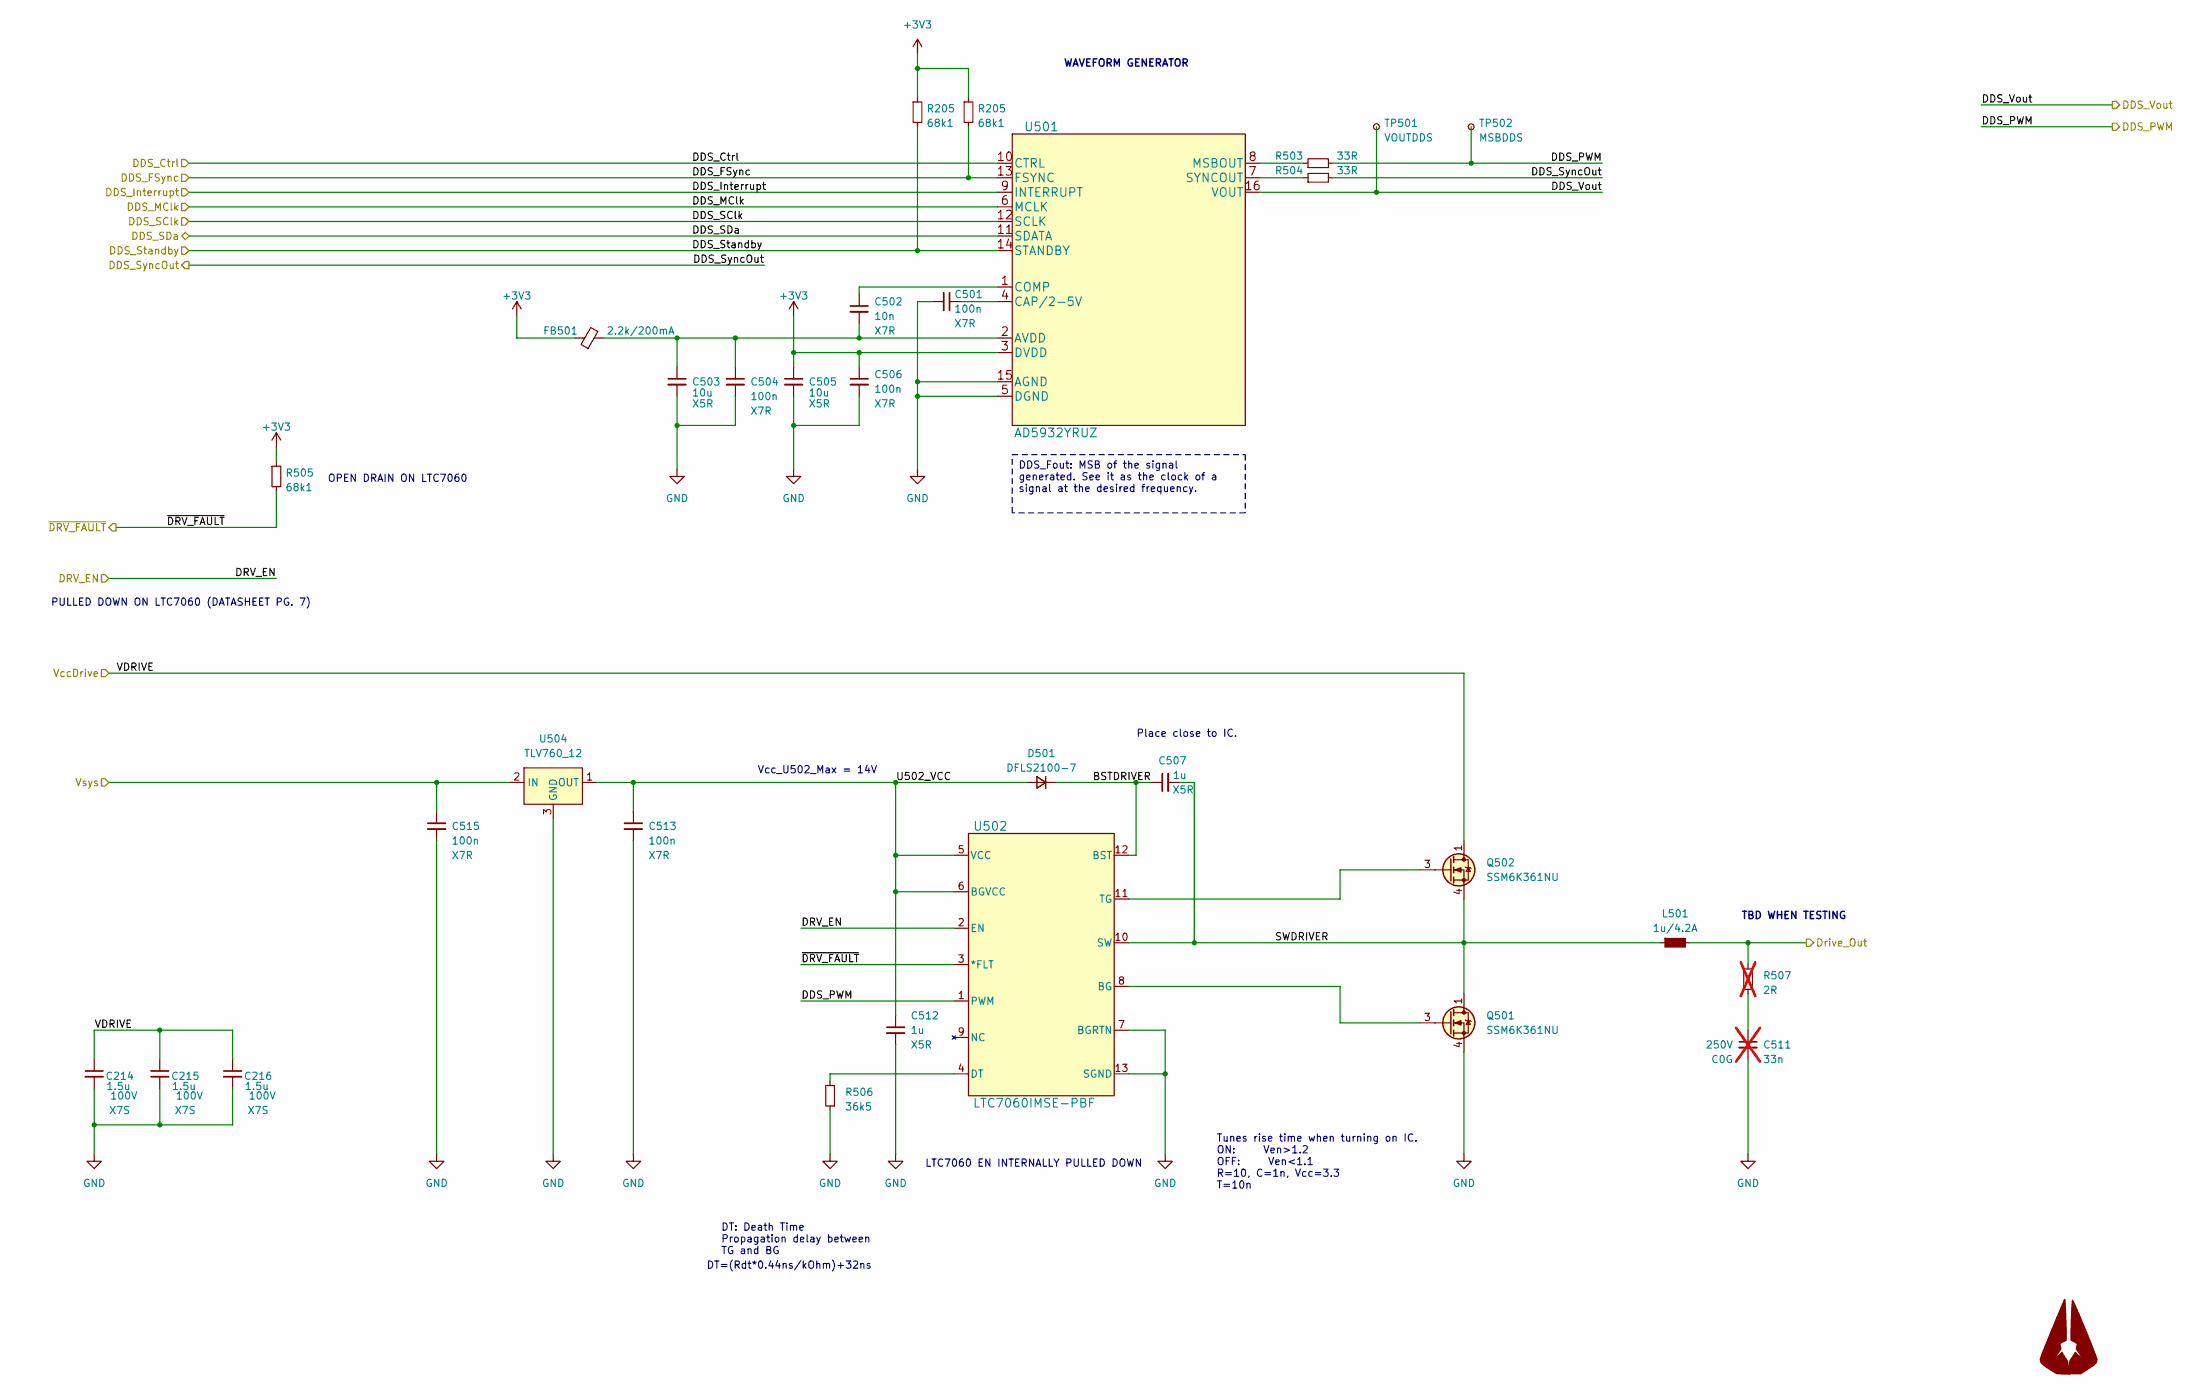
[picture p47: schematic generator.kicad_sch, Velocity Sensor - Version 04]

Parts:
C214, C215, C216: 1.5u; C_1206_3216Metric; Voltage 100V; MPN C3216X7S2A155K160AB; Mouser_PN 810-C3216X7S2A155K1B
C501, C504, C506, C513, C515: 100n; C_0402_1005Metric; Voltage 50V; MPN CC0402KRX7R9BB104; Digikey_PN 311-3566-1-ND
C502: 10n; C_0402_1005Metric; Voltage 50V; MPN GCM155R71H103KA55D; Digikey_PN 399-C0402C222J5RAC7867CT-ND
C503, C505: 10u; C_0603_1608Metric; Voltage 25V; MPN GRM188R61E106MA73D; Mouser_PN 81-GRM188R61E106MA3D
C507, C512: 1u; C_0402_1005Metric; Voltage 50V; MPN UMK105CBJ105MV-F; Digikey_PN 587-6278-1-ND
C511: 33n; C_0805_2012Metric; Voltage 250V; MPN 885342206005; Digikey_PN 732-12160-1-ND; not fitted
D501: DFLS2100-7; D_PowerDI-123; MPN DFLS2100-7; Mouser_PN 621-DFLS2100-7
FB501: 2.2k/200mA; L_0805_2012Metric; MPN 742792093; Digikey_PN 732-1609-1-ND
L501: 1u/4.2A; RES_CIGT201610; MPN CIGT201610EH1R0MNE; Digikey_PN 1276-6900-1-ND
Logo501: LOGO_AGU; AGU_15mm
Q501, Q502: SSM6K361NU; UDFN6B_TOS; MPN SSM6K361NU,LF; Digikey_PN SSM6K361NULFCT-ND
R205, R505: 68k1; R_0402_1005Metric; MPN RC0402FR-0768K1L; Digikey_PN YAG3213CT-ND
R503, R504: 33R; R_0402_1005Metric; MPN RC0402JR-0733RL; Digikey_PN 311-33JRCT-ND
R506: 36k5; R_0402_1005Metric; MPN ERJ-2RKF3652X; Digikey_PN P36.5KLCT-ND
R507: 2R; R_0805_2012Metric; MPN RMCF0603FT2R00; Digikey_PN RMCF0603FT2R00CT-ND; not fitted
TP501: VOUTDDS; TestPoint_Pad_D1.0mm
TP502: MSBDDS; TestPoint_Pad_D1.0mm
U501: AD5932YRUZ; MPN AD5932YRUZ; Mouser_PN 584-AD5932YRUZ
U502: LTC7060IMSE-PBF; LTC7060; MPN LTC7060IMSE#WTRPBF; Mouser_PN 584-7060IMSE#WTRPBF
U504: TLV760_12; SOT-23; MPN TLV76012DBZR; Digikey_PN 296-48331-1-ND

Connections:
+3V3: C505.1, C506.1, FB501.1, R505.1, U501.3 (DVDD); also elsewhere on the board
/Analog Frontend/DDS_PWM: R503.2, TP502.1, U502.1 (PWM); also elsewhere on the board
/Analog Frontend/DDS_Vout: TP501.1, U501.16 (VOUT); also elsewhere on the board
/Microcontroller/DDS_Ctrl: U501.10 (CTRL); also elsewhere on the board
/Microcontroller/DDS_FSync: U501.13 (FSYNC); also elsewhere on the board
/Microcontroller/DDS_INTERRUPT: U501.9 (INTERRUPT); also elsewhere on the board
/Microcontroller/DDS_MClk: U501.6 (MCLK); also elsewhere on the board
/Microcontroller/DDS_SClk: U501.12 (SCLK); also elsewhere on the board
/Microcontroller/DDS_SYNCOUT: R504.2; also elsewhere on the board
/Microcontroller/DDS_Sda: U501.11 (SDATA); also elsewhere on the board
/Microcontroller/DDS_Standby: U501.14 (STANDBY); also elsewhere on the board
/Microcontroller/DRIVE_EN: U502.2 (EN); also elsewhere on the board
/Microcontroller/~DRV_FAULT: R505.2, U502.3 (*FLT); also elsewhere on the board
/Signal Generator/BSTDRIVER: C507.1, D501.1 (K), U502.12 (BST)
/Signal Generator/SWDRIVER: C507.2, L501.1, Q501.1 (D), Q501.2 (D), Q501.5 (D), Q501.6 (D), Q501.7 (D), Q502.4 (S), Q502.8 (S), U502.10 (SW)
/Signal Generator/U502_VCC: C512.1, C513.1, D501.2 (A), U502.5 (VCC), U502.6 (BGVCC), U504.1 (OUT)
/Transducer Multiplexer/MUX_XDCR: L501.2, R507.2; also elsewhere on the board
unnamed: C511.1, R507.1
unnamed: Q501.3 (G), U502.8 (BG)
unnamed: Q502.3 (G), U502.11 (TG)
unnamed: C502.2, C503.1, C504.1, FB501.2, U501.2 (AVDD)
unnamed: C501.1, U501.4 (CAP/2-5V)
unnamed: C502.1, U501.1 (COMP)
unnamed: R503.1, U501.8 (MSBOUT)
unnamed: R504.1, U501.7 (SYNCOUT)
unnamed: R506.2, U502.4 (DT)

Notes on the sheet:
DDS_Fout: MSB of the signal generated. See it as the clock of a signal at the desired frequency.
Place close to IC.
Tunes rise time when turning on IC. ON: Ven>1.2 OFF: Ven<1.1 R=10, C=1n, Vcc=3.3 T=10n
OPEN DRAIN ON LTC7060
TBD WHEN TESTING
LTC7060 EN INTERNALLY PULLED DOWN
WAVEFORM GENERATOR
DT=(Rdt*0.44ns/kOhm)+32ns
PULLED DOWN ON LTC7060 (DATASHEET PG. 7)
DT: Death Time Propagation delay between TG and BG
Vcc_U502_Max = 14V

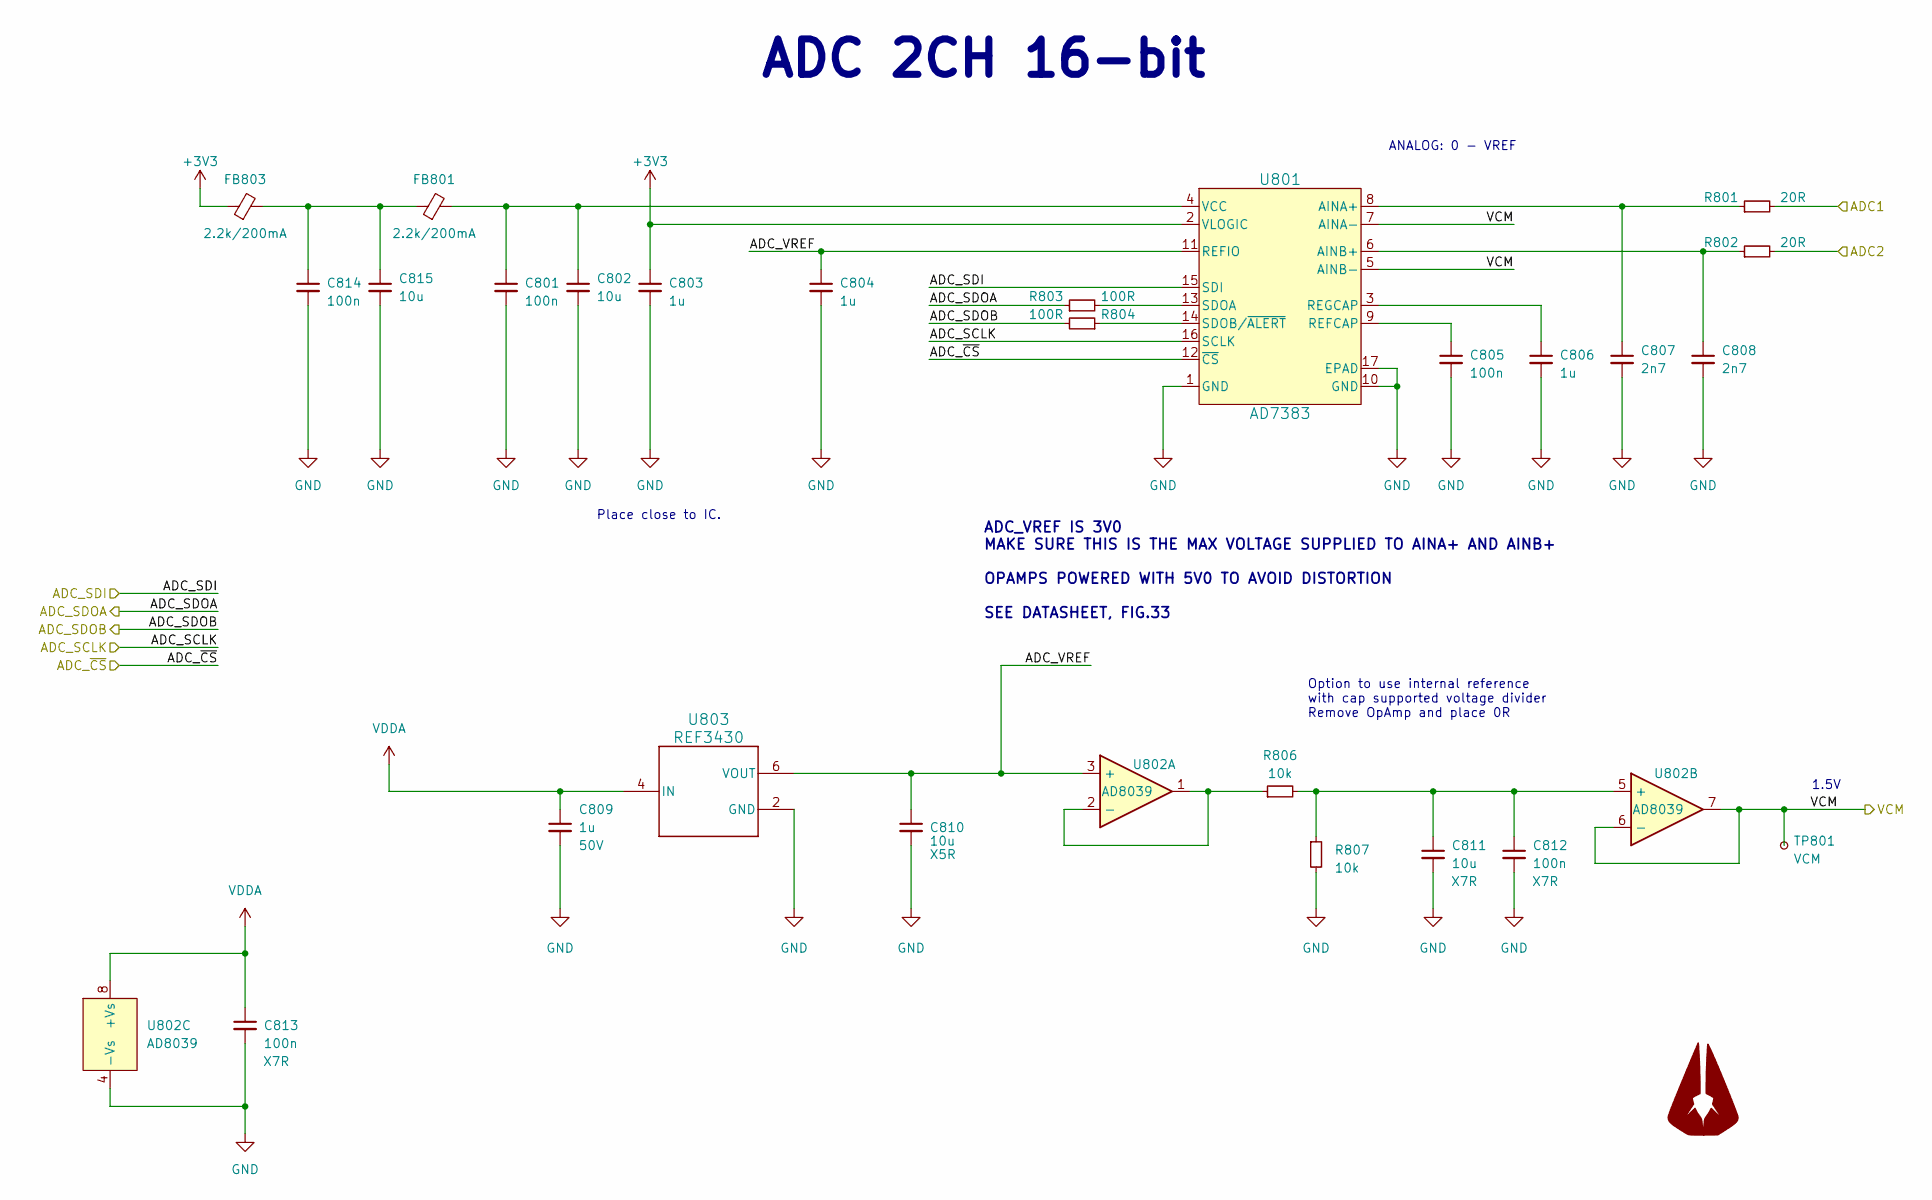
[picture p48: schematic analog_to_digital_conv.kicad_sch, Velocity Sensor - Version 04]

Parts:
C801, C805, C812, C813, C814: 100n; C_0402_1005Metric; Voltage 50V; MPN CC0402KRX7R9BB104; Digikey_PN 311-3566-1-ND
C802, C815: 10u; C_0603_1608Metric; Voltage 25V; MPN GRM188R61E106MA73D; Digikey_PN 490-7202-1-ND
C803, C804, C806: 1u; C_0603_1608Metric; MPN 06035C105KAT2A; Digikey_PN 478-10073-1-ND
C807, C808: 2n7; C_0603_1608Metric; MPN CC0603KRX7R9BB272; Digikey_PN 311-1809-1-ND
C809: 1u; C_0402_1005Metric; Voltage 50V; MPN UMK105CBJ105MV-F; Digikey_PN 587-6278-1-ND
C810, C811: 10u; C_0603_1608Metric; Voltage 25V; MPN GRM188R61E106MA73D; Mouser_PN 81-GRM188R61E106MA3D
FB801, FB803: 2.2k/200mA; L_0805_2012Metric; MPN 742792093; Digikey_PN 732-1609-1-ND
Logo801: LOGO_AGU; AGU_15mm
R801, R802: 20R; R_0402_1005Metric; MPN RC0402FR-0720RL; Digikey_PN 311-20LRCT-ND
R803, R804: 100R; R_0402_1005Metric; MPN RC0402FR-07100RL; Digikey_PN 311-100LRCT-ND
R806, R807: 10k; R_0402_1005Metric; MPN RC1005F103CS; Digikey_PN 1276-3431-1-ND
TP801: VCM; TestPoint_Pad_D1.0mm
U801: AD7383; MPN AD7383BCPZ-RL7; Digikey_PN 505-AD7383BCPZ-RL7CT-ND
U802: AD8039; SOT-23-8; MPN AD8039ARTZ-REEL7; Digikey_PN 505-AD8039ARTZ-REEL7CT-ND
U803: REF3430; MPN REF3430TIDBVR; Digikey_PN 296-REF3430TIDBVRCT-ND

Connections:
+3V3: C803.1, FB803.1, U801.2 (VLOGIC); also elsewhere on the board
/ADC/ADC1: R801.2; also elsewhere on the board
/ADC/ADC2: R802.2; also elsewhere on the board
/ADC/ADC_SCLK: U801.16 (SCLK); also elsewhere on the board
/ADC/ADC_SDI: U801.15 (SDI); also elsewhere on the board
/ADC/ADC_SDOA: R803.1; also elsewhere on the board
/ADC/ADC_SDOB: R804.2; also elsewhere on the board
/ADC/ADC_VREF: C804.1, C810.1, U801.11 (REFIO), U802.3 (+), U803.6 (VOUT)
/ADC/ADC_~CS: U801.12 (~CS); also elsewhere on the board
/ADC/VCM: TP801.1, U801.5 (AINB-), U801.7 (AINA-), U802.6 (-), U802.7; also elsewhere on the board
unnamed: C814.1, C815.1, FB801.1, FB803.2
unnamed: C807.1, R801.1, U801.8 (AINA+)
unnamed: C808.1, R802.1, U801.6 (AINB+)
unnamed: C805.1, U801.9 (REFCAP)
unnamed: C806.1, U801.3 (REGCAP)
unnamed: R803.2, U801.13 (SDOA)
unnamed: R804.1, U801.14 (SDOB/~ALERT)
unnamed: C801.1, C802.1, FB801.2, U801.4 (VCC)
unnamed: R806.1, U802.1, U802.2 (-)
unnamed: C811.1, C812.1, R806.2, R807.1, U802.5 (+)
VDDA: C809.1, C813.1, U802.8 (+Vs), U803.1 (NC), U803.3 (NC), U803.4 (IN), U803.5 (NC); also elsewhere on the board

Notes on the sheet:
ADC_VREF IS 3V0 MAKE SURE THIS IS THE MAX VOLTAGE SUPPLIED TO AINA+ AND AINB+ OPAMPS POWERED WITH 5V0 TO AVOID DISTORTION SEE DATASHEET, FIG.33
ADC 2CH 16-bit
Option to use internal reference with cap supported voltage divider Remove OpAmp and place 0R
Place close to IC.
ANALOG: 0 - VREF
1.5V

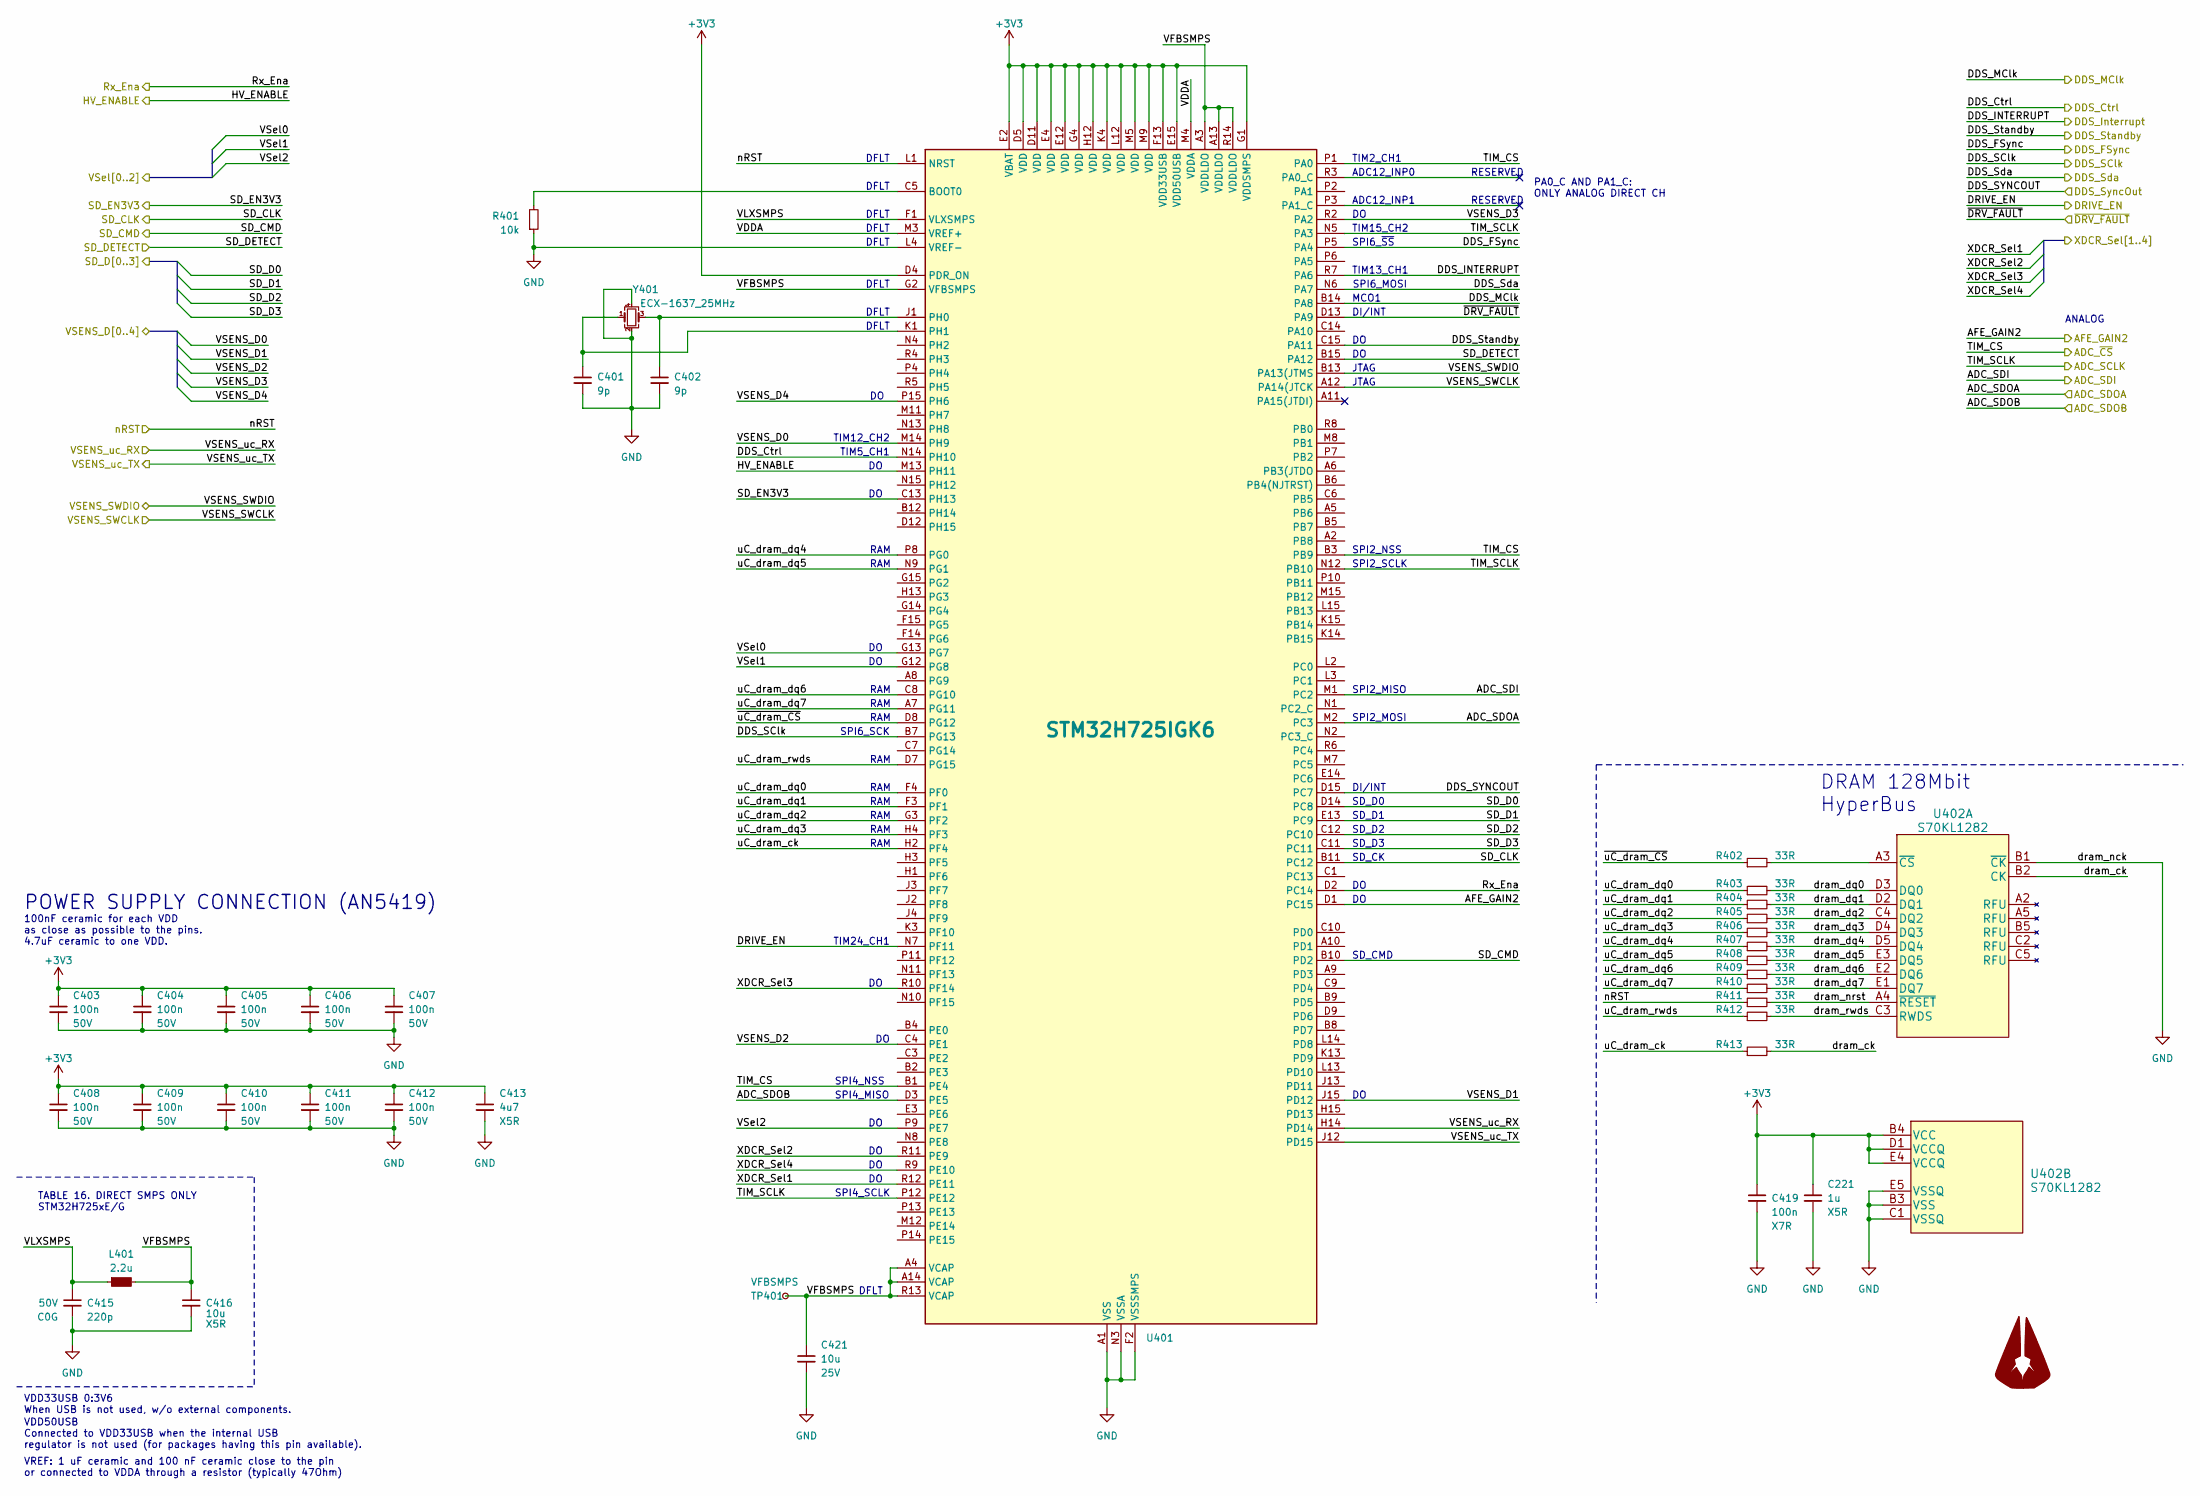
[picture p49: schematic microcontroller.kicad_sch, Velocity Sensor - Version 04]

Parts:
C221: 1u; C_0402_1005Metric; Voltage 50V; MPN UMK105CBJ105MV-F; Digikey_PN 587-6278-1-ND
C401, C402: 9p; C_0402_1005Metric; MPN GRM1555C1H9R0BA01D; Digikey_PN 490-6257-1-ND
C403, C404, C405, C406, C407, C408, C409, C410, C411, C412, C419: 100n; C_0402_1005Metric; Voltage 50V; MPN CC0402KRX7R9BB104; Digikey_PN 311-3566-1-ND
C413: 4u7; C_0402_1005Metric; Voltage 25V; MPN 04023D475MAT2A; Digikey_PN 478-04023D475MAT2ACT-ND
C415: 220p; C_0402_1005Metric; Voltage 50V; MPN 0402N221J500CT; Digikey_PN 1292-1286-1-ND
C416, C421: 10u; C_0603_1608Metric; Voltage 25V; MPN GRM188R61E106MA73D; Mouser_PN 81-GRM188R61E106MA3D
L401: 2.2u; Inductor_0806; MPN DFE201612PD-2R2M=P2; Mouser_PN 81-DFE201612PD2R2P2
Logo401: LOGO_AGU; AGU_15mm
R401: 10k; R_0402_1005Metric; MPN RC1005F103CS; Digikey_PN 1276-3431-1-ND
R402, R403, R404, R405, R406, R407, R408, R409, R410, R411, R412, R413: 33R; R_0402_1005Metric; MPN RC0402JR-0733RL; Digikey_PN 311-33JRCT-ND
TP401: VFBSMPS; TestPoint_Pad_D1.0mm
U401: STM32H725IGK6; UFBGA-201_10x10mm_Layout15x15_P0.65mm; MPN STM32H725IGK6; Digikey_PN 497-STM32H725IGK6-ND
U402: S70KL1282; S27KS0642GABHV020; MPN S70KL1282GABHV020; Digikey_PN 448-S70KL1282GABHV020-ND
Y401: ECX-1637_25MHz; XTAL_ECS-160-9-37-CKM-TR; MPN ECS-250-8-37-RWN-TR; Digikey_PN XC2484CT-ND

Connections:
+3V3: C403.1, C404.1, C405.1, C406.1, C407.1, C408.1, C409.1, C410.1, C411.1, C412.1, C413.1, C419.1, U401.D4 (PDR_ON), U401.D5 (VDD), U401.D11 (VDD), U401.E2 (VBAT), U401.E4 (VDD), U401.E12 (VDD), U401.E15 (VDD50USB), U401.F13 (VDD33USB), U401.G1 (VDDSMPS), U401.G4 (VDD), U401.H12 (VDD), U401.K4 (VDD), U401.L12 (VDD), U401.M5 (VDD), U401.M9 (VDD), U402.B4 (VCC), U402.D1 (VCCQ), U402.E4 (VCCQ); also elsewhere on the board
/ADC/ADC_SCLK: U401.N5 (PA3), U401.N12 (PB10), U401.P12 (PE12); also elsewhere on the board
/ADC/ADC_SDI: U401.M1 (PC2); also elsewhere on the board
/ADC/ADC_SDOA: U401.M2 (PC3); also elsewhere on the board
/ADC/ADC_SDOB: U401.D3 (PE5); also elsewhere on the board
/ADC/ADC_~CS: U401.B1 (PE4), U401.B3 (PB9), U401.P1 (PA0); also elsewhere on the board
/High Voltage Supply/VSel0: U401.G13 (PG7); also elsewhere on the board
/High Voltage Supply/VSel1: U401.G12 (PG8); also elsewhere on the board
/High Voltage Supply/VSel2: U401.P9 (PE7)
/Interface/SD_CLK: U401.B11 (PC12); also elsewhere on the board
/Interface/SD_CMD: U401.B10 (PD2); also elsewhere on the board
/Interface/SD_D0: U401.D14 (PC8); also elsewhere on the board
/Interface/SD_D1: U401.E13 (PC9); also elsewhere on the board
/Interface/SD_D2: U401.C12 (PC10); also elsewhere on the board
/Interface/SD_D3: U401.C11; also elsewhere on the board
/Interface/SD_DETECT: U401.B15 (PA12); also elsewhere on the board
/Interface/VSENS_D0: U401.M14 (PH9); also elsewhere on the board
/Interface/VSENS_D1: U401.J15 (PD12); also elsewhere on the board
/Interface/VSENS_D2: U401.C4 (PE1); also elsewhere on the board
/Interface/VSENS_D3: U401.R2 (PA2); also elsewhere on the board
/Interface/VSENS_D4: U401.P15 (PH6); also elsewhere on the board
/Interface/VSENS_SWCLK: U401.A12 (PA14(JTCK); also elsewhere on the board
/Interface/VSENS_SWDIO: U401.B13 (PA13(JTMS); also elsewhere on the board
/Interface/VSENS_uc_RX: U401.H14 (PD14); also elsewhere on the board
/Interface/VSENS_uc_TX: U401.J12 (PD15); also elsewhere on the board
/Interface/nRST: R411.1, U401.L1 (NRST); also elsewhere on the board
/Microcontroller/AFE_GAIN2: U401.D1 (PC15); also elsewhere on the board
/Microcontroller/DDS_Ctrl: U401.N14 (PH10); also elsewhere on the board
/Microcontroller/DDS_FSync: U401.P5 (PA4); also elsewhere on the board
/Microcontroller/DDS_INTERRUPT: U401.R7 (PA6); also elsewhere on the board
/Microcontroller/DDS_MClk: U401.B14 (PA8); also elsewhere on the board
/Microcontroller/DDS_SClk: U401.B7 (PG13); also elsewhere on the board
/Microcontroller/DDS_SYNCOUT: U401.D15 (PC7); also elsewhere on the board
/Microcontroller/DDS_Sda: U401.N6 (PA7); also elsewhere on the board
/Microcontroller/DDS_Standby: U401.C15 (PA11); also elsewhere on the board
/Microcontroller/DRIVE_EN: U401.N7 (PF11); also elsewhere on the board
/Microcontroller/HV_ENABLE: U401.M13 (PH11); also elsewhere on the board
/Microcontroller/Rx_Ena: U401.D2 (PC14); also elsewhere on the board
/Microcontroller/SD_EN3V3: U401.C13 (PH13); also elsewhere on the board
/Microcontroller/VDDA: U401.M3 (VREF+), U401.M4 (VDDA)
/Microcontroller/VFBSMPS: C416.1, C421.1, L401.2, TP401.1, U401.A3 (VDDLDO), U401.A4 (VCAP), U401.A13 (VDDLDO), U401.A14 (VCAP), U401.G2 (VFBSMPS), U401.R13 (VCAP), U401.R14 (VDDLDO)
/Microcontroller/VLXSMPS: C415.1, L401.1, U401.F1 (VLXSMPS)
/Microcontroller/XDCR_Sel1: U401.R12 (PE11); also elsewhere on the board
/Microcontroller/XDCR_Sel2: U401.R11 (PE9); also elsewhere on the board
/Microcontroller/XDCR_Sel3: U401.R10 (PF14); also elsewhere on the board
/Microcontroller/XDCR_Sel4: U401.R9 (PE10); also elsewhere on the board
/Microcontroller/dram_ck: R413.2, U402.B2 (CK)
/Microcontroller/dram_dq0: R403.2, U402.D3 (DQ0)
/Microcontroller/dram_dq1: R404.2, U402.D2 (DQ1)
/Microcontroller/dram_dq2: R405.2, U402.C4 (DQ2)
/Microcontroller/dram_dq3: R406.2, U402.D4 (DQ3)
/Microcontroller/dram_dq4: R407.2, U402.D5 (DQ4)
/Microcontroller/dram_dq5: R408.2, U402.E3 (DQ5)
/Microcontroller/dram_dq6: R409.2, U402.E2 (DQ6)
/Microcontroller/dram_dq7: R410.2, U402.E1 (DQ7)
/Microcontroller/dram_nrst: R411.2, U402.A4 (~RESET)
/Microcontroller/dram_rwds: R412.2, U402.C3 (RWDS)
/Microcontroller/uC_dram_ck: R413.1, U401.H2 (PF4)
/Microcontroller/uC_dram_dq0: R403.1, U401.F4 (PF0)
/Microcontroller/uC_dram_dq1: R404.1, U401.F3 (PF1)
/Microcontroller/uC_dram_dq2: R405.1, U401.G3 (PF2)
/Microcontroller/uC_dram_dq3: R406.1, U401.H4 (PF3)
/Microcontroller/uC_dram_dq4: R407.1, U401.P8 (PG0)
/Microcontroller/uC_dram_dq5: R408.1, U401.N9 (PG1)
/Microcontroller/uC_dram_dq6: R409.1, U401.C8 (PG10)
/Microcontroller/uC_dram_dq7: R410.1, U401.A7 (PG11)
/Microcontroller/uC_dram_rwds: R412.1, U401.D7 (PG15)
/Microcontroller/~DRV_FAULT: U401.D13 (PA9); also elsewhere on the board
/Microcontroller/~uC_dram_CS: R402.1, U401.D8 (PG12)
unnamed: R401.2, U401.C5 (BOOT0)
unnamed: C402.1, U401.J1 (PH0), Y401.3
unnamed: C401.1, U401.K1 (PH1), Y401.1
unnamed: R402.2, U402.A3 (~CS)

Notes on the sheet:
SPI4_MISO
DFLT
VREF: 1 uF ceramic and 100 nF ceramic close to the pin or connected to VDDA through a resistor (typically 47Ohm)
MCO1
DI/INT
SPI6_SCK
SPI2_MISO
SPI4_SCLK
RESERVED
JTAG
RAM
SPI2_NSS
SD_D1
100nF ceramic for each VDD as close as possible to the pins. 4.7uF ceramic to one VDD.
SPI4_NSS
VDD33USB 0:3V6 When USB is not used, w/o external components.
PA0_C AND PA1_C: ONLY ANALOG DIRECT CH
SD_D2
TIM5_CH1
ANALOG
VDD50USB Connected to VDD33USB when the internal USB regulator is not used (for packages having this pin available).
SPI6_MOSI
SD_CMD
TABLE 16. DIRECT SMPS ONLY STM32H725xE/G
SPI6_~{SS}
SD_D0
ADC12_INP1
SPI2_SCLK
TIM2_CH1
DRAM 128Mbit HyperBus
TIM24_CH1
ADC12_INP0
TIM13_CH1
SD_D3
SD_CK
POWER SUPPLY CONNECTION (AN5419)
TIM15_CH2
TIM12_CH2
SPI2_MOSI

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
