edgarvela-soc/vsensor_v4_temp/pp1_vsensor_v4.kicad_pcb

## KiCad design pp1_vsensor_v4.kicad_pcb (continued)

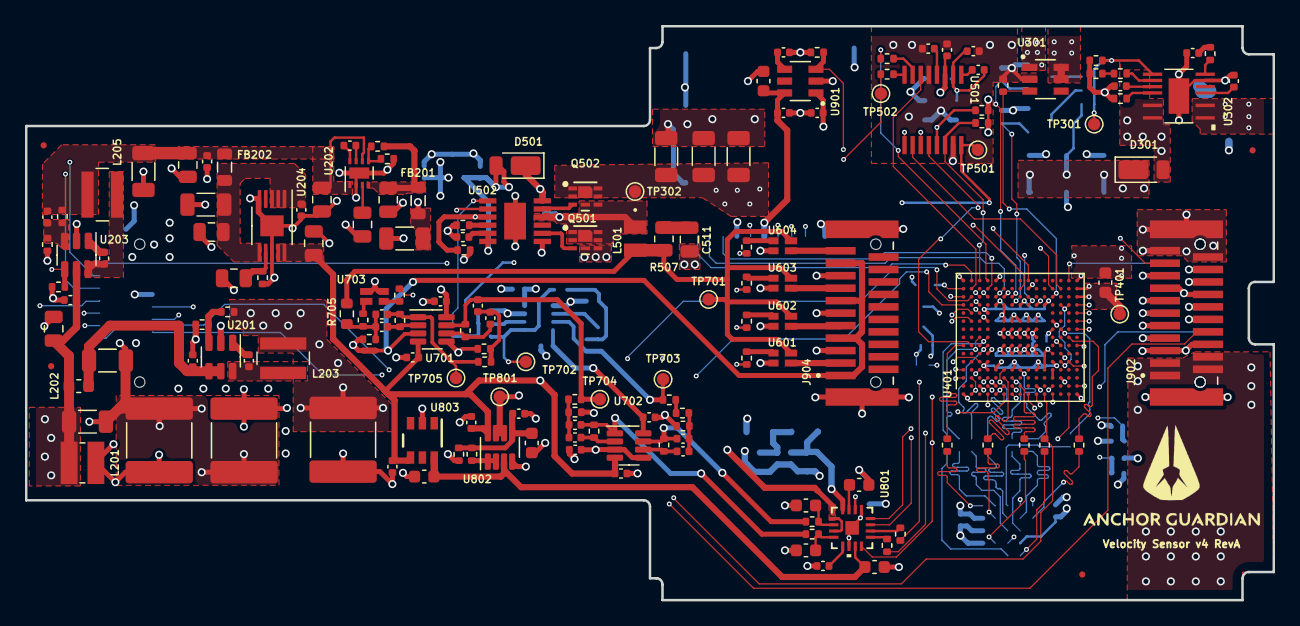
[picture p50: board pp1_vsensor_v4.kicad_pcb from above]

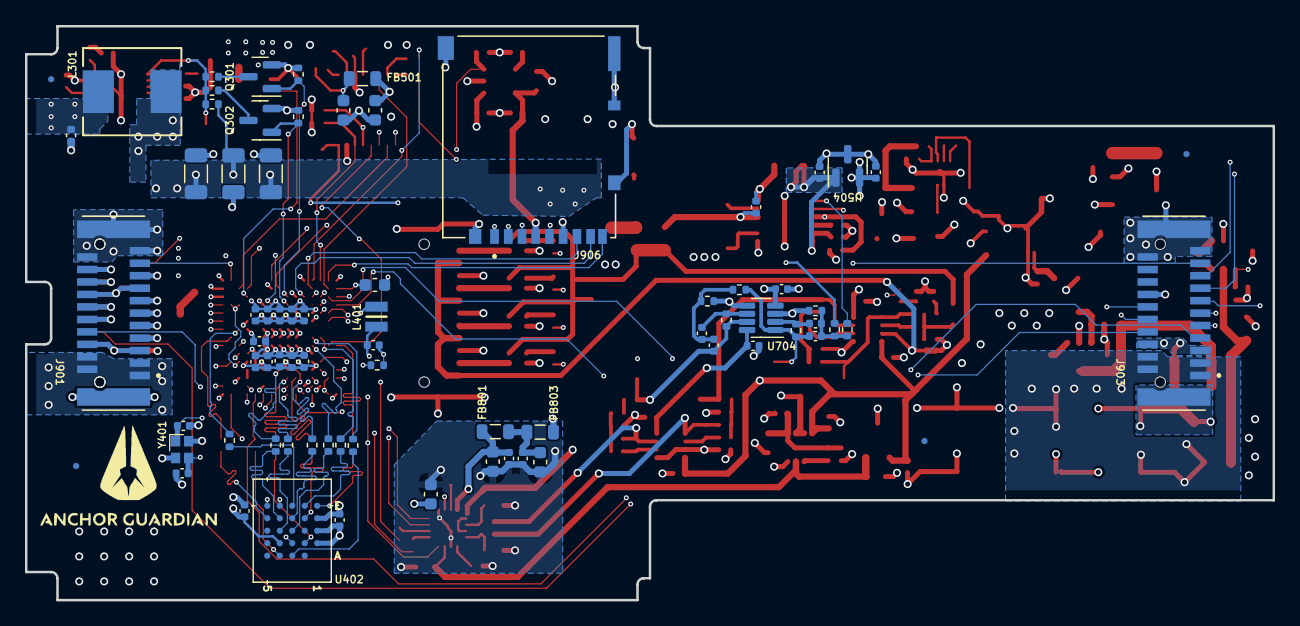
[picture p51: board pp1_vsensor_v4.kicad_pcb from below]

Board: 6 copper layers, 100.0 x 46.0 mm, 249 parts (77 on the bottom side), 175 nets.

Other parts of the board:
C302, C508, C509, C510: 1.5u; C_1206_3216Metric
C304, C305, C420: 1u; C_0402_1005Metric
C306: 2.2n; C_0402_1005Metric
Q301, Q302: PMV45EN2; SOT-23
R301: 1M; R_0402_1005Metric
R302: 34k8; R_0402_1005Metric
R303: 71k5; R_0402_1005Metric
R304: 130k; R_0402_1005Metric
R305: 22k1; R_0402_1005Metric
R306: 0R; R_0402_1005Metric
R309, R310, R311, R501, R502: 68k1; R_0402_1005Metric
TP301: VFBDRIVE; TestPoint_Pad_D1.0mm
U302: LT8361; SOP50P490X110-17N

Their connections:
+3V3: C420.1, R501.1, R502.1; also elsewhere on the board
/High Voltage Supply/SWBOOST: U302.14 (SW2), U302.16 (SW1); also elsewhere on the board
/High Voltage Supply/Sync_Mode: R306.1, U302.12 (SYNC/MODE)
/High Voltage Supply/VDriveIN: C305.1, U302.1 (EN/UVLO), U302.3 (VIN); also elsewhere on the board
/High Voltage Supply/VSel0: Q301.1 (G), R310.1; also elsewhere on the board
/High Voltage Supply/VSel1: Q302.1 (G), R309.1; also elsewhere on the board
/Microcontroller/DDS_FSync: R502.2; also elsewhere on the board
/Microcontroller/DDS_Standby: R501.2; also elsewhere on the board
/Microcontroller/HV_ENABLE: R311.1; also elsewhere on the board
unnamed: Q301.3 (D), R302.2
unnamed: Q302.3 (D), R303.2
unnamed: R301.2, R302.1, R303.1, R304.1, TP301.1, U302.9 (FBX)
unnamed: C304.1, U302.5 (INTVCC)
unnamed 132: U302.10 (RT); also elsewhere on the board
unnamed 133: U302.11 (SS); also elsewhere on the board
unnamed: R305.1, U302.8 (VC)
