edgarvela-soc/vsensor_v4_temp/firmware/firmware.ioc

Mcu.UserName=STM32H725IGKx
PA0.GPIO_Label=TIM_CS
PA0.Signal=S_TIM2_CH1_ETR
PA0_C.GPIO_Label=AIN_1
PA0_C.Signal=ADCx_INP0
PA11.GPIO_Label=DDS_STANDBY
PA11.Signal=GPIO_Output
PA13(JTMS/SWDIO).Signal=DEBUG_JTMS-SWDIO
PA14(JTCK/SWCLK).Signal=DEBUG_JTCK-SWCLK
PA1_C.GPIO_Label=AIN_2
PA1_C.Signal=ADCx_INP1
PA3.GPIO_Label=TIM_SCLK
PA3.Signal=S_TIM15_CH2
PA4.GPIO_Label=DDS_FSYNC
PA4.Signal=SPI6_NSS
PA6.GPIO_Label=DDS_INTERRUPT
PA6.Signal=S_TIM13_CH1
PA7.GPIO_Label=DDS_SDA
PA7.Signal=SPI6_MOSI
PA8.Signal=RCC_MCO_1
PA9.GPIO_Label=DRV_FAULT
PA9.Signal=GPIO_Input
PB10.GPIO_Label=ADC_SCLKA
PB10.Signal=SPI2_SCK
PB9.GPIO_Label=ADC_CSA
PB9.Signal=SPI2_NSS
PC10.GPIO_Label=SD_D2
PC10.Signal=SDMMC1_D2
PC11.GPIO_Label=SD_D3
PC11.Signal=SDMMC1_D3
PC12.GPIO_Label=SD_CLK
PC12.Signal=SDMMC1_CK
PC14-OSC32_IN.GPIO_Label=Rx_Ena
PC14-OSC32_IN.Signal=GPIO_Output
PC2.GPIO_Label=ADC_SDI
PC2.Signal=SPI2_MISO
PC3.GPIO_Label=ADC_SDOA
PC3.Signal=SPI2_MOSI
PC7.GPIO_Label=DDS_SYNCOUT
PC7.Signal=GPIO_Input
PC8.GPIO_Label=SD_D0
PC8.Signal=SDMMC1_D0
PC9.GPIO_Label=SD_D1
PC9.Signal=SDMMC1_D1
PD12.GPIO_Label=VSEN_D1
PD12.Signal=GPIO_Output
PD14.GPIO_Label=VSENS_uc_RX
PD14.Signal=UART9_RX
PD15.GPIO_Label=VSENS_uc_TX
PD15.Signal=UART9_TX
PD2.GPIO_Label=SD_CMD
PD2.Signal=SDMMC1_CMD
PE1.GPIO_Label=VSENS_D2
PE1.Signal=GPIO_Output
PE12.GPIO_Label=ADC_SCLKB
PE12.Signal=SPI4_SCK
PE4.GPIO_Label=ADC_CSB
PE4.Signal=SPI4_NSS
PE5.GPIO_Label=ADC_SDOB
PE5.Signal=SPI4_MISO
PF0.GPIO_Label=uc_dram_dq0
PF0.Signal=OCTOSPIM_P2_IO0
PF1.GPIO_Label=uc_dram_dq1
PF1.Signal=OCTOSPIM_P2_IO1
PF11.GPIO_Label=DRV_EN
PF11.Signal=TIM24_CH1
PF2.GPIO_Label=uc_dram_dq2
PF2.Signal=OCTOSPIM_P2_IO2
PF3.GPIO_Label=uc_dram_dq3
PF3.Signal=OCTOSPIM_P2_IO3
PF4.GPIO_Label=uc_dram_ck
PF4.Signal=OCTOSPIM_P2_CLK
PG0.GPIO_Label=uc_dram_dq4
PG0.Signal=OCTOSPIM_P2_IO4
PG1.GPIO_Label=uc_dram_dq5
PG1.Signal=OCTOSPIM_P2_IO5
PG10.GPIO_Label=uc_dram_dq6
PG10.Signal=OCTOSPIM_P2_IO6
PG11.GPIO_Label=uc_dram_dq7
PG11.Signal=OCTOSPIM_P2_IO7
PG12.GPIO_Label=uc_dram_ncs
PG12.Signal=OCTOSPIM_P2_NCS
PG13.GPIO_Label=DDS_SCLK
PG13.Signal=SPI6_SCK
PG15.GPIO_Label=uc_dram_rwds
PG15.Signal=OCTOSPIM_P2_DQS
PH10.GPIO_Label=DDS_CTRL
PH10.Signal=S_TIM5_CH1
PH14.GPIO_Label=SD_EN3V3
PH14.Signal=GPIO_Output
PH15.GPIO_Label=SD_DETECT
PH15.Signal=GPIO_Output
PH9.GPIO_Label=VSENS_D0
PH9.Signal=S_TIM12_CH2
